holgiw/TFT-Clock-GC9A01/pictures/20261001_135719.jpg

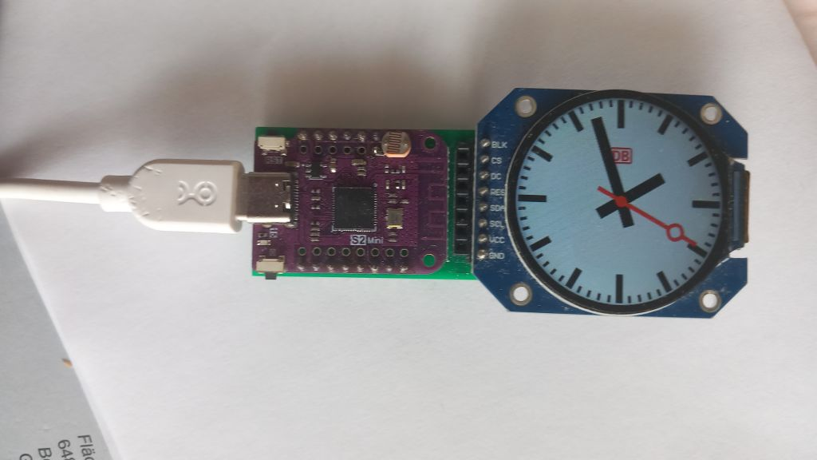
pictures/20261001_135719.jpg
