holgiw/TFT-Clock-GC9A01/graphic/160/face_clock_alt1.bmp

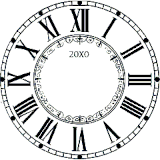
graphic/160/face_clock_alt1.bmp
