holgiw/TFT-Clock-GC9A01/graphic/160/face_daniel.bmp

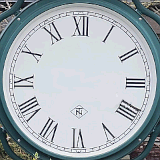
graphic/160/face_daniel.bmp
