holgiw/TFT-Clock-GC9A01/graphic/240/face_daniel.bmp

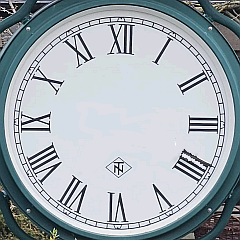
graphic/240/face_daniel.bmp
