holgiw/TFT-Clock-GC9A01/graphic/240/face_easterbunny.bmp

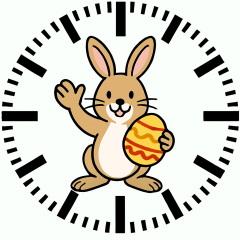
graphic/240/face_easterbunny.bmp
