holgiw/TFT-Clock-GC9A01/PCB/ELV_DCF77.jpg

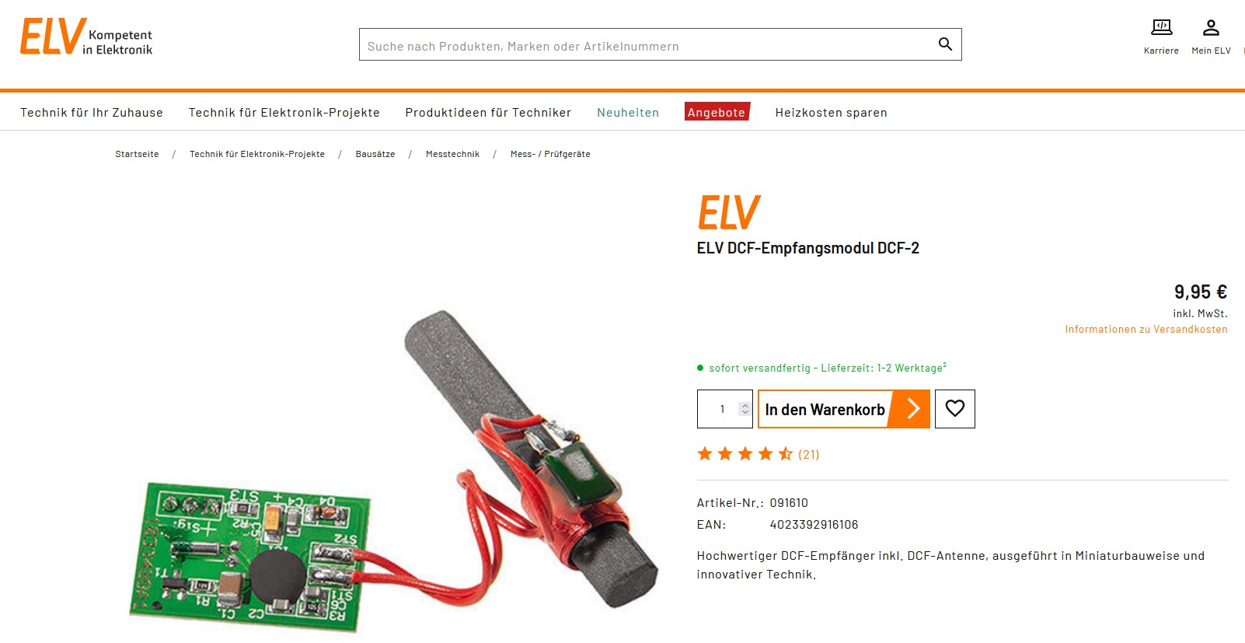
PCB/ELV_DCF77.jpg
