holgiw/TFT-Clock-GC9A01/PCB/ESP32-S2 GC9A01_RTC.jpg

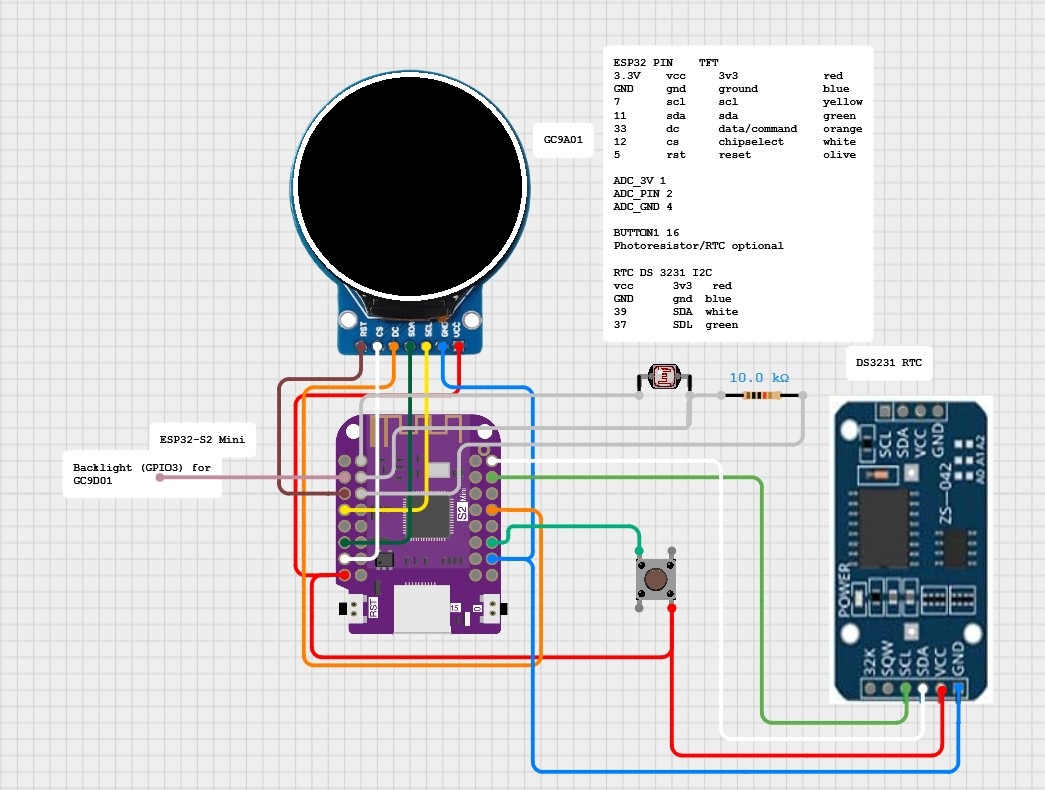
PCB/ESP32-S2 GC9A01_RTC.jpg
