holgiw/TFT-Clock-GC9A01/PCB/ESP32-S2 GC9A01_RTC_DCF77.jpg

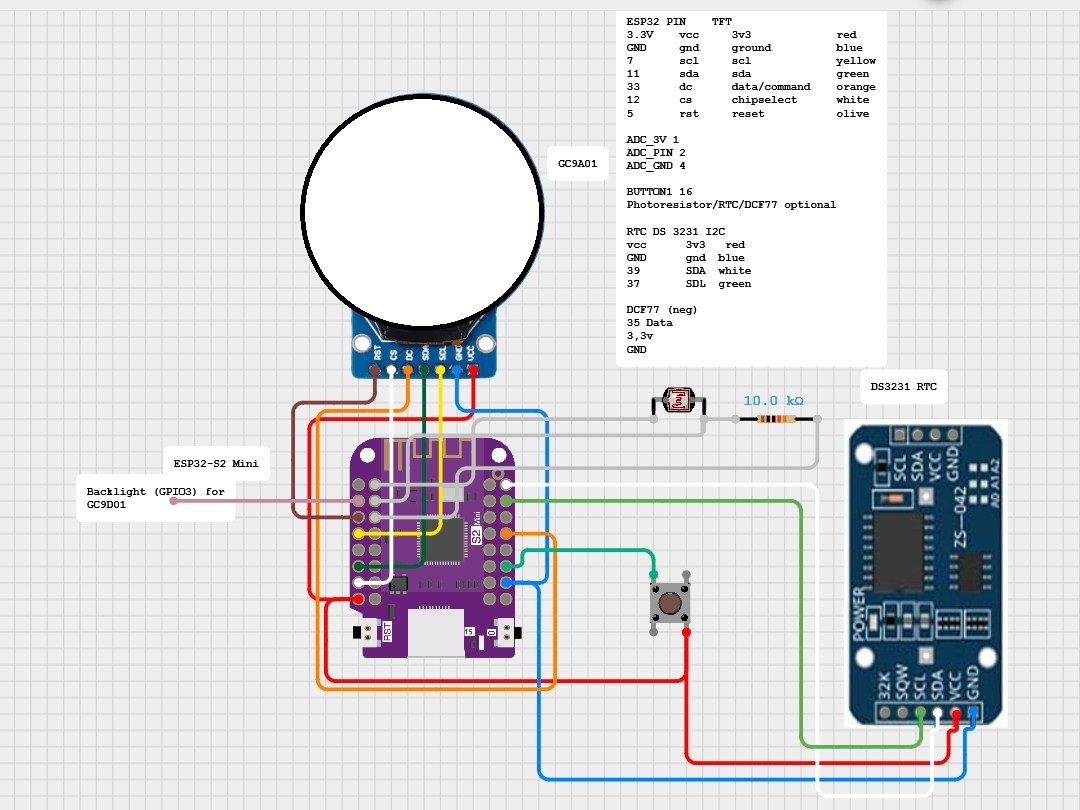
PCB/ESP32-S2 GC9A01_RTC_DCF77.jpg
