holgiw/TFT-Clock-GC9A01/PCB/esp32-s2_mini.png

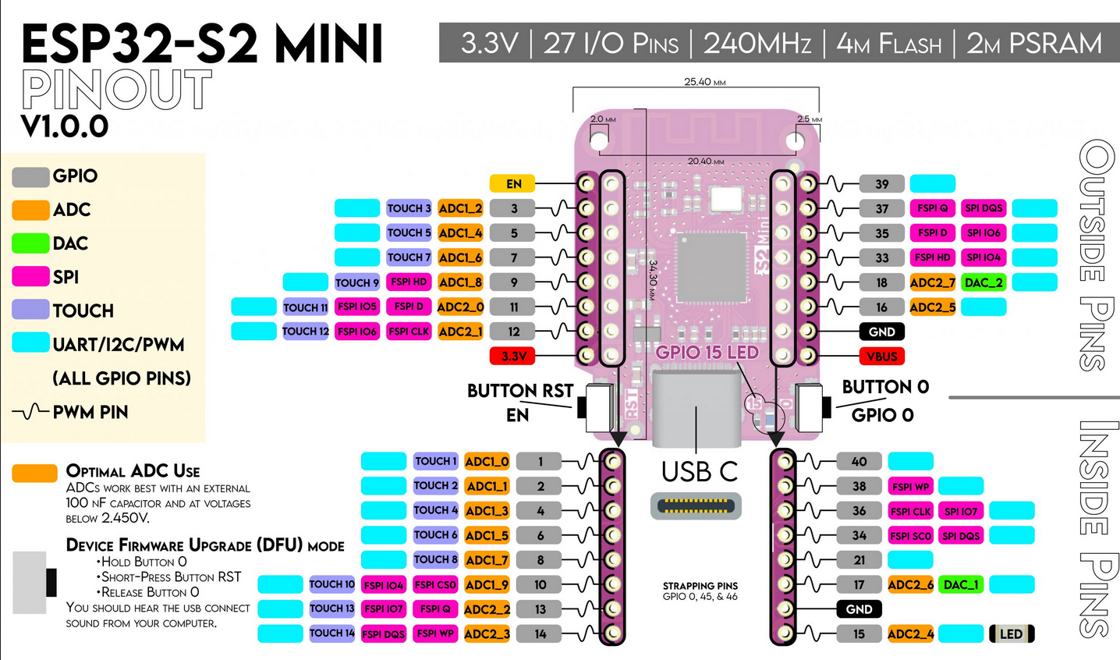
PCB/esp32-s2_mini.png
