holgiw/TFT-Clock-GC9A01/pictures/20261001_135748.jpg

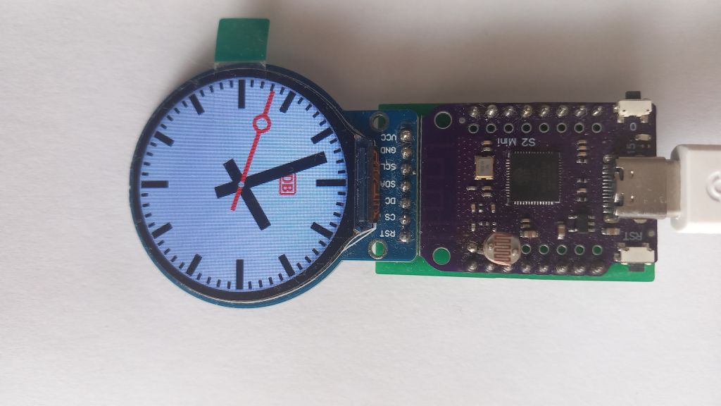
pictures/20261001_135748.jpg
