holgiw/TFT-Clock-GC9A01/pictures/20261001_135905.jpg

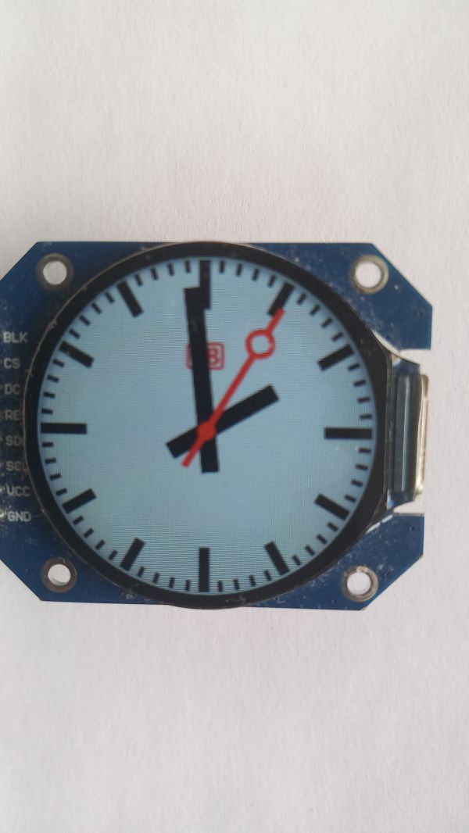
pictures/20261001_135905.jpg
