holgiw/TFT-Clock-GC9A01/pictures/20261001_140028.jpg

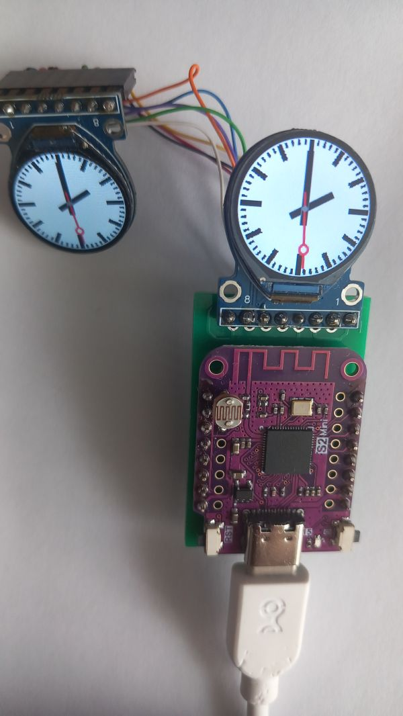
pictures/20261001_140028.jpg
