holgiw/TFT-Clock-GC9A01/pictures/20261007_082601.jpg

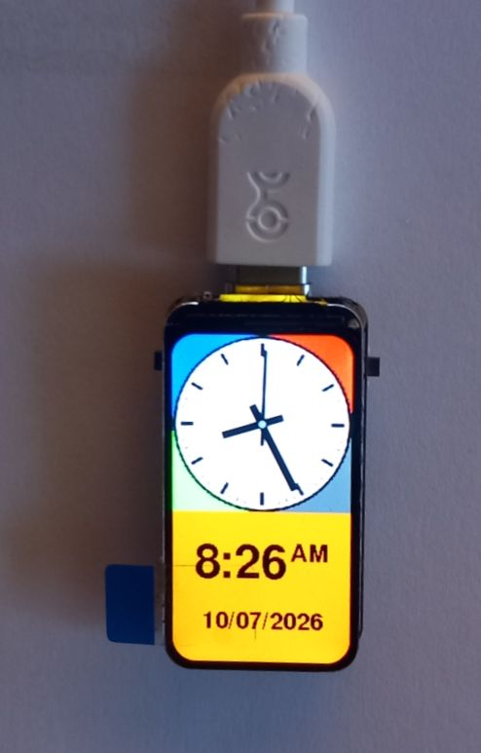
pictures/20261007_082601.jpg
