holgiw/TFT-Clock-GC9A01/screenshots/de/dateimanager.png

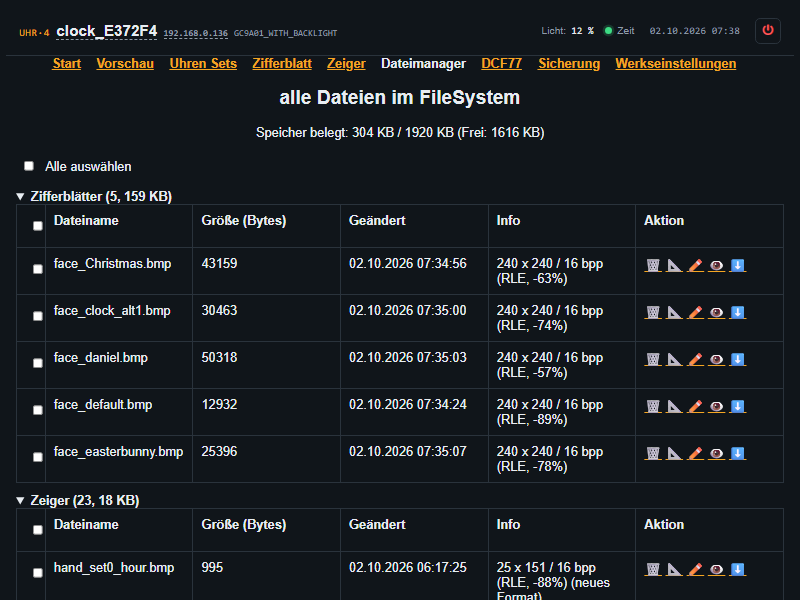
screenshots/de/dateimanager.png
