holgiw/TFT-Clock-GC9A01/screenshots/de/dcf77.png

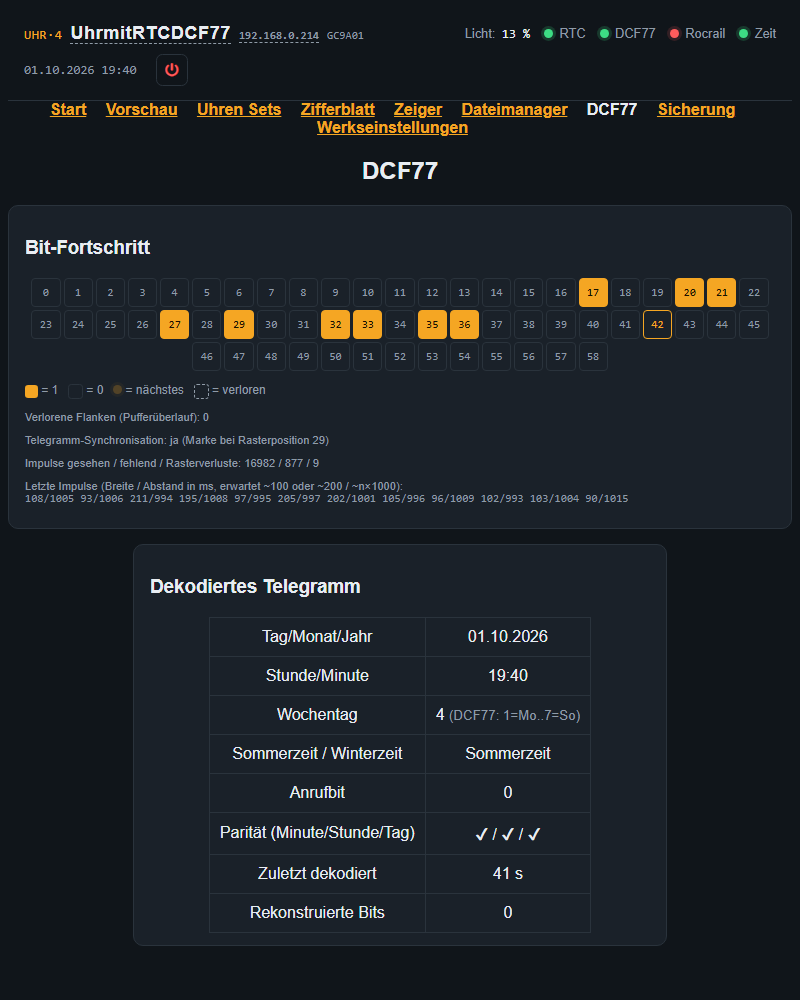
screenshots/de/dcf77.png
