holgiw/TFT-Clock-GC9A01/screenshots/de/helligkeit.png

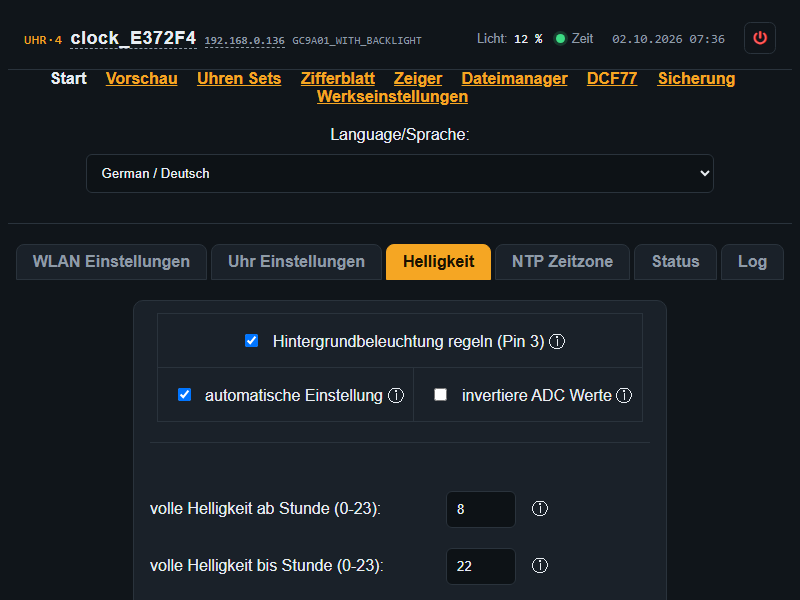
screenshots/de/helligkeit.png
