holgiw/TFT-Clock-GC9A01/screenshots/de/options.png

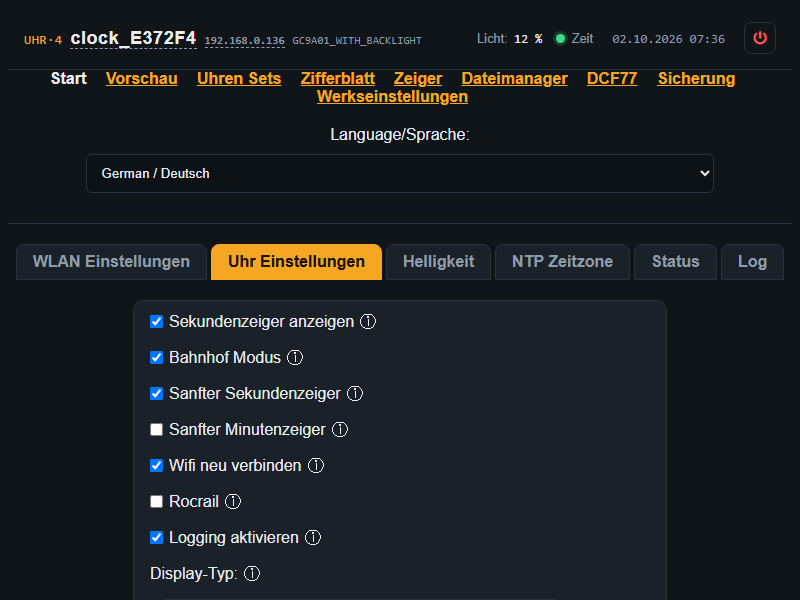
screenshots/de/options.png
