holgiw/TFT-Clock-GC9A01/screenshots/de/rocrail.png

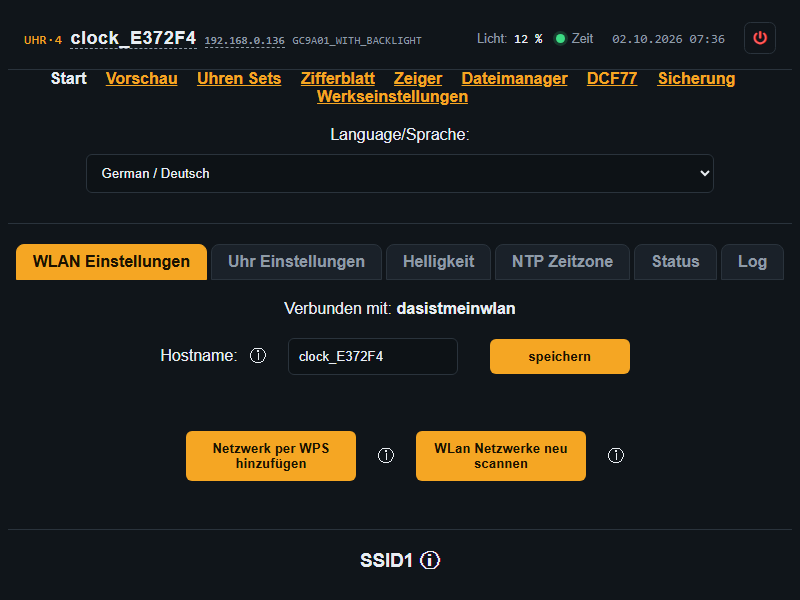
screenshots/de/rocrail.png
