holgiw/TFT-Clock-GC9A01/screenshots/de/sets.png

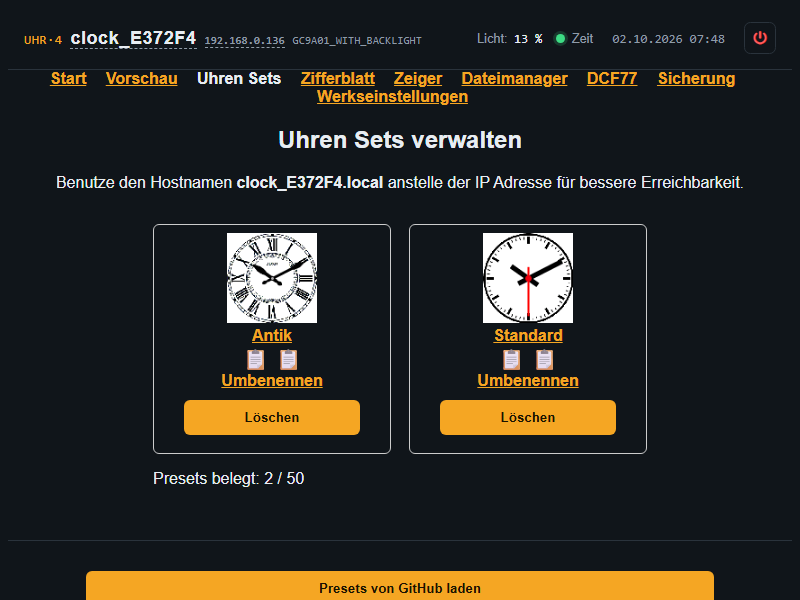
screenshots/de/sets.png
