holgiw/TFT-Clock-GC9A01/screenshots/de/vorschau.png

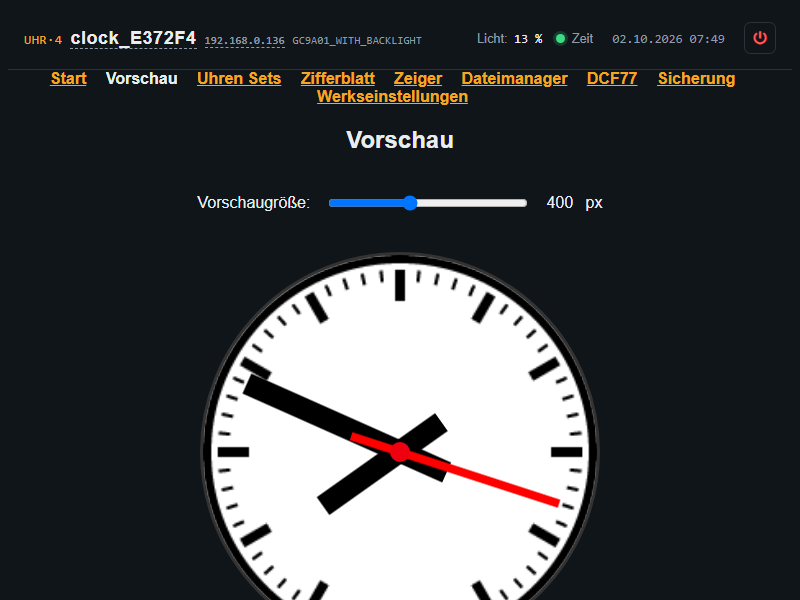
screenshots/de/vorschau.png
