holgiw/TFT-Clock-GC9A01/screenshots/de/vorschau_ili.png

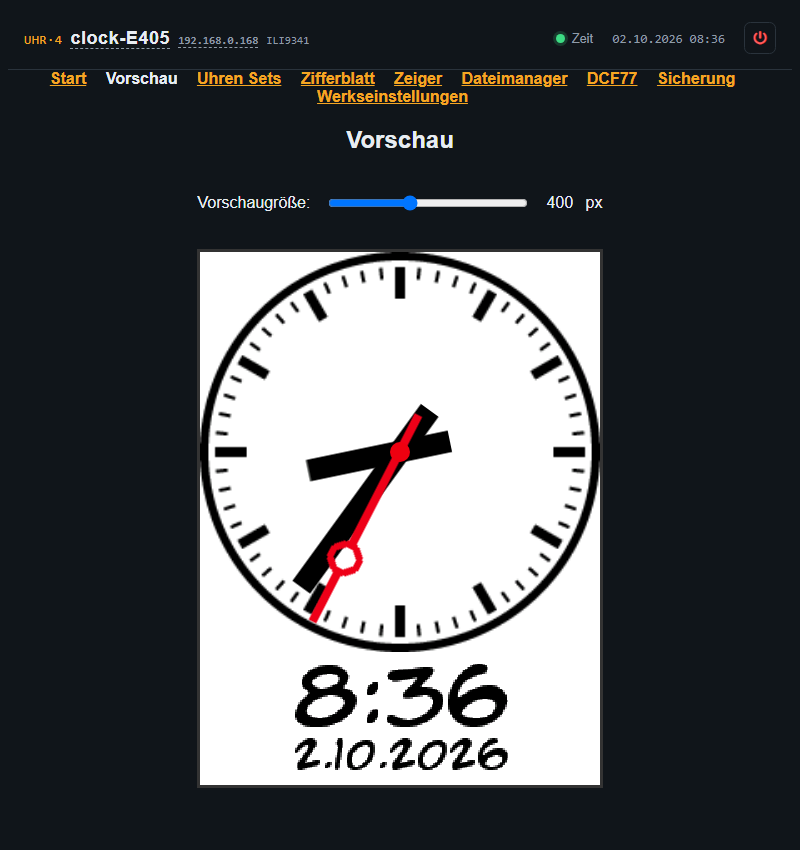
screenshots/de/vorschau_ili.png
