holgiw/TFT-Clock-GC9A01/screenshots/de/zeiger.png

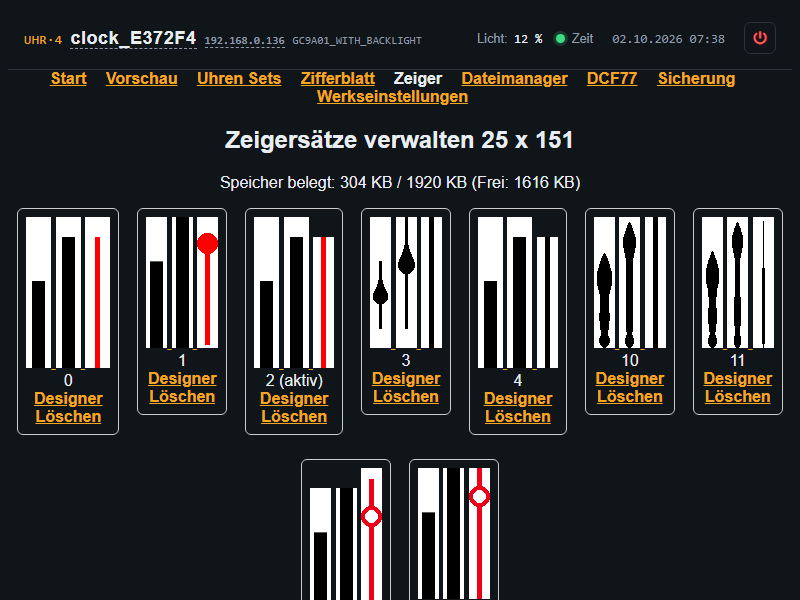
screenshots/de/zeiger.png
