holgiw/TFT-Clock-GC9A01/screenshots/de/zeiger_designer.png

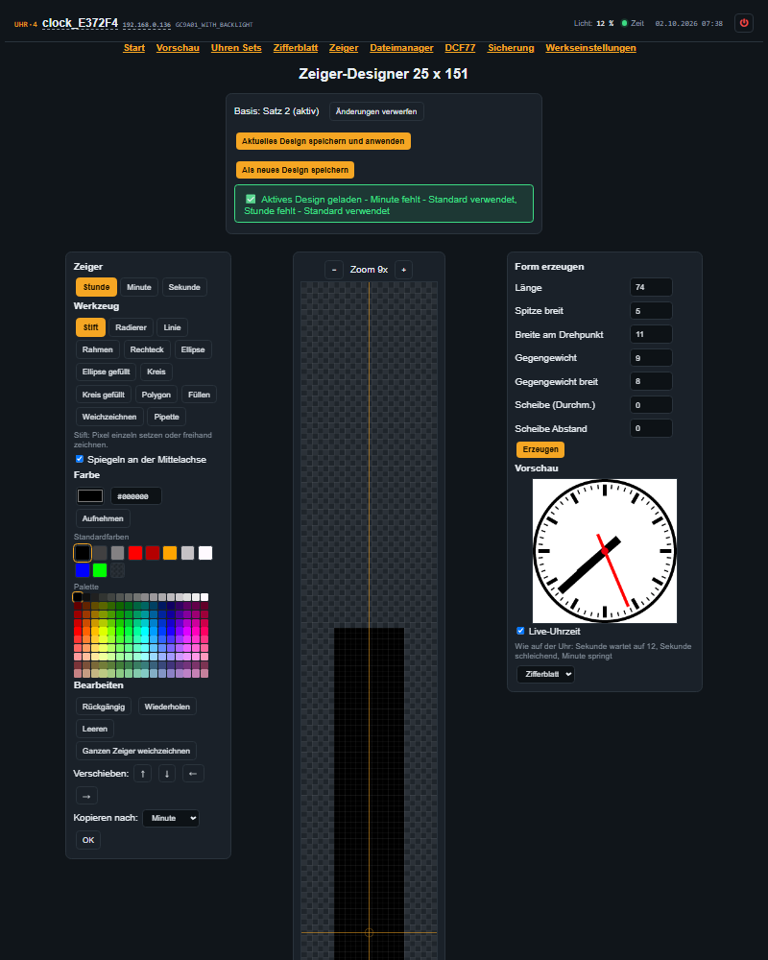
screenshots/de/zeiger_designer.png
