holgiw/TFT-Clock-GC9A01/screenshots/de/zifferblatt.png

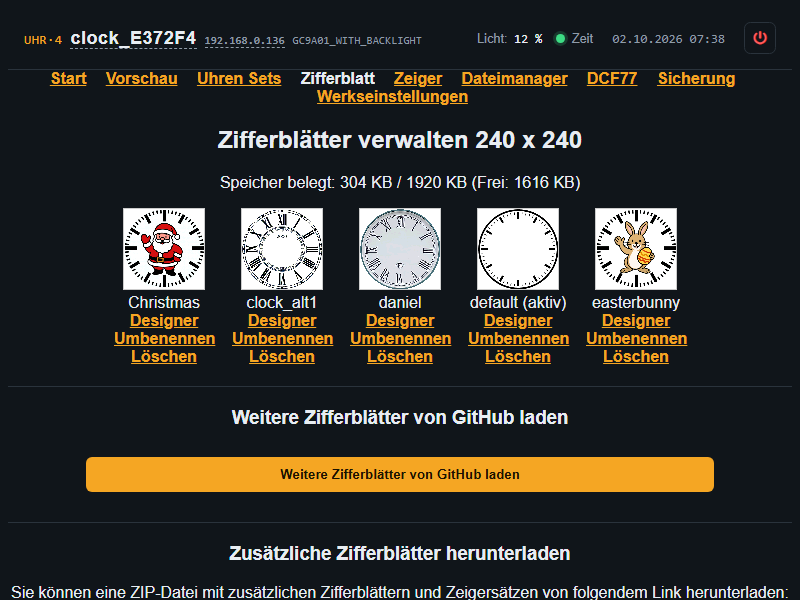
screenshots/de/zifferblatt.png
