holgiw/TFT-Clock-GC9A01/screenshots/de/zifferblatt_designer.png

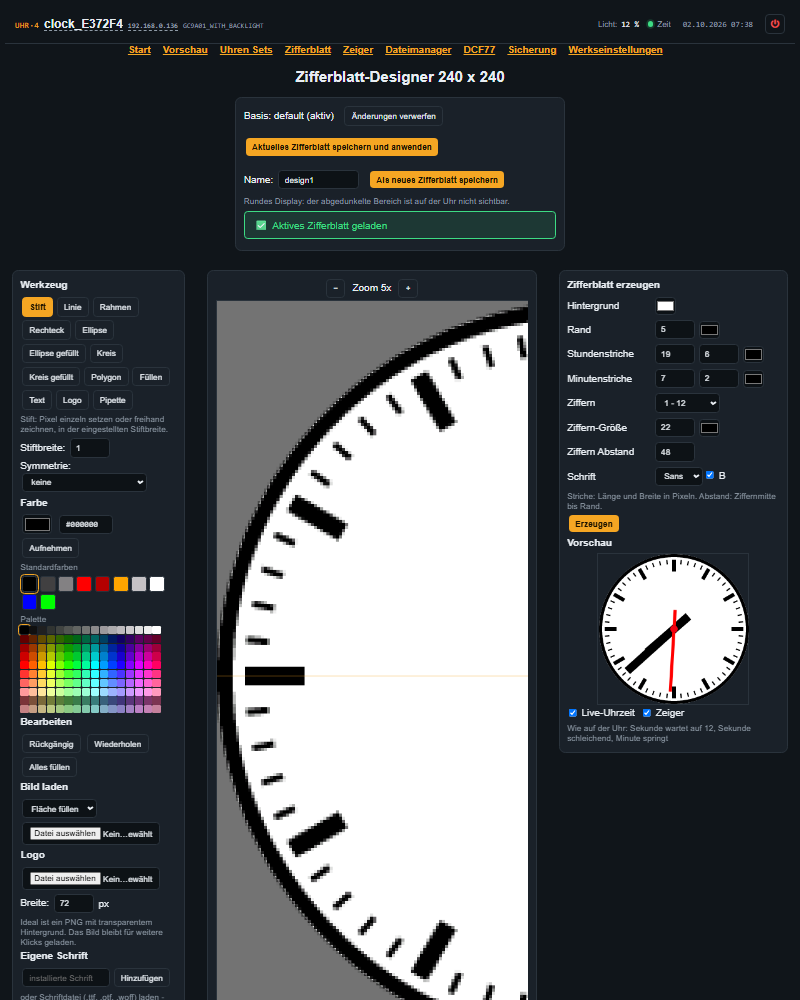
screenshots/de/zifferblatt_designer.png
