holgiw/TFT-Clock-GC9A01/screenshots/de/zifferblatt_designer_ili.png

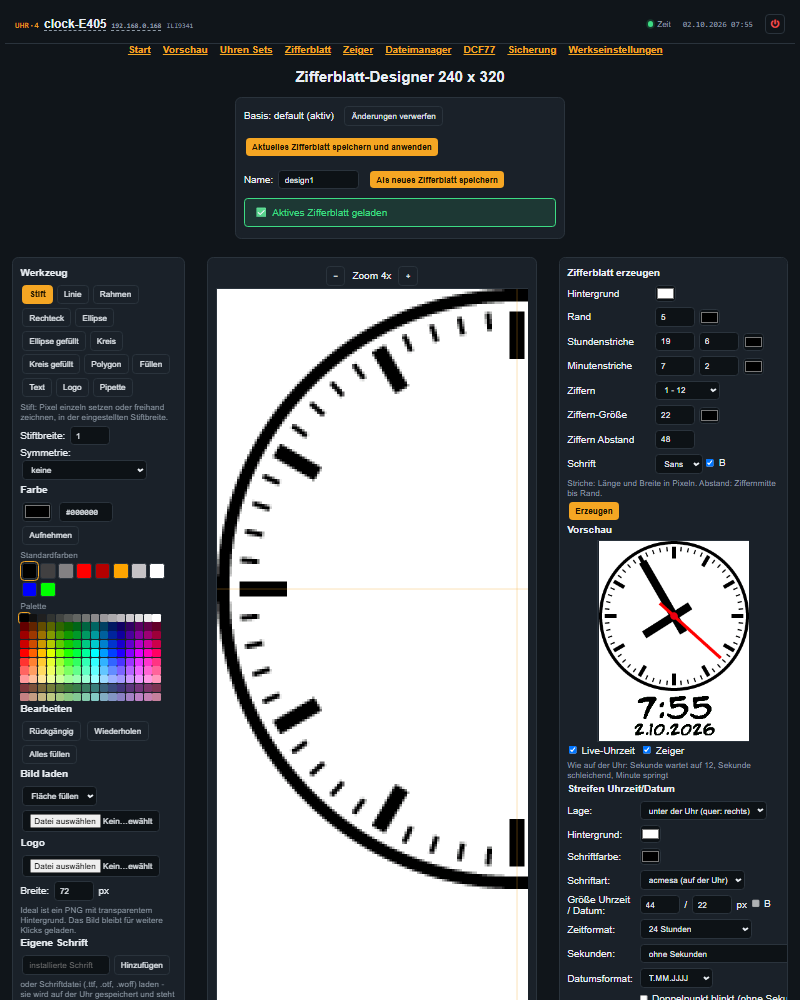
screenshots/de/zifferblatt_designer_ili.png
