holgiw/TFT-Clock-GC9A01/screenshots/en/brightness.png

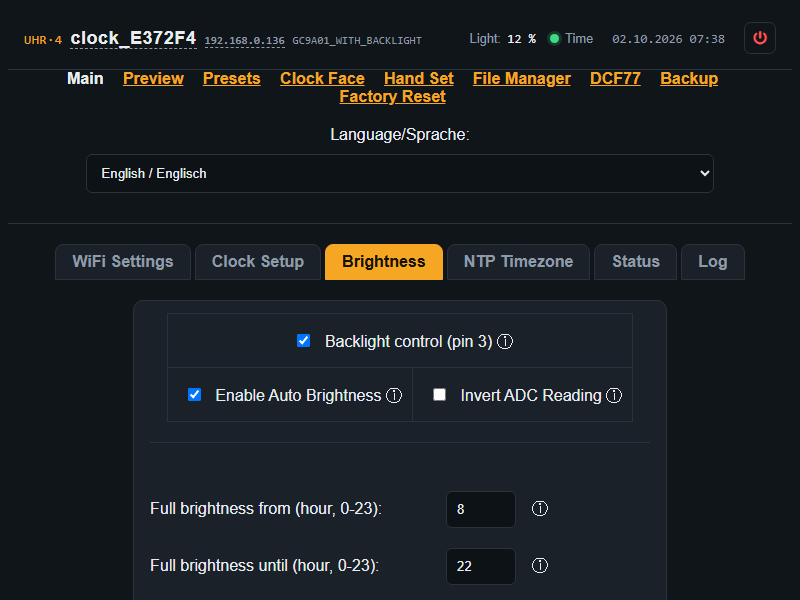
screenshots/en/brightness.png
