holgiw/TFT-Clock-GC9A01/screenshots/en/clock_faces.png

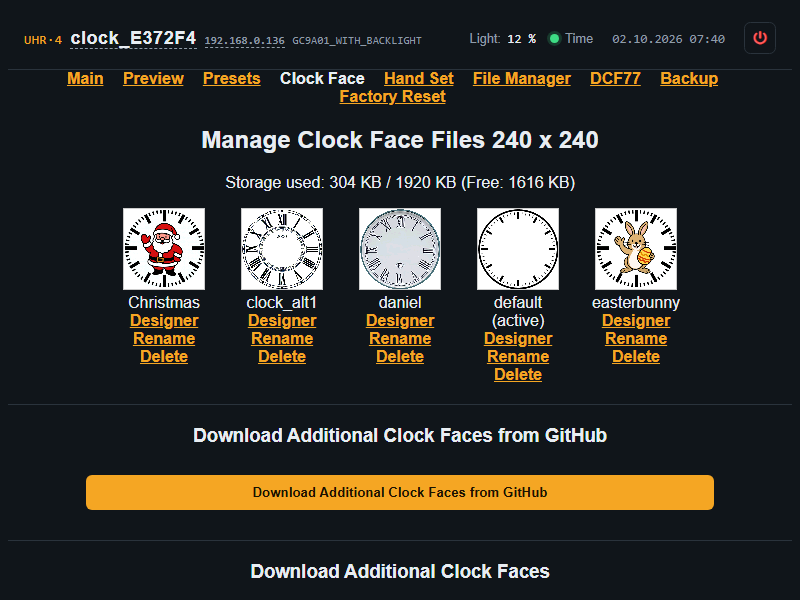
screenshots/en/clock_faces.png
