holgiw/TFT-Clock-GC9A01/screenshots/en/dcf77.png

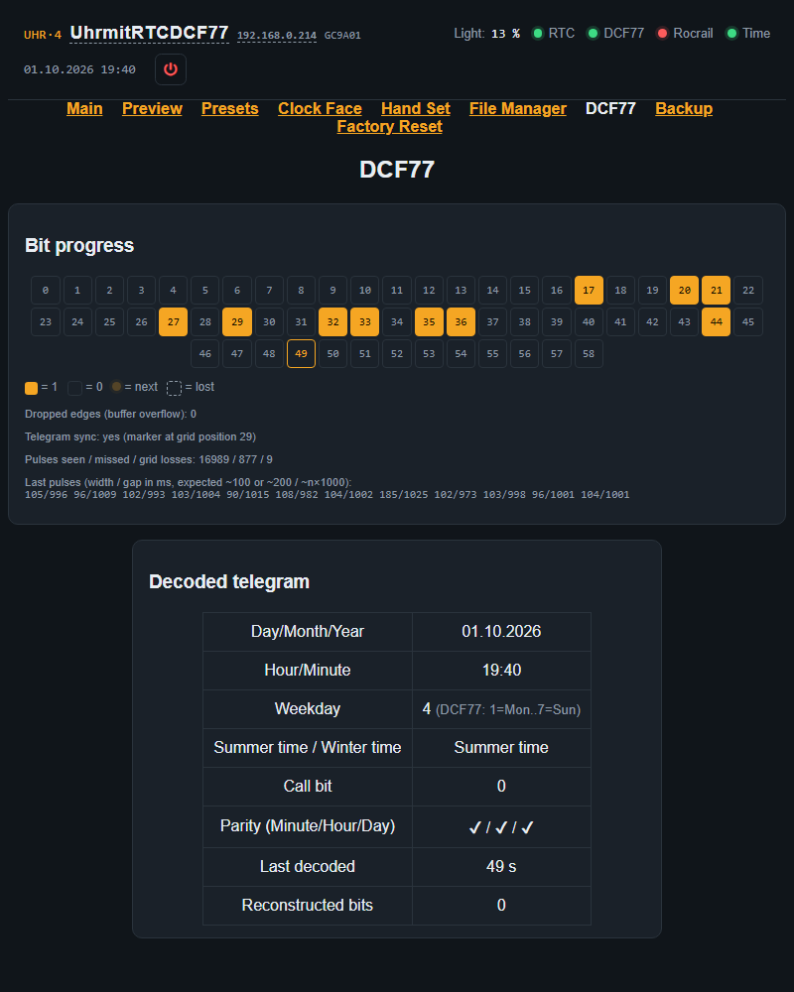
screenshots/en/dcf77.png
