holgiw/TFT-Clock-GC9A01/screenshots/en/hand_designer.png

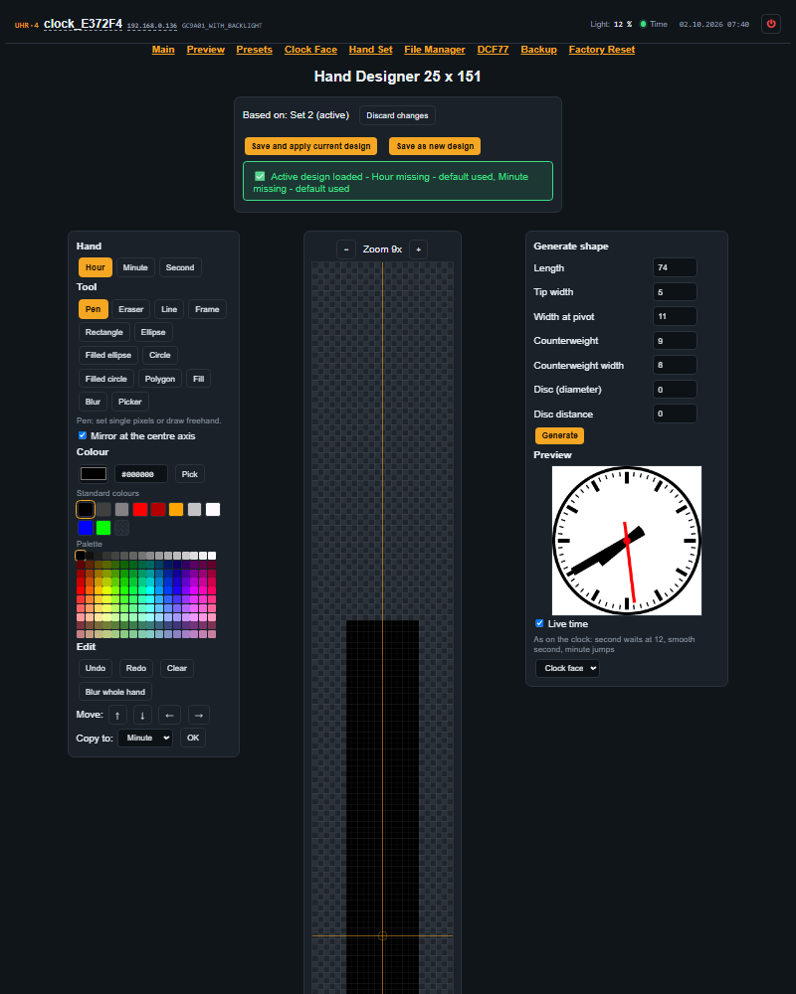
screenshots/en/hand_designer.png
