holgiw/TFT-Clock-GC9A01/screenshots/en/preview_ili.png

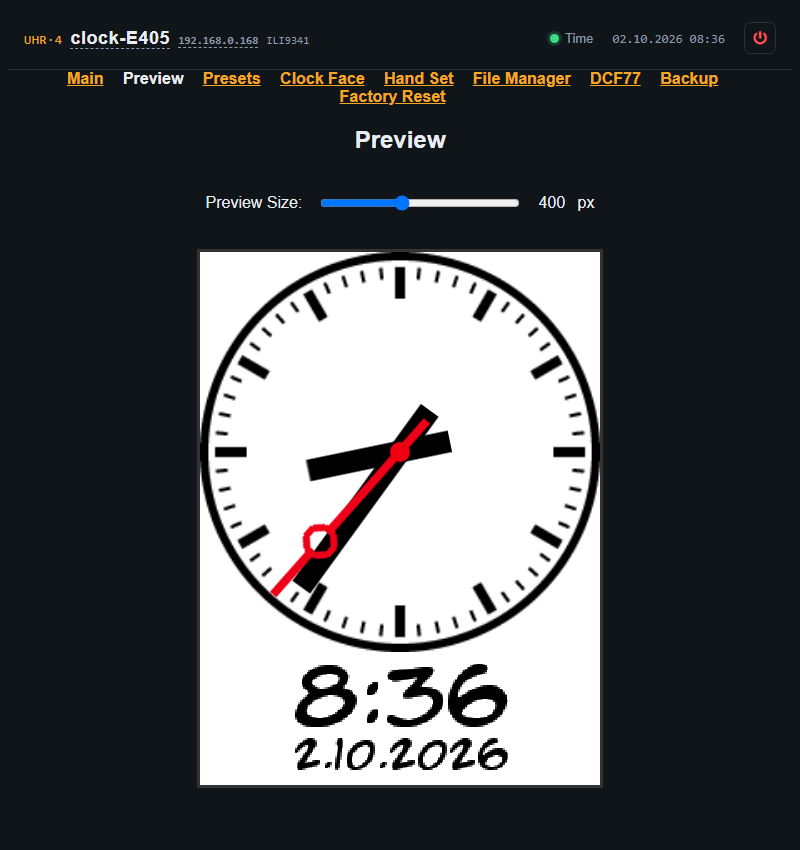
screenshots/en/preview_ili.png
