holgiw/TFT-Clock-GC9A01/screenshots/en/rocrail.png

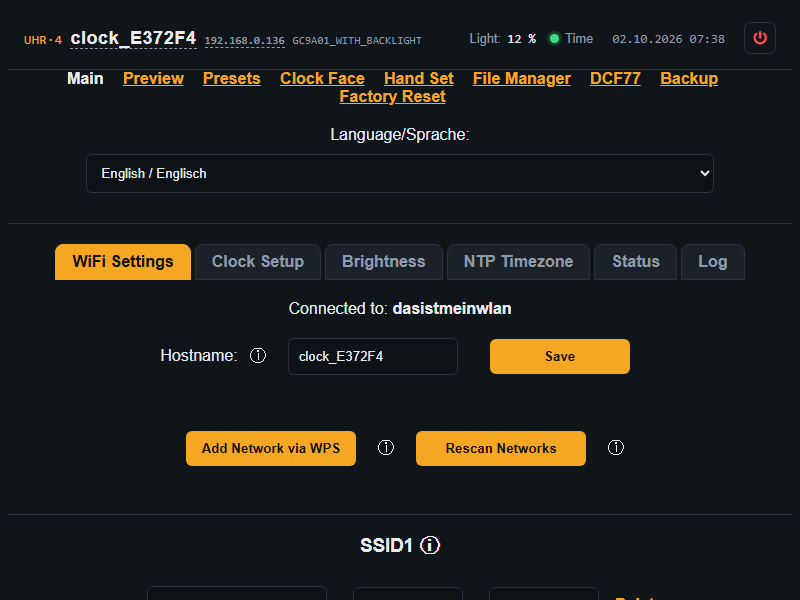
screenshots/en/rocrail.png
