holgiw/TFT-Clock-GC9A01/3d-print/senkrechte_platte_19x30.stl

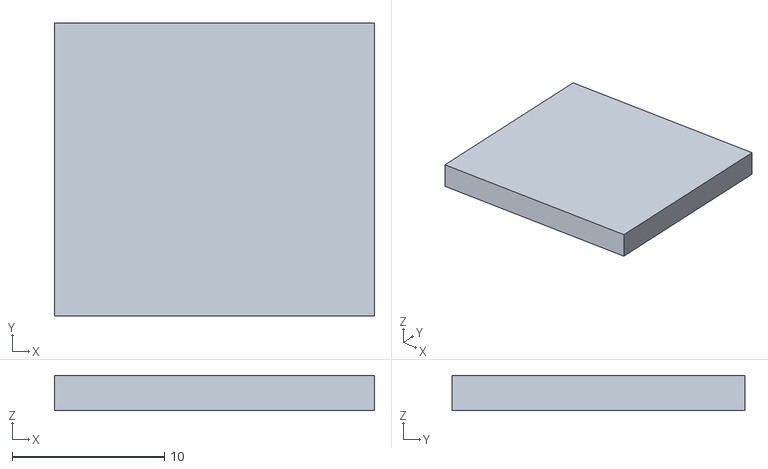
[picture p37: CAD file, 2025-06-24]
3d-print/senkrechte_platte_19x30.stl
21.0 x 19.2 x 2.30
