holgiw/TFT-Clock-GC9A01/3d-print/Grundplatte_rund_Glaskoben.stl

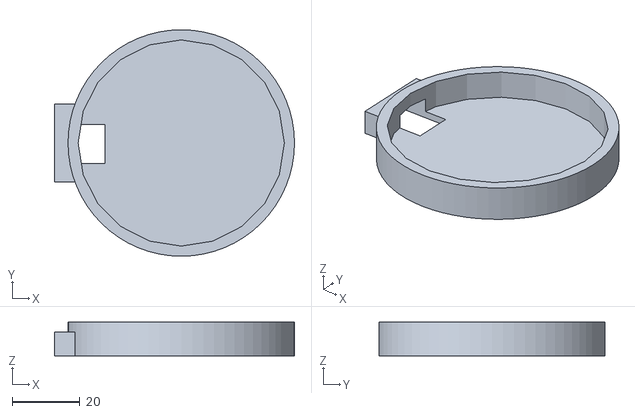
[picture p38: CAD file, 2025-06-24]
3d-print/Grundplatte_rund_Glaskoben.stl
71.0 x 67.0 x 10.0
