holgiw/TFT-Clock-GC9A01/screenshots/en/clock_setup.png

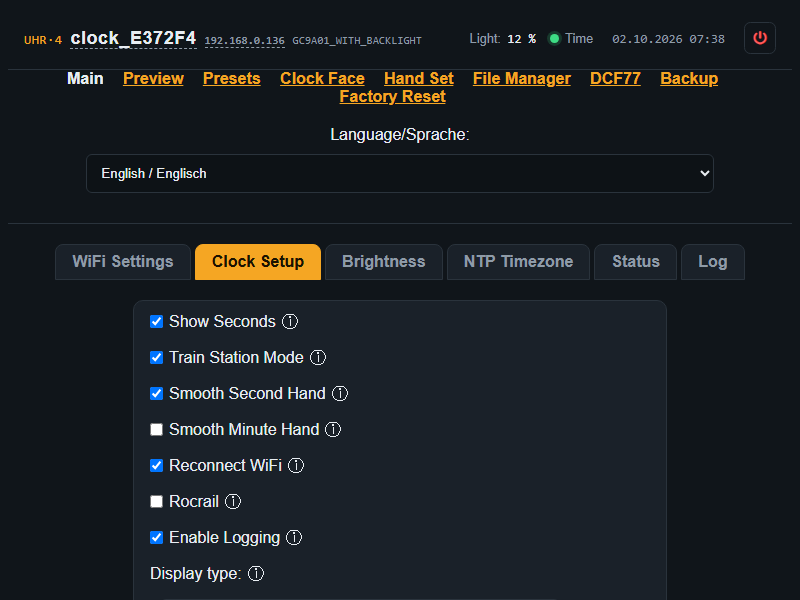
screenshots/en/clock_setup.png
