holgiw/TFT-Clock-GC9A01/(list of files, drawings)

Other design files:
PCB/clock_esp32_S2_mini.lay6
PCB/clock_esp32_S2_mini_RTC.lay6
