holgiw/TFT-Clock-GC9A01/webserver_routes.h

#pragma once

    // Alle HTTP-Routen und HTML-Generierung (benoetigt globals.h, config.h, prefs_keys.h, declarations.h).
    // new (std::nothrow) liefert bei fehlgeschlagener Allokation sicher nullptr.

    // All HTTP routes and HTML generation (requires globals.h, config.h, prefs_keys.h, declarations.h). new
    // (std::nothrow) reliably returns nullptr on a failed allocation.

#include <new>

    // Tab-Leiste der Startseite an EINER Stelle: Reihenfolge = Anzeige-
    // reihenfolge, index-gleich zu SETTINGS_TAB_LABELS. Genutzt von
    // generateHtmlHeader(), den Radio-Inputs und generateSettingsTabNav().

    // The start page's tab bar in ONE place: order = display order, index-
    // aligned with SETTINGS_TAB_LABELS. Used by generateHtmlHeader(), the
    // start page's radio inputs, and generateSettingsTabNav().

    static const char* const SETTINGS_TAB_KEYS[] = { "wlan", "zifferblatt", "helligkeit", "zeit", "rocrail", "status", "log" };

    // Uebersetzungsschluessel je Tab (siehe translation.h). "Status"/"Log"
    // stehen bewusst am Ende (Diagnose nach dem Einrichtungsablauf).
    // "Rocrail" bleibt unuebersetzt, wie auch "DCF77" ein Protokollname bleibt.

    // Translation key per tab (see translation.h). "Status"/"Log" are
    // deliberately last (diagnostics after the setup flow). "Rocrail" stays
    // untranslated, the same way "DCF77" stays a protocol name.

    static const char* const SETTINGS_TAB_LABELS[] = { "WiFi Settings", "Clock Setup", "Brightness", "NTP&nbsp;Timezone", "Rocrail", "Status", "Log" };

    static const size_t SETTINGS_TAB_COUNT = sizeof(SETTINGS_TAB_KEYS) / sizeof(SETTINGS_TAB_KEYS[0]);


    // Generiert den HTML-Header für die Weboberfläche
    // Generates the HTML header for the web interface

    String generateHtmlHeader(String extraHead) {
        String html = "<!DOCTYPE html><html><head><meta name=\"viewport\" content=\"width=device-width, initial-scale=1\">";
        html.reserve(5000);  // Vorab reservierter Speicher fuer CSS+HTML
                              // Pre-reserved capacity for CSS+HTML

        // Dunkles Theme mit CSS-only Tab-Mechanik (verstecktes radio-Input +
        // Label + Selektor "~") fuer die Tab-Hub-Startseite. Gilt sitenweit,
        // damit alle Seiten optisch einheitlich bleiben.

        // Dark theme with a CSS-only tab mechanism (hidden radio input +
        // label + "~" selector) for the tab-hub home page. Applies site-wide
        // so every page stays visually consistent.

        html += "<style>";
        html += ":root{--bg:#10151a;--panel:#1a2129;--panel-border:#2a333c;--text:#e8edf2;--muted:#8f9ba7;--accent:#f5a623;--accent-dim:#7a530f;--ok:#3ddc84;--bad:#ff5c5c;--mono:ui-monospace,\"SFMono-Regular\",Menlo,Consolas,monospace;}";

        // Meldungen einheitlich im dunklen Design: .msg.ok Erfolg, .msg.warn Hinweis, .msg.err Fehler - das Symbol
        // setzt das CSS, der Text bleibt ohne.

        // Messages uniform in the dark design: .msg.ok success, .msg.warn note, .msg.err error - the CSS sets the
        // symbol, the text stays without.

        html += ".msg{border:1px solid;border-radius:6px;padding:10px 15px;margin:10px auto;max-width:500px;}";
        html += ".msg::before{margin-right:.45em;}";
        html += ".msg.ok{background:rgba(61,220,132,.12);color:var(--ok);border-color:var(--ok);}.msg.ok::before{content:\"\\2705\";}";
        html += ".msg.warn{background:rgba(245,166,35,.12);color:var(--accent);border-color:var(--accent);}.msg.warn::before{content:\"\\26A0\";}";
        html += ".msg.err{background:rgba(255,92,92,.12);color:var(--bad);border-color:var(--bad);}.msg.err::before{content:\"\\274C\";}";

        // Bewusst kein padding-top auf body: die Topbar ist sticky
        // positioniert und wuerde sonst mitverschoben statt nur der Inhalt
        // darunter.

        // Deliberately no padding-top on body: the topbar is sticky-
        // positioned and would otherwise shift down too, not just the
        // content below it.

        html += "body{font-family:Arial,Helvetica,sans-serif;text-align:center;background:var(--bg);color:var(--text);}";
        html += "input,select,button{margin:10px;padding:10px;width:80%;box-sizing:border-box;background:#0d1216;color:var(--text);border:1px solid var(--panel-border);border-radius:6px;}";
        html += "input[type=checkbox],input[type=radio]{width:auto;}";
        html += "button,button[type=submit],input[type=submit]{background:var(--accent);color:#1a1200;font-weight:bold;border:none;cursor:pointer;}";
        html += "button:hover,input[type=submit]:hover{background:#ffb84d;}";
        html += "h1,h2,h3{color:var(--text);}";
        html += "hr{border:0;height:1px;background-color:var(--panel-border);margin:20px 0;}";
        html += "table{margin:auto;border-collapse:collapse;}"; // Tabellen zentrieren
                                                                // center tables
        html += "th,td{padding:10px;text-align:center;border:1px solid var(--panel-border);}"; // Tabellenzellen
                                                                                               // table cells
        html += "li{text-align:left;color:var(--text);}"; // <li> linksbündig formatieren
                                                          // left-align <li>
        html += "a{color:var(--accent);}";
        html += "small{color:var(--muted);}";

        // Statuszeile (Topbar), sitenweit oben auf jeder Seite - siehe
        // generateTopBar() fuer die Markup-Erzeugung.

        // Status bar (topbar), site-wide at the top of every page - see
        // generateTopBar() for the markup generation.

        html += ".topbar{display:flex;flex-wrap:wrap;align-items:center;gap:.6rem 1.2rem;padding:.9rem 1rem;border-bottom:1px solid var(--panel-border);position:sticky;top:0;background:var(--bg);z-index:5;}";
        html += ".brand{display:flex;align-items:baseline;gap:.5rem;margin-right:auto;}";
        html += ".brand-mark{font-family:var(--mono);color:var(--accent);font-size:.8rem;letter-spacing:.05em;}";
        html += ".topbar h1{font-size:1.15rem;margin:0;letter-spacing:.02em;}";
        html += ".topbar h1 a.host-link{color:inherit;text-decoration:none;border-bottom:1px dashed var(--muted);}";
        html += ".topbar h1 a.host-link:hover{color:var(--accent);border-bottom-color:var(--accent);}";
        html += ".ip-hint{font-family:var(--mono);font-size:.7rem;color:var(--muted);}";

        // font-size hier bewusst "inherit" statt weggelassen, um nicht von
        // Vererbung abhaengig zu sein, falls spaeter eine Regel dazwischenfunkt.

        // font-size deliberately "inherit" rather than omitted, to not rely
        // on inheritance in case another rule interferes later.

        html += ".ip-hint a{color:inherit;font-size:inherit;text-decoration:none;border-bottom:1px dashed var(--muted);}";
        html += ".ip-hint a:hover{color:var(--accent);border-bottom-color:var(--accent);}";
        html += ".status-strip{display:flex;gap:.9rem;flex-wrap:wrap;}";
        html += ".status{display:flex;align-items:center;gap:.4rem;font-size:.8rem;color:var(--muted);}";

        // .status setzt "display:flex", was das native 'hidden'-Attribut
        // ueberschreibt (Autoren-CSS gewinnt immer gegen User-Agent-CSS).
        // Diese Regel stellt das 'hidden'-Verhalten explizit wieder her.

        // .status sets "display:flex", which overrides the native 'hidden'
        // attribute (author CSS always wins over user-agent CSS). This rule
        // explicitly restores 'hidden' behavior.

        html += ".status[hidden]{display:none;}";

        // display:inline-block noetig, sonst ignorieren Browser width/height
        // bei einem leeren <span> ausserhalb eines Flex-Kontexts (.status) -
        // der Punkt wuerde eckig statt rund erscheinen.

        // display:inline-block needed, otherwise browsers ignore width/height
        // on an empty <span> outside a flex context (.status) - the dot
        // would render square instead of round.

        html += ".dot{display:inline-block;width:.55rem;height:.55rem;border-radius:50%;background:var(--bad);box-shadow:0 0 0 3px rgba(255,92,92,.15);}";
        html += ".dot.ok{background:var(--ok);box-shadow:0 0 0 3px rgba(61,220,132,.18);}";

        // "na" (grau) gilt nur fuer den Zeit-Punkt (Systemzeit noch nie gesetzt) - bei RTC/DCF77 blendet
        // fehlende Hardware den ganzen Eintrag aus.

        // "na" (gray) only applies to the Time dot (system time never set) - for RTC/DCF77, missing hardware
        // hides the whole entry.

        html += ".dot.na{background:var(--muted);box-shadow:0 0 0 3px rgba(143,155,167,.18);}";

        // Live-Wertanzeige (z.B. Fotowiderstand-Helligkeit) statt farbigem
        // Punkt - heller Monospace-Text, analog zum Kontrast von .datetime
        // gegenueber seinem Muted-Label.

        // Live value reading (e.g. photoresistor brightness) instead of a
        // colored dot - bright monospace text, mirroring the contrast of
        // .datetime against its muted label.

        html += ".statval{font-family:var(--mono);color:var(--text);}";

        // "syncing" (DCF77): Empfaenger bekommt Impulse, hat aber noch kein
        // gueltiges Zeittelegramm dekodiert - gelb blinkend statt rot.

        // "syncing" (DCF77): receiver gets pulses but hasn't decoded a valid
        // time telegram yet - blinking yellow instead of red.

        html += ".dot.syncing{background:var(--accent);box-shadow:0 0 0 3px rgba(245,166,35,.18);animation:dotBlink 1s ease-in-out infinite;}";
        html += "@keyframes dotBlink{0%,100%{opacity:1;}50%{opacity:.25;}}";

        // prefers-reduced-motion: feste gedimmte Opazitaet statt Blinken.
        // prefers-reduced-motion: fixed dimmed opacity instead of blinking.

        html += "@media (prefers-reduced-motion:reduce){.dot.syncing{animation:none;opacity:.6;}}";
        html += ".datetime{font-family:var(--mono);font-size:.8rem;color:var(--muted);}";

        // Zeigt an, dass /api/topbarStatus mehrfach fehlschlug und die
        // angezeigten Werte veraltet sein koennen.

        // Indicates /api/topbarStatus failed repeatedly and the displayed
        // values may be stale.

        html += ".offline-hint{display:none;color:var(--bad);font-size:.75rem;margin-left:.3rem;}";
        html += ".offline-hint.show{display:inline;}";

        // margin/padding hier explizit 0 - sonst greift die allgemeine
        // input/select/button-Regel und sprengt die kompakte Topbar.

        // margin/padding explicitly 0 here - otherwise the general
        // input/select/button rule applies and blows up the compact topbar.

        html += ".reset-btn{background:transparent;border:1px solid var(--panel-border);color:var(--bad);border-radius:.4rem;width:2rem;height:2rem;padding:0;margin:0;font-size:1rem;line-height:1;cursor:pointer;}";
        html += ".reset-btn:hover{border-color:var(--bad);background:rgba(255,92,92,.12);}";
        html += ".reset-btn:focus-visible{outline:2px solid var(--bad);outline-offset:1px;}";

        // Tabs nur mit CSS: Radios ausblenden, Panels per :checked ~ .panel-X einblenden. Radios, .tabnav und
        // .panel-* muessen direkte Geschwister sein.

        // CSS-only tabs: hide radios, show panels via :checked ~ .panel-X. Radios, .tabnav and .panel-* must
        // be direct siblings.

        html += ".tabctrl{display:none;}";
        html += ".tabnav{margin:20px auto;max-width:900px;display:flex;flex-wrap:wrap;justify-content:center;gap:4px;}";
        html += ".tabnav label{background:var(--panel);border:1px solid var(--panel-border);color:var(--muted);padding:8px 16px;border-radius:8px 8px 0 0;cursor:pointer;font-weight:bold;}";
        html += ".tabpanel{display:none;}";
        html += ".card{background:var(--panel);border:1px solid var(--panel-border);border-radius:10px;max-width:500px;margin:15px auto;padding:12px 16px;text-align:left;}";
        for (size_t i = 0; i < SETTINGS_TAB_COUNT; i++) {
            String t = String(SETTINGS_TAB_KEYS[i]);
            html += String("#tab-") + t + ":checked ~ .tabnav label[for='tab-" + t + "']{background:var(--accent);border-color:var(--accent);color:#1a1200;}";
            html += String("#tab-") + t + ":checked ~ .panel-" + t + "{display:block;}";
        }
        html += "</style>" + extraHead + "</head><body>";

        // Statuszeile vor der JS-Warnung, da generateHtmlHeader() von jeder Seite eingebunden wird
        // Status bar before the JS warning, since every page includes generateHtmlHeader()

        html += generateTopBar();

        // Seite benötigt JavaScript
        // Page requires JavaScript

        html += "<noscript><div style='color:red;font-weight:bold;margin:20px;'>" +
                translate("JavaScript is disabled. This page requires JavaScript to work properly!") + "</div></noscript>";

        return html;
    }

    // Status der Topbar-Punkte (fuer generateTopBar() und /api/topbarStatus): "ok" gruen, "syncing" gelb
    // blinkend, "bad" rot, "na" grau bzw. ausgeblendet. Die Systemzeit kennt nur "ok"/"na".

    // Topbar dot status (for generateTopBar() and /api/topbarStatus): "ok" green, "syncing" blinking yellow,
    // "bad" red, "na" gray or hidden. System time only knows "ok"/"na".

    String getTimeStatus() {
        return (timeinfo.tm_year > 0) ? "ok" : "na";
    }


    // Ermittelt den RTC-Status aus rtcOk (siehe globals.h/checkRtcHealth()):
    // AVAILABLE->"ok", AVAILABLE_BUT_INVALID->"bad", NOT_AVAILABLE->"na".
    // Bei "na" blendet generateTopBar() den RTC-Eintrag komplett aus.

    // Determines RTC status from rtcOk (see globals.h/checkRtcHealth()):
    // AVAILABLE->"ok", AVAILABLE_BUT_INVALID->"bad", NOT_AVAILABLE->"na".
    // generateTopBar() fully hides the RTC entry on "na".

    String getRtcStatus() {
        if (rtcOk == RTC_AVAILABLE) return "ok";
        if (rtcOk == RTC_AVAILABLE_BUT_INVALID) return "bad";
        return "na";
    }


    // Ermittelt den DCF77-Status: "ok" wenn zuletzt erfolgreich dekodiert
    // (DCF77_SYNC_STALE_AFTER), sonst "syncing" solange noch Impulse kommen,
    // "na" ohne bestaetigten Empfang (dcf77Confirmed), sonst "bad".

    // Determines DCF77 status: "ok" if last decoded within
    // DCF77_SYNC_STALE_AFTER, else "syncing" while pulses still arrive,
    // "na" without confirmed reception (dcf77Confirmed), else "bad".

    String getDcf77Status() {

        // Ein einzelner Impuls (auch Rauschen) reicht nicht als Nachweis - siehe
        // DCF77_PRESENCE_MIN_STREAK/MAX_GAP_MS.

        // A single pulse (noise too) is no proof - see DCF77_PRESENCE_MIN_STREAK/MAX_GAP_MS.

        if (!dcf77Confirmed) return "na"; // noch keine plausible Impulskette / no plausible pulse chain yet
        bool syncFresh = dcfTimeFound && lastDcfSyncTime != 0 &&
                          (time(nullptr) - lastDcfSyncTime) < (time_t)(DCF77_SYNC_STALE_AFTER / 1000);
        if (syncFresh) return "ok";
        bool pulsesFresh = (lastDcf77PulseChangeMillis != 0) &&
                            (millis() - lastDcf77PulseChangeMillis) < DCF77_PULSE_STALE_AFTER;
        if (pulsesFresh) return "syncing";
        return "bad";
    }


    // Baut den Tooltip-/aria-label-Text fuer einen Status-Punkt, gemeinsam
    // genutzt von generateTopBar() und /api/topbarStatus.

    // Builds the tooltip/aria-label text for a status dot, shared by
    // generateTopBar() and /api/topbarStatus.

    String dotStatusText(const String& label, const String& state) {
        String stateText = (state == "ok") ? translate("OK") :
                            (state == "syncing") ? translate("Syncing") :
                            (state == "na") ? translate("Not available") :
                            translate("Error");
        return label + ": " + stateText;
    }

    // Text sicher fuer HTML escapen, auch Anfuehrungszeichen (Werte stehen in value='...'/onclick='...'). In
    // onclick mit eingebettetem JS-String: aeusseres Zeichen als Entity, inneres per Backslash (HTML wird vor
    // JS dekodiert).

    // Escape text safely for HTML, quotes too (values sit in value='...'/onclick='...'). In onclick with an
    // embedded JS string: outer quote as an entity, inner one with a backslash (HTML is decoded before JS).

    String escapeForJsStringInAttr(const String& text, char jsStringQuote) {
        String out;
        out.reserve(text.length());
        char htmlAttrQuote = (jsStringQuote == '\'') ? '"' : '\'';
        for (size_t i = 0; i < text.length(); i++) {
            char c = text[i];
            if (c == '\\') { out += "\\\\"; }
            else if (c == jsStringQuote) { out += '\\'; out += c; }
            else if (c == htmlAttrQuote) { out += (htmlAttrQuote == '"') ? "&quot;" : "&#39;"; }
            else if (c == '<') { out += "&lt;"; }
            else if (c == '>') { out += "&gt;"; }
            else if (c == '&') { out += "&amp;"; }
            else { out += c; }
        }
        return out;
    }


    // Escaped fuer JS-String-Literale DIREKT in <script> (nicht in einem
    // Attribut, siehe escapeForJsStringInAttr). <script>-Inhalt wird nicht
    // HTML-entity-dekodiert, daher Backslash + "<" als "\x3C" escapen.

    // Escapes for JS string literals DIRECTLY inside <script> (not an
    // attribute, see escapeForJsStringInAttr). <script> content isn't HTML-
    // entity-decoded, so escape backslash plus "<" as "\x3C".

    String escapeForJsStringLiteral(const String& text, char jsStringQuote = '"') {
        String out;
        out.reserve(text.length());
        for (size_t i = 0; i < text.length(); i++) {
            char c = text[i];
            if (c == '\\') { out += "\\\\"; }
            else if (c == jsStringQuote) { out += '\\'; out += c; }
            else if (c == '<') { out += "\\x3C"; }
            else if (c == '\n') { out += "\\n"; }
            else if (c == '\r') { out += "\\r"; }
            else { out += c; }
        }
        return out;
    }


    // Liegt die anfragende IP im GLEICHEN Netz wie die Uhr (STA-Subnetz bzw. AP-Subnetz 192.168.4.0/24)? Nur
    // als Rueckfall die RFC1918-Bereiche. Schuetzt Status und Aktionen vor Zugriff von aussen
    // (DMZ/Port-Weiterleitung).

    // Is the requesting IP in the SAME network as the clock (STA subnet or AP subnet 192.168.4.0/24)? RFC1918
    // ranges only as a fallback. Protects status and actions from outside access (DMZ/port forward).

    bool isSameSubnet(IPAddress ip, IPAddress ownIp, IPAddress mask) {
        for (int i = 0; i < 4; i++) {
            if ((ip[i] & mask[i]) != (ownIp[i] & mask[i])) return false;
        }
        return true;
    }

    // Pruefung abgeschaltet: jeder Zugriff gilt als privat, alle Aktionen sind ohne Bestaetigungscode
    // erlaubt. Aufrufstellen unveraendert - zum Wiedereinschalten PRIVATE_NETWORK_CHECK auf true setzen.

    // Check disabled: every access counts as private, all actions are allowed without a confirmation code.
    // Call sites unchanged - to re-enable, set PRIVATE_NETWORK_CHECK to true.

    constexpr bool PRIVATE_NETWORK_CHECK = false;

    bool isPrivateNetworkIp(IPAddress ip) {
        if (!PRIVATE_NETWORK_CHECK) return true;

        wifi_mode_t mode = WiFi.getMode();

        if ((mode == WIFI_STA || mode == WIFI_AP_STA) && WiFi.status() == WL_CONNECTED) {
            IPAddress mask = WiFi.subnetMask();
            if (mask != IPAddress(0, 0, 0, 0) && isSameSubnet(ip, WiFi.localIP(), mask)) {
                return true;
            }
        }

        if (mode == WIFI_AP || mode == WIFI_AP_STA) {
            if (isSameSubnet(ip, WiFi.softAPIP(), IPAddress(255, 255, 255, 0))) {
                return true;
            }
        }

        if (ip[0] == 10) return true; // 10.0.0.0/8
        if (ip[0] == 192 && ip[1] == 168) return true; // 192.168.0.0/16
        if (ip[0] == 172 && ip[1] >= 16 && ip[1] <= 31) return true; // 172.16.0.0/12
        return false;
    }


    String escapeHtmlText(const String& text) {
        String out;
        out.reserve(text.length());
        for (size_t i = 0; i < text.length(); i++) {
            char c = text[i];
            switch (c) {
                case '&':  out += "&amp;";  break;
                case '<':  out += "&lt;";   break;
                case '>':  out += "&gt;";   break;
                case '\'': out += "&#39;";  break;
                case '"':  out += "&quot;"; break;
                default:   out += c;        break;
            }
        }
        return out;
    }


    // Loescht eine Datei samt Folgen: Presets, die auf ein Zifferblatt oder einen Zeigersatz verweisen, die
    // Streifen-Grafik eines Zifferblatts und neu zu ladende Streifen-Daten. false, wenn es die Datei nicht gibt.

    // Deletes a file including its consequences: presets referring to a clock face or hand set, a clock face's
    // strip graphic and strip data to reload. false if the file does not exist.

    bool deleteFileWithSideEffects(const String& path) {
        if (!LittleFS.exists(path) || isProtectedFile(path)) return false;
        LittleFS.remove(path);

        // Falls ein Zifferblatt oder Teil eines Zeigersatzes geloescht
        // wurde, alle Presets entfernen, die darauf verweisen.

        // If a clock face or part of a hand set was deleted, remove all
        // presets that reference it.

        String name = path.substring(1); // fuehrenden Slash entfernen
                                         // remove the leading slash
        if (name.startsWith("face_") && name.endsWith(".bmp")) {
            removeOrphanedPresets(path, "");

            // Streifen-Grafik und -Einstellungen sowie Zifferblatt-Einstellungen gleich mit loeschen
            // Delete the strip graphic and settings as well as the clock face settings along with it

            for (const String& side : { stripPathForFace(path), stripConfigPath(path), faceConfigPath(path) }) {
                if (side.length() && LittleFS.exists(side)) LittleFS.remove(side);
            }
            stripImageFor = "?";
            stripSettingsFor = "?";
            faceSettingsFor = "?";
            infoStripDirty[0] = infoStripDirty[1] = true;
        }
        else if (name.startsWith("strip_")) {
            stripImageFor = "?";
            infoStripDirty[0] = infoStripDirty[1] = true;
        }
        else if (name.startsWith("stripfont_")) {
            stripVlwStale = true; // VLW-Schrift weg - der Streifen faellt auf GLCD zurueck
                                  // VLW font gone - the strip falls back to GLCD
            infoStripDirty[0] = infoStripDirty[1] = true;
        }
        else if (name.startsWith("hand_set") && name.endsWith(".bmp")) {
            int start = 8; // Laenge von "hand_set"
                           // length of "hand_set"
            int end = name.indexOf('_', start);
            if (end > start) {
                String setId = name.substring(start, end);
                removeOrphanedPresets("", setId);

                // Falls der betroffene Zeigersatz gerade aktiv war, sofort auf den Standardsatz zurueckschalten
                // If the affected hand set was currently active, switch back to the default set immediately

                if (handSetFileId(preferences.getString(PK_HANDSET, "")) == setId) {
                    preferences.putString(PK_HANDSET, "default");
                    freeClockFaceBuffer();
                    loadClockFace();
                    loadHandSprites();
                    updateClock();
                }
            }
        }
        return true;
    }


    // Seite, zu der /delete und /rename zurueckspringen: /files und /listfilesFaces haengen ein explizites
    // "from" an. Unbekannt/fehlend -> allgemeiner Dateimanager.

    // Page /delete and /rename return to: /files and /listfilesFaces attach an explicit "from".
    // Unknown/missing -> general file manager.

    String fileManagerReturnTarget(const String& from) {
        if (from == "listfilesFaces") return "/listfilesFaces";
        if (from == "handsets") return "/handsets";
        return "/files";
    }


    // Wie escapeHtmlText(), aber fuer String-Werte in JSON-Antworten - noetig
    // bei Feldern mit Nutzereingaben (Rocrail-Hostname, Vorschau-Fingerabdruck),
    // da ein Anfuehrungszeichen sonst die JSON-Antwort zerbrechen koennte.

    // Like escapeHtmlText(), but for string values in JSON responses -
    // needed for fields with user input (Rocrail hostname, preview
    // fingerprint), since a quote character could otherwise break the JSON.

    String escapeJsonText(const String& text) {
        String out;
        out.reserve(text.length());
        for (size_t i = 0; i < text.length(); i++) {
            char c = text[i];
            switch (c) {
                case '"':  out += "\\\""; break;
                case '\\': out += "\\\\"; break;
                default:   out += c;      break;
            }
        }
        return out;
    }


    // Erzeugt die Statuszeile (Topbar): Geraetename, Hostname/IP, je ein
    // Status-Punkt pro Zeitquelle (Zeit/RTC/DCF77), Helligkeitswert, Uhrzeit,
    // Neu-Laden/Neustart. Kein WLAN-Punkt - ohne WLAN laedt die Seite gar nicht.

    // Generates the status bar (topbar): device name, hostname/IP, one
    // status dot per time source (time/RTC/DCF77), brightness, time,
    // reload/restart. No WiFi dot - the page can't load without WiFi.

    String generateTopBar() {
        String html;
        html.reserve(3600); // Platz fuer Punkte, Tooltips und Live-Status-Skript
                            // Room for dots, tooltips and the live-status script

        html += "<header class='topbar'>";
        html += "<div class='brand'>";
        html += "<span class='brand-mark'>UHR&middot;4</span>";

        bool staConnected = (WiFi.getMode() == WIFI_STA && WiFi.status() == WL_CONNECTED);

        if (staConnected && pingHostname) {
            html += "<h1><a class='host-link' href='http://" + String(hostname) + ".local/'>" + String(hostname) + "</a></h1>";
            html += "<span class='ip-hint'><a href='http://" + WiFi.localIP().toString() + "/'>" + WiFi.localIP().toString() + "</a></span>";
        }
        else if (staConnected) {

            // Hostname noch nicht bestaetigt - SSID als Platzhalter zeigen.
            // Hostname not confirmed yet - show the SSID as a placeholder.

            html += "<h1>" + WiFi.SSID() + "</h1>";
            html += "<span class='ip-hint'><a href='http://" + WiFi.localIP().toString() + "/'>" + WiFi.localIP().toString() + "</a></span>";
        }
        else {

            // AP-/Setup-Modus: kein mDNS-Hostname. AP-Passwort bewusst nicht
            // hier - steht nur auf dem Display, siehe startAP() in wifi_manager.h.

            // AP/setup mode: no mDNS hostname. AP password deliberately not
            // shown here - only on the display, see startAP() in wifi_manager.h.

            html += "<h1>Access Point</h1>";
            html += "<span class='ip-hint'><a href='http://" + WiFi.softAPIP().toString() + "/'>" + WiFi.softAPIP().toString() + "</a></span>";
        }

        // Chip und Displaytyp neben der Adresse (Schreibweise wie in flashESP und der Displayauswahl)
        // Chip and display type next to the address (spelling as in flashESP and the display selection)

        html += "<span class='ip-hint' title='Chip / " + translate("Display type") + "'>" + String(CHIP_SHORT_NAME) + " " + String(displayChoiceName(displayType, useBacklight)) + "</span>";
        html += "</div>";

        html += "<div class='status-strip'>";

        // IDs und title/aria-label an jedem Punkt - das Status-Skript aktualisiert Farbe und Text (auch fuer
        // Screenreader). "Zeit" steht zuletzt neben dem Datum; timeState wird hier schon fuer
        // #topbar-datetime berechnet.

        // IDs and title/aria-label on every dot - the status script updates color and text (for screen
        // readers too). "Time" comes last next to the date; timeState is computed here already for
        // #topbar-datetime.

        String timeState = getTimeStatus();
        bool timeOk = (timeState == "ok"); // fuer die Datumsanzeige weiter unten wiederverwendet / reused for the date display further below
        String timeTitle = dotStatusText(translate("Time"), timeState);

        // Live-Helligkeitswert statt Status-Punkt. Ohne useAdc (Spannungsteiler
        // unbestromt, siehe uhr4.ino) den Eintrag lieber weglassen statt einen
        // eingefrorenen Wert zu zeigen.

        // Live brightness value instead of a status dot. Without useAdc
        // (voltage divider unpowered, see uhr4.ino) omit the entry rather
        // than show a stale value.

        if (photoresistorFound && useAdc) {
            html += "<span class='status' id='status-light'>" + translate("Light") + ": <span id='value-light' class='statval'>" + String(currentLightPercent) + " %</span></span>";
        }

        String rtcState = getRtcStatus();

        // rtcPresent false nur bei RTC_NOT_AVAILABLE - Eintrag bleibt dann
        // per 'hidden' unsichtbar statt eines grauen "na"-Punkts.

        // rtcPresent false only on RTC_NOT_AVAILABLE - the entry then stays
        // invisible via 'hidden' instead of a gray "na" dot.

        bool rtcPresent = (rtcState != "na");
        String rtcTitle = dotStatusText("RTC", rtcState);
        html += "<span class='status' id='status-rtc'" + String(rtcPresent ? "" : " hidden") + "><i id='dot-rtc' role='img' aria-label='" + rtcTitle + "' title='" + rtcTitle + "' class='dot";
        if (rtcState == "ok") html += " ok";
        html += "'></i>RTC</span>";

        String dcfState = getDcf77Status();

        // dcfPresent false bis der erste Impuls beobachtet wurde (dcfState==
        // "na") - Eintrag bleibt per 'hidden' unsichtbar statt grauem Punkt,
        // wird dann per setPresent() live eingeblendet und bleibt sichtbar.

        // dcfPresent false until the first pulse is observed (dcfState==
        // "na") - the entry stays 'hidden' instead of a gray dot, then gets
        // revealed live via setPresent() and stays visible.

        bool dcfPresent = (dcfState != "na");
        String dcfTitle = dotStatusText("DCF77", dcfState);
        html += "<span class='status' id='status-dcf77'" + String(dcfPresent ? "" : " hidden") + "><i id='dot-dcf77' role='img' aria-label='" + dcfTitle + "' title='" + dcfTitle + "' class='dot";
        if (dcfState == "ok") html += " ok";
        else if (dcfState == "syncing") html += " syncing";
        html += "'></i>DCF77</span>";

        // Nur sichtbar, wenn der Rocrail-Master-Schalter (Zifferblatt-Tab)
        // aktiv ist - gruen bei bestehender Verbindung, sonst rot (Basis-
        // ".dot" ohne "ok"-Klasse ist bereits rot, siehe CSS oben).

        // Only visible when the Rocrail master switch (Clock Setup tab) is
        // on - green while connected, red otherwise (the base ".dot"
        // without the "ok" class is already red, see CSS above).

        String rocrailTitle = dotStatusText("Rocrail", rocrailConnected ? "ok" : "error");
        html += "<span class='status' id='status-rocrail'" + String(rocrailEnabled ? "" : " hidden") + "><i id='dot-rocrail' role='img' aria-label='" + rocrailTitle + "' title='" + rocrailTitle + "' class='dot";
        if (rocrailConnected) html += " ok";
        html += "'></i>Rocrail</span>";

        // "Zeit"-Punkt letzter Eintrag, direkt vor #topbar-datetime.
        // "Time" dot is the last entry, right before #topbar-datetime.

        html += "<span class='status' id='status-time'><i id='dot-time' role='img' aria-label='" + timeTitle + "' title='" + timeTitle + "' class='dot";
        if (timeState == "ok") html += " ok";
        else if (timeState == "na") html += " na";
        html += "'></i>" + translate("Time") + "</span>";

        html += "</div>";

        // Immer rendern (auch leer), damit das Live-Status-Skript den Text
        // per Poll aktualisieren kann, ohne die Seite neu zu laden.

        // Always rendered (even empty) so the live-status script can update
        // the text on each poll without reloading the page.

        html += "<div id='topbar-datetime' class='datetime'>";
        if (timeOk) {
            char nowStr[20];
            strftime(nowStr, sizeof(nowStr), "%d.%m.%Y %H:%M", &timeinfo);
            html += String(nowStr);
        }
        html += "</div>";

        // Ohne Uhrzeit (kein WLAN/NTP, keine RTC, kein DCF77): Knopf, der die Uhrzeit dieses Geraets uebernimmt -
        // auch im Access-Point-Modus. Verschwindet, sobald die Uhr eine Zeit hat (Status-Skript unten).

        // Without a time (no WiFi/NTP, no RTC, no DCF77): button that takes over this device's time - also in
        // access point mode. Disappears as soon as the clock has a time (status script below).

        if (isPrivateNetworkIp(webserver.client().remoteIP())) {
            html += "<button type='button' id='topbar-settime' onclick='setClockFromDevice(this)' style='padding:2px 8px;font-size:0.85em;' title='" +
                    translate("Sets the clock to the time of this device") + "'" + String(timeOk ? " hidden" : "") + ">&#128339; " +
                    translate("Use device time") + "</button>";
        }

        // Versteckter Hinweis, siehe ".offline-hint" in generateHtmlHeader().
        // Hidden hint, see ".offline-hint" in generateHtmlHeader().

        html += "<span id='topbar-offline-hint' class='offline-hint'>&#9888; " + translate("Connection lost") + "</span>";

        // Kein Refresh-Knopf/Auto-Refresh - alle Werte aktualisieren sich
        // ohnehin per JS. Neustart bleibt (echter Geraete-Neustart).

        // No refresh button/auto-refresh - all values already update via
        // JS. Restart stays (an actual device restart).

        html += "<button type='button' class='reset-btn' onclick='if(confirm(\"" + translate("Are you sure you want to reboot?") + "\")){location.href=\"/reboot\";}' title='" + translate("Reboot") + "'>&#9211;</button>";

        html += "</header>";

        // Live-Status: pollt /api/topbarStatus alle 5 s ohne Reload, Offline-Hinweis erst nach zwei
        // Fehlschlaegen, Pause im Hintergrund. Meldet ein Poll eine andere Build-Version (pageVersion), laedt
        // die Seite komplett neu.

        // Live status: polls /api/topbarStatus every 5 s without reload, offline hint only after two
        // failures, paused in the background. If a poll reports a different build version (pageVersion), the
        // page reloads completely.

        html += "<script>(function(){";

        // "version" ist ein reiner Build-Zeitstempel ohne Anfuehrungszeichen
        // o.ae. (siehe globals.h) - daher hier ohne Escaping direkt als
        // JS-String-Literal eingebettet, wie auch beim JSON oben.

        // "version" is a plain build timestamp with no quotes etc. (see
        // globals.h) - so it's embedded here directly as a JS string
        // literal without escaping, same as in the JSON above.

        html += "var pageVersion=\"" + String(version) + "\";";
        html += "function setStatusDot(id,state,title){var el=document.getElementById(id);if(!el)return;el.classList.toggle('ok',state==='ok');el.classList.toggle('syncing',state==='syncing');el.classList.toggle('na',state==='na');if(title){el.title=title;el.setAttribute('aria-label',title);}}";

        // setPresent(): blendet einen Eintrag der Statuszeile (RTC, DCF77, Rocrail) live ein oder aus,
        // je nachdem, was der Server meldet.

        // setPresent(): shows or hides a status bar entry (RTC, DCF77, Rocrail) live, depending on what
        // the server reports.

        html += "function setPresent(id,present){var el=document.getElementById(id);if(!el)return;el.hidden=!present;}";

        // setValue(): aktualisiert eine Live-Wertanzeige statt einer Punktfarbe.
        // setValue(): updates a live value reading instead of a dot color.

        html += "function setValue(id,text){var el=document.getElementById(id);if(!el)return;el.textContent=text;}";

        // Bei Verbindungsverlust wuerden Licht/Zeit/Datum/RTC/DCF77 sonst
        // eingefrorene, veraltete Werte zeigen - waehrend des Aussetzers
        // lieber ganz ausblenden statt einen falschen Eindruck von Aktualitaet zu erwecken.

        // On connection loss, Light/Time/Date/RTC/DCF77 would otherwise
        // keep showing frozen, stale values - better to hide them entirely
        // for the outage than give a false impression of freshness.

        html += "function setOnline(ok){var h=document.getElementById('topbar-offline-hint');if(h)h.classList.toggle('show',!ok);";
        html += "['status-light','status-time','topbar-datetime','status-rtc','status-dcf77','status-rocrail'].forEach(function(id){var el=document.getElementById(id);if(el)el.hidden=!ok;});}";
        html += "var failCount=0;";
        html += "function poll(){fetch('/api/topbarStatus').then(function(r){return r.json();}).then(function(s){";
        html += "failCount=0;setOnline(true);";
        html += "if(s.version&&pageVersion&&s.version!==pageVersion){location.reload();return;}";
        html += "setStatusDot('dot-time',s.time,s.timeTitle);";
        html += "setPresent('status-rtc',s.rtcPresent);setStatusDot('dot-rtc',s.rtc,s.rtcTitle);";
        html += "setPresent('status-dcf77',s.dcf77Present);setStatusDot('dot-dcf77',s.dcf77,s.dcf77Title);";
        html += "setPresent('status-rocrail',s.rocrailEnabled);setStatusDot('dot-rocrail',s.rocrailConnected?'ok':'error',s.rocrailTitle);";

        html += "setValue('value-light',s.lightValue);";
        html += "var dt=document.getElementById('topbar-datetime');if(dt)dt.textContent=s.datetime;";
        html += "var st=document.getElementById('topbar-settime');if(st)st.hidden=(s.time!=='na');";
        html += "}).catch(function(){failCount++;if(failCount>=2)setOnline(false);});}";

        // setClockFromDevice(): Uhrzeit dieses Geraets an die Uhr senden (/api/setTime) - Knopf in der
        // Statusleiste und im Tab NTP Zeitzone
        // setClockFromDevice(): send this device's time to the clock (/api/setTime) - button in the status bar
        // and in the NTP timezone tab

        html += "window.setClockFromDevice=function(b){if(b)b.disabled=true;";
        html += "fetch('/api/setTime',{method:'POST',body:new URLSearchParams({t:(Date.now()/1000).toFixed(3)})}).then(function(r){return r.json();})";
        html += ".then(function(j){if(!j.ok)throw 0;alert('" + translate("Time set") + ": '+j.time);poll();})";
        html += ".catch(function(){alert('" + translate("Time could not be set") + "');}).then(function(){if(b)b.disabled=false;});};";
        html += "var pollTimer=null,paused=false;";
        html += "function startPolling(){if(pollTimer)return;poll();pollTimer=setInterval(poll,5000);}";
        html += "function stopPolling(){if(!pollTimer)return;clearInterval(pollTimer);pollTimer=null;}";
        html += "document.addEventListener('visibilitychange',function(){if(document.hidden||paused){stopPolling();}else{startPolling();}});";

        // topbarPolling(false): Pause, solange die Uhr mit einer langen Anfrage beschaeftigt ist (Sichern,
        // Wiederherstellen) - die Abfragen kaemen nicht durch und meldeten "Verbindung verloren".

        // topbarPolling(false): pause while the clock is busy with a long request (backup, restore) - the
        // polls would not get through and report "Connection lost".

        html += "window.topbarPolling=function(on){paused=!on;failCount=0;if(paused)stopPolling();else if(!document.hidden)startPolling();};";
        html += "if(!document.hidden)startPolling();";
        html += "})();</script>";

        return html;
    }


    // Tagesfenster wie in updateBrightness() (display.h): Stunde >= Start und < Ende, also Ende exklusiv -
    // aus den Laufzeitwerten, damit die Anzeige zur tatsaechlich verwendeten Einstellung passt.

    // Day window like in updateBrightness() (display.h): hour >= start and < end, i.e. end exclusive - from
    // the runtime values, so the display matches the setting actually in use.

    String dayWindowText() {
        if (brightStartHour == brightEndHour) return "off (start = end)";
        String text = String(brightStartHour) + ":00 - " + String(brightEndHour) + ":00";
        if (brightStartHour > brightEndHour) text += " (over midnight)";
        return text;
    }

    // Kurze Zeile mit der LittleFS-Belegung, reiner Text - der Aufrufer bettet ihn ein. forceEnglish fuer die
    // immer englische Status-Seite.

    // Short line with LittleFS usage, plain text - the caller embeds it. forceEnglish for the always-English
    // status page.

    String generateStorageInfo(size_t used, size_t total, bool forceEnglish) {
        String usedLabel = forceEnglish ? "Storage used" : translate("Storage used");
        String freeLabel = forceEnglish ? "Free" : translate("Free");
        String html = usedLabel + ": " + String(used / 1024) + " KB / " + String(total / 1024) + " KB";
        html += " (" + freeLabel + ": " + String((total - used) / 1024) + " KB)";
        return html;
    }


    // Einfache Hinweisseite (Erfolg/Fehler/Status) im Dark-Theme.
    // Simple message page (success/error/status) in dark theme.

    String simpleMessagePage(String heading, String bodyHtml, String extraHead) {
        String html = generateHtmlHeader(extraHead);
        html += "<div class='card' style='max-width:480px;'>";
        html += "<h2>" + heading + "</h2>";
        html += bodyHtml;
        html += "</div></body></html>";
        return html;
    }


    // Navigationsleiste generieren
    // Generate the navigation bar

    String generateNavigation() {
     /*   if (WiFi.getMode() != WIFI_STA) {
            DEBUG_PRINTLN("[HTML] Skipping HTML navigation");
            return "";
        }
        */
        String nav;
        nav.reserve(2048);

        nav += "<style>";
        nav += "a { text-decoration: underline; font-weight: bold; }";
        nav += "a:hover { text-decoration: underline; }";
        nav += ".navToggle { display: none; cursor: pointer; font-size: 1.8em; user-select: none; }";

        nav += "@media (max-width: 600px) {";
        nav += "  .navToggle { display: inline-block; }";
        nav += "  .navLinks { display: none; }";
        nav += "  .navLinks.navOpen { display: block; }";
        nav += "  .navLinks a, .navLinks span { display: block; margin: 8px 0 !important; }";
        nav += "}";
        nav += "</style>";
        nav += "<div style='text-align:center; margin-bottom:20px;'>";
        nav += "<span class='navToggle' onclick=\"document.querySelectorAll('.navLinks').forEach(function(e){e.classList.toggle('navOpen');})\">&#9776;</span>";
        nav += "<div class='navLinks'>";

        const struct NavItem {
            String path;
            String label;
            String confirmMessage; // Optional: Bestätigungsnachricht
                                   // optional: confirmation message
        } navItems[] = {

            // WLAN/Zeit/Helligkeit/Status sind Tabs auf "/" und fehlen daher hier - die Routen bleiben fuer
            // Lesezeichen.

            // WiFi/time/brightness/status are tabs on "/" and therefore missing here - the routes stay for
            // bookmarks.

            {"/", translate("Main"), ""},
            {"/preview", translate("Preview"), ""},
            {"/presets", translate("Presets"), ""},
            {"/listfilesFaces", translate("Clock&nbsp;Face"), ""},
            {"/handsets", translate("Hand&nbsp;Set"), ""},
            {"/files", translate("File&nbsp;Manager"), ""},

            // "/reboot" fehlt bewusst (reset-btn in der Topbar), die Route bleibt fuer Lesezeichen. "DCF77"
            // bewusst unuebersetzt (Protokollname, wie in generateTopBar()).

            // "/reboot" deliberately missing (reset-btn in the topbar), the route stays for bookmarks.
            // "DCF77" deliberately untranslated (a protocol name, as in generateTopBar()).

            {"/dcf77", "DCF77", ""},
            {"/backup", translate("Backup"), ""},
            {"/factoryReset", translate("Factory&nbsp;Reset"), ""}
        };

        String currentPath = webserver.uri(); // Aktueller Pfad der Seite
                                              // current path of the page

        for (const auto& item : navItems) {

            if (item.path == currentPath) {

                // Wenn der aktuelle Pfad mit dem Navigationseintrag übereinstimmt, nur Text anzeigen
                // If the current path matches the nav entry, show plain text only

                nav += "<span style=\"margin-right:15px; font-weight:bold;\">" + item.label + "</span> ";
            }
            else {

                // Andernfalls als Link anzeigen
                // Otherwise show as a link

                nav += "<a href=\"" + item.path + "\" style=\"margin-right:15px;\"";
                if (!item.confirmMessage.isEmpty()) {
                    nav += " onclick=\"return confirm('" + item.confirmMessage + "')\"";
                }
                nav += ">" + item.label + "</a> ";
            }

            // Zeilenumbruch zur thematischen Trennung, bewusst im Code statt in der Uebersetzung
            // Line break for thematic separation, deliberately in code rather than the translation

            if (item.path == "/status") {
                nav += "<br>";
            }
        }

        nav += "</div>"; // Ende .navLinks
                         // end .navLinks
        nav += "</div>";
           
        return nav;
    }


    // Baut einen Fingerabdruck aus allen fuer /preview sichtbaren
    // Einstellungen (Zifferblatt, Zeigersatz, Nabe, Sekundenzeiger). Nicht
    // clockAssetGeneration verwendet - die zaehlt auch bei Helligkeits-Rampenschritten hoch.

    // Builds a fingerprint from every setting visible in /preview (face,
    // hand set, hub, second hand). Not using clockAssetGeneration - that
    // also increments on brightness ramp steps.

    String currentPreviewSignature() {
        String sig = preferences.getString(PK_BACKGROUND, "/face_default.bmp");
        sig += "|" + preferences.getString(PK_HANDSET, "");
        sig += "|" + String(hubColor);
        sig += "|" + String(hubSize);
        sig += "|" + String(preferences.getBool(PK_SHOW_SECOND_HAND, true) ? 1 : 0);
        return sig;
    }


    // Baut die Tab-Leiste der Einstellungen als <label>-Elemente der CSS-
    // Tab-Mechanik (siehe generateHtmlHeader()).

    // Builds the settings tab bar as <label> elements of the CSS tab
    // mechanism (see generateHtmlHeader()).

    String generateSettingsTabNav() {
        String nav = "<div class='tabnav'>";
        for (size_t i = 0; i < SETTINGS_TAB_COUNT; i++) {
            String key = String(SETTINGS_TAB_KEYS[i]);

            // Rocrail-Tab nur anzeigen, wenn der Master-Schalter aktiv ist -
            // kein Live-Nachladen noetig, da das Umlegen des Schalters
            // ohnehin einen vollen Seitenneuaufbau ausloest.

            // Only show the Rocrail tab when the master switch is on - no
            // live reload needed since flipping the switch already
            // triggers a full page reload anyway.

            if (key == "rocrail" && !rocrailEnabled) continue;

            String label = translate(SETTINGS_TAB_LABELS[i]);
            nav += "<label for='tab-" + key + "'>" + label + "</label>";
        }

        nav += "</div>";
        return nav;
    }


    // Setzt den Pin der Hintergrundbeleuchtung in einen uebersetzten Text ein ("{pin}", je Board verschieden)
    // Inserts the backlight pin into a translated text ("{pin}", different per board)

    String withBacklightPin(String text) {
        text.replace("{pin}", String(TFT_Backlight));
        return text;
    }

    // ⓘ-Hinweis mit Erklaerung als Tooltip (title) - der Punkt am Satzende kommt hier dazu
    // ⓘ note with an explanation as tooltip (title) - the full stop at the end is added here

    String infoTip(const String& text) {
        return "<span title='" + text + ".' style='cursor:help;'>&#9432;</span>";
    }


    // Checkbox-Zeile der Einstellungen: Haken, Beschriftung und ⓘ-Hinweis; id optional (z.B. fuer Skripte)
    // Settings checkbox row: tick, label and ⓘ note; id optional (e.g. for scripts)

    String checkboxRow(const char* name, bool checked, const String& label, const String& tip, const char* id) {
        String html = "<div style='display:flex;align-items:center;gap:6px;white-space:nowrap;'><input type='checkbox' name='";
        html += name;
        html += "'";
        if (*id) {
            html += " id='";
            html += id;
            html += "'";
        }
        html += " value='1' ";
        html += checked ? "checked" : "";
        html += " style='width:auto;margin:0;'>" + label + " " + infoTip(tip) + "</div><br>";
        return html;
    }


    // Zeigt nach einer Weiterleitung eine einheitliche Meldung (translate()-Schluessel): "msg" Erfolg, blendet
    // sich nach 4 s aus - "warn" Hinweis und "err" Fehler bleiben stehen.

    // Shows a uniform message after a redirect (translate() key): "msg" success, fades out after 4 s - "warn"
    // note and "err" error stay.

    String generateFlashMessage() {
        String kind = webserver.hasArg("err") ? "err" : (webserver.hasArg("warn") ? "warn" : "ok");
        String param = (kind == "ok") ? "msg" : kind;
        if (!webserver.hasArg(param)) return "";
        String rawMsg = webserver.arg(param);
        String message = translate(rawMsg);

        // escapeHtmlText() nur anwenden, wenn KEINE Uebersetzung stattfand -
        // "msg" kommt aus der URL, sonst ein XSS-Einfallstor. Eine echte
        // Uebersetzung enthaelt bewusst HTML-Entities, die sonst kaputt-escaped wuerden.

        // Apply escapeHtmlText() only when NO translation happened - "msg"
        // comes from the URL, otherwise an XSS entry point. A genuine
        // translation deliberately contains HTML entities, which would otherwise get escaped and broken.

        if (message == rawMsg) {
            message = escapeHtmlText(message);
        }

        // Der WPS-Banner bleibt sichtbar, solange WPS tatsaechlich aktiv ist
        // (bis 2 Min., per /api/wpsStatus-Polling statt fester Zeit) -
        // Notabschaltung nach 3 Min., falls das Polling selbst nicht mehr durchkommt.

        // The WPS banner stays visible as long as WPS is actually active (up
        // to 2 min, via /api/wpsStatus polling instead of a fixed time) -
        // 3-minute safety cutoff in case polling itself can't get through.

        bool isWpsBanner = (rawMsg == "WPS active - press the WPS button on your router now. Connection to the clock may be lost for about 2 minutes while this happens");

        String html = "<div id='flashMsg' class='msg " + kind + "'>" + message + "</div>";
        if (isWpsBanner) {

            // Waehrend WPS laeuft, ist die Uhr kurz nicht erreichbar - jeder
            // fetch() schlaegt erwartungsgemaess fehl und wird per catch()
            // wiederholt. AbortController begrenzt jeden Versuch auf 3s, damit ein haengender fetch() die Wiederholung nicht blockiert.

            // While WPS runs, the clock is briefly unreachable - every
            // fetch() is expected to fail and gets retried via catch().
            // AbortController caps each attempt at 3s, so a hanging fetch() doesn't block the retry.

            html += "<script>(function(){var e=document.getElementById('flashMsg');var startedAt=Date.now();function poll(){if(!e)return;if(Date.now()-startedAt>180000){e.style.display='none';return;}var ctrl=(typeof AbortController!=='undefined')?new AbortController():null;var timer=ctrl?setTimeout(function(){ctrl.abort();},3000):null;fetch('/api/wpsStatus',ctrl?{signal:ctrl.signal}:{}).then(function(r){if(timer)clearTimeout(timer);return r.json();}).then(function(d){if(!d.pending){e.style.display='none';}else{setTimeout(poll,1000);}}).catch(function(){if(timer)clearTimeout(timer);setTimeout(poll,1000);});}poll();})();</script>";
        }
        else if (kind == "ok") {
            html += "<script>setTimeout(function(){var e=document.getElementById('flashMsg'); if(e) e.style.display='none';}, 4000);</script>";
        }
        return html;
    }


    // Auswahl eines Zifferblatts oder Zeigersatzes ohne die Seite neu zu laden: pickItem() ruft den Link per fetch() mit
    // &ajax=1 auf, setzt den Hinweis "(aktiv)" im angeklickten Feld (Klasse cls) um und zeigt die Meldung. Schlaegt
    // der Aufruf fehl, folgt der Browser dem Link wie bisher.

    // Selecting a clock face or hand set without reloading the page: pickItem() calls the link via fetch() with
    // &ajax=1, moves the "(active)" note to the clicked item (class cls) and shows the message. If the call
    // fails, the browser follows the link as before.

    String selectWithoutReloadScript(const String& message, const String& activeText) {
        String html = "<div id='selMsg' class='msg ok' style='display:none' data-act='" + activeText + "'>" + message + "</div>";
        html += "<script>function pickItem(a,cls){fetch(a.href+'&ajax=1').then(function(r){if(!r.ok)throw 0;"
                "var m=document.getElementById('selMsg');"
                "document.querySelectorAll('.'+cls).forEach(function(e){e.textContent='';});"
                "a.parentNode.querySelector('.'+cls).textContent=' ('+m.dataset.act+')';"
                "m.style.display='block';clearTimeout(window.selT);window.selT=setTimeout(function(){m.style.display='none';},4000);"
                "}).catch(function(){location.href=a.href;});return false;}</script>";
        return html;
    }


    // Fortschrittsbalken beim Loeschen eines Zifferblatts/Zeigersatzes: showBusy() blendet oben einen Balken ein, bevor
    // der Browser dem Loeschen-Link folgt - er bleibt, bis die Seite nach dem Loeschen neu geladen ist. Die Uhr meldet
    // keinen Teilfortschritt, der Balken laeuft daher unbestimmt.

    // Progress bar while deleting a clock face/hand set: showBusy() shows a bar at the top before the browser follows
    // the delete link - it stays until the page is reloaded after the deletion. The clock reports no partial
    // progress, so the bar is indeterminate.

    String deleteProgressScript() {
        String html = "<div id='busyBar' style='display:none;position:fixed;left:0;right:0;top:0;padding:12px 16px;background:var(--panel);border-bottom:1px solid var(--panel-border);z-index:20;'>"
                      "<progress style='width:100%;'></progress><br><small>" + translate("Deleting - please wait") + "</small></div>";
        html += "<script>function showBusy(){document.getElementById('busyBar').style.display='block';}</script>";
        return html;
    }


    // Sprachselector generieren
    // Generate the language selector

    String generateLanguageSelector() {
        String html = "<form method='POST' action='/setLanguage'>";
        html.reserve(512);  // Sprachauswahl: klein
                            // language selector: small
        html += "<label for='lang'>Language/Sprache:</label>";
        html += "<select name='lang' onchange='this.form.submit()'>";
        html += "<option value='en'" + String(currentLanguage == "en" ? " selected" : "") + ">English / Englisch</option>";
        html += "<option value='de'" + String(currentLanguage == "de" ? " selected" : "") + ">German / Deutsch</option>";
        html += "</select>";
        html += "<noscript><button type='submit'>Save / Speichern</button></noscript>";
        html += "</form><hr>";
        return html;
    }


    // Vergleicht zwei Dateinamen "natuerlich": Ziffernfolgen werden als Zahl
    // verglichen statt zeichenweise, damit z.B. "hand_set2..." vor "hand_set10..." einsortiert wird.

    // Compares two filenames "naturally": digit sequences are compared as
    // numbers instead of character by character, so e.g. "hand_set2..." sorts before "hand_set10..."

    bool naturalLess(const String& a, const String& b) {
        unsigned int i = 0, j = 0;
        while (i < a.length() && j < b.length()) {
            char ca = a[i], cb = b[j];
            if (isDigit(ca) && isDigit(cb)) {
                unsigned int si = i, sj = j;
                while (i < a.length() && isDigit(a[i])) i++;
                while (j < b.length() && isDigit(b[j])) j++;
                String numA = a.substring(si, i);
                String numB = b.substring(sj, j);
                long valA = numA.toInt();
                long valB = numB.toInt();
                if (valA != valB) return valA < valB;
                if (numA != numB) return numA < numB; // z.B. fuehrende Nullen als Tiebreaker
                                                      // e.g. leading zeros as a tiebreaker
                continue;
            }
            if (ca != cb) {
                char lca = tolower(ca);
                char lcb = tolower(cb);
                if (lca != lcb) return lca < lcb;
                return ca < cb; // bei gleichem Buchstaben unterschiedlicher Groesse: Grossbuchstabe zuerst (stabiler Tiebreaker)
                                // for the same letter in different case: uppercase first (stable tiebreaker)
            }
            i++; j++;
        }
        return (a.length() - i) < (b.length() - j);
    }


    // Sortiert eine Liste von Dateinamen "natuerlich" (siehe naturalLess()) - Insertion-Sort
    // statt std::sort, um keine <algorithm>-Abhaengigkeit zu benoetigen (Dateianzahl ueberschaubar).

    // Sorts a list of filenames "naturally" (see naturalLess()) - insertion sort
    // instead of std::sort, to avoid an <algorithm> dependency (file counts are small).

    void naturalSortNames(std::vector<String>& names) {
        for (size_t i = 1; i < names.size(); i++) {
            String key = names[i];
            long j = (long)i - 1;
            while (j >= 0 && naturalLess(key, names[j])) {
                names[j + 1] = names[j];
                j--;
            }
            names[j + 1] = key;
        }
    }


    // Bereinigt eine Eingabe zu einem gueltigen Hostnamen (RFC 952/1123): nur
    // Buchstaben/Ziffern/Bindestriche, kein Bindestrich am Rand, max. 30 Zeichen.

    // Sanitizes input into a valid hostname (RFC 952/1123): only
    // letters/digits/hyphens, no hyphen at the edges, max. 30 characters.

    String sanitizeHostname(String input) {
        input.trim();
        String result;
        for (unsigned int i = 0; i < input.length(); i++) {
            char c = input[i];
            if (isAlphaNumeric(c) || c == '-') {
                result += c;
            }
            else if (c == ' ' || c == '_') {
                result += '-';
            }

            // alle anderen Zeichen werden stillschweigend entfernt
            // all other characters are silently removed

        }
        while (result.startsWith("-")) result = result.substring(1);
        while (result.endsWith("-")) result = result.substring(0, result.length() - 1);
        if (result.length() > 30) result = result.substring(0, 30);
        while (result.endsWith("-")) result = result.substring(0, result.length() - 1);
        return result;
    }


    // Sendet eine 302-Weiterleitung an location - buendelt das sonst ueberall
    // wiederholte sendHeader("Location", ...)/send(302, ...)-Paar.

    // Sends a 302 redirect to location - bundles the sendHeader("Location", ...)/
    // send(302, ...) pair that would otherwise be repeated everywhere.

    void redirectTo(const String& location, const String& body) {

        // Im AP-Modus zaehlt jede Formular-Aktion als Nutzung und verlaengert die Frist bis zum
        // 15-Minuten-Neustart - er soll keine laufende Einrichtung unterbrechen.

        // In AP mode every form action counts as use and extends the deadline of the 15-minute restart - it
        // should not interrupt an ongoing setup.

        if (softAPIP) softAPIPstart = millis();

        // Zugriffs-IP mitloggen fuer Formular-Aktionen (beginPage() deckt Seitenaufrufe ab) - bewusst nicht
        // fuer die Hintergrund-Polls der APIs, die das Log nur fuellen wuerden.

        // Log the accessing IP for form actions (beginPage() covers page views) - deliberately not for the
        // APIs' background polls, which would only fill the log.

        DEBUG_PRINTLN("[WEB] " + webserver.client().remoteIP().toString() + " -> " + webserver.uri());

        webserver.sendHeader("Location", location, true);
        webserver.send(302, "text/plain", body);
    }


    // Erzeugt den fuer fast jede Seite gleichen Seitenanfang (Header inkl. Topbar + Navigation).
    // Generates the page start common to almost every page (header incl. topbar + navigation).

    String beginPage() {

        // Gleicher Grund wie in redirectTo() - deckt normale Seitenaufrufe ab
        // (GET), redirectTo() deckt Formular-Aktionen (POST->redirect) ab.

        // Same reason as in redirectTo() - covers normal page views (GET),
        // redirectTo() covers form actions (POST->redirect).

        if (softAPIP) softAPIPstart = millis();

        // Zugriffs-IP mitloggen - siehe ausfuehrlichen Kommentar in redirectTo().
        // Log the accessing IP too - see the detailed comment in redirectTo().

        DEBUG_PRINTLN("[WEB] " + webserver.client().remoteIP().toString() + " -> " + webserver.uri());

        String html = generateHtmlHeader();
        html += generateNavigation();
        return html;
    }


    // Liest fuer jeden konfigurierten WLAN-Slot einen evtl. mitgesendeten NTP-Server-
    // Parameter aus der Anfrage und speichert ihn (nur bei Aenderung) in ntpServers[]/
    // Preferences - gemeinsame Logik von /api/setMode und /set_timezone.

    // Reads a possibly submitted NTP server parameter for each configured WiFi
    // slot from the request and stores it (only on change) in ntpServers[]/
    // preferences - shared logic of /api/setMode and /set_timezone.

    void updateNtpServersFromRequest() {
        for (int i = 0; i < MAX_WLAN; i++) {
            String argName = pkNtpServer(i);
            if (webserver.hasArg(argName)) {
                strncpy(ntpServers[i], webserver.arg(argName).c_str(), sizeof(ntpServers[i]) - 1);
                ntpServers[i][sizeof(ntpServers[i]) - 1] = '\0'; // Null-terminieren
                                                                 // null-terminate
                if (preferences.getString(argName.c_str(), "") != String(ntpServers[i])) {
                    preferences.putString(argName.c_str(), ntpServers[i]);
                }
            }
        }
    }


    // Uebernimmt eine komplette WLAN-Liste (SSID + Passwort je Slot) in Preferences und
    // wifiSsid[]/wifiPass[]. Leeres Passwort = unveraendert, leere SSID = geloescht. Gemeinsam fuer /save und
    // die bestaetigte Aktion "wlanOverwriteActive".

    // Applies a complete WiFi list (SSID + password per slot) to Preferences and wifiSsid[]/wifiPass[]. Empty
    // password = unchanged, empty SSID = deleted. Shared by /save and the confirmed action
    // "wlanOverwriteActive".

    void applyWlanList(String newSsid[MAX_WLAN], String newPass[MAX_WLAN]) {

        // Effektiver SSID/Passwort-Wert je Slot, zunaechst nur im RAM (leeres
        // Passwortfeld behaelt das gespeicherte). Preferences erst unten, nach
        // dem Kompaktieren, in EINEM Durchlauf beschreiben.

        // Effective SSID/password per slot, computed in RAM first (empty
        // password field keeps the stored one). Preferences are written only
        // below, after compaction, in a SINGLE pass.

        String effectiveSsid[MAX_WLAN];
        String effectivePass[MAX_WLAN];

        for (int i = 0; i < MAX_WLAN; i++) {
            effectiveSsid[i] = newSsid[i];
            if (newPass[i] != "") {
                effectivePass[i] = newPass[i];
            } else {
                effectivePass[i] = loadWifiPass(i);
            }
        }

        // leere Einträge aussortieren
        // Filter out empty entries

        String tempSsid[MAX_WLAN];
        String tempPass[MAX_WLAN];

        int j = 0;
        for (int i = 0; i < MAX_WLAN; i++) {
            if (trim(effectiveSsid[i]).length() > 0) {
                tempSsid[j] = effectiveSsid[i];
                tempPass[j] = effectivePass[i];
                j++;
            }
        }

        // Einziger Schreibdurchlauf: erst hier, mit dem kompaktierten
        // Endergebnis, in Preferences uebernehmen - Lesen-vor-Schreiben spart
        // unveraenderten Slots einen Flash-Schreibvorgang (putStringVerified()).

        // Single write pass: only now, with the already-compacted final
        // result, commit to preferences - read-before-write saves an
        // unchanged slot a flash write (see putStringVerified()).

        for (int i = 0; i < MAX_WLAN; i++) {
            String ssidKey = pkSsid(i);

            if (preferences.getString(ssidKey.c_str(), "") != tempSsid[i]) {
                putStringVerified(ssidKey.c_str(), tempSsid[i]);
            }
            if (loadWifiPass(i) != tempPass[i]) {
                storeWifiPassVerified(i, tempPass[i]);
            }

            wifiSsid[i] = tempSsid[i];
            wifiPass[i] = tempPass[i];
        }
    }


    // Fuehrt eine der acht bestaetigten bzw. direkt erlaubten Aktionen aus - aus /factoryReset/confirm
    // ausgelagert, damit Anfragen aus dem privaten Netz sie ohne Code aufrufen koennen. Die Nutzlast setzt
    // der Aufrufer vorher.

    // Executes one of the eight confirmed or directly allowed actions - factored out of /factoryReset/confirm
    // so requests from the private network can call it without a code. The caller sets the payload
    // beforehand.

    void executePendingAction(String action) {

        // Einen noch anhaengigen fremden Bestaetigungscode verwerfen - sonst zeigte das Display weiter den
        // Code statt der Uhrzeit, obwohl bereits eine andere Aktion ausgefuehrt wurde (ueber
        // /factoryReset/confirm ohnehin leer).

        // Discard a still-pending unrelated confirmation code - otherwise the display would keep showing the
        // code instead of the time, although a different action has already been executed (already empty via
        // /factoryReset/confirm).

        factoryResetCode = "";
        factoryResetPendingAction = "";
        factoryResetCodeAttempts = 0;

        if (action == "all") {
            factoryReset();
        }
        else if (action == "wifi") {
            eraseWiFiConfig();
            delay(WAIT_1s);
            espReboot();
        }
        else if (action == "faces") {
            resetFacesToDefault();
            addStarterPresets(); // der Reset raeumt sie als verwaist mit ab / the reset removes them as orphaned
            redirectTo("/factoryReset?msg=Clock%20faces%20deleted");
        }
        else if (action == "hands") {
            resetHandsToDefault();
            addStarterPresets();
            redirectTo("/factoryReset?msg=Hand%20sets%20deleted");
        }
        else if (action == "presets") {
            resetAllPresets();
            addStarterPresets();
            redirectTo("/factoryReset?msg=Presets%20deleted");
        }
        else if (action == "wlanDeleteActive") {

            // Slot loeschen und die Liste kompaktieren (wie in /deletewifi, ueber applyWlanList()), danach
            // neu starten - es waren die Zugangsdaten der laufenden Verbindung.

            // Delete the slot and compact the list (as in /deletewifi, via applyWlanList()), then reboot -
            // these were the credentials of the running connection.

            int idx = pendingWifiChangeIndex;
            pendingWifiChangeIndex = -1;

            if (idx >= 0 && idx < MAX_WLAN) {
                String newSsid[MAX_WLAN];
                String newPass[MAX_WLAN];
                for (int i = 0; i < MAX_WLAN; i++) {
                    newSsid[i] = preferences.getString(pkSsid(i).c_str(), "");
                    newPass[i] = loadWifiPass(i);
                }
                newSsid[idx] = "";
                newPass[idx] = "";
                applyWlanList(newSsid, newPass);

                // PK_LAST_WLAN komplett entfernen statt auf einen Index zu
                // setzen - nach dem Kompaktieren durch applyWlanList() koennte
                // der Index sonst ein anderes, verschobenes Netzwerk bezeichnen.

                // Remove PK_LAST_WLAN entirely rather than leave it pointing
                // at an index - after applyWlanList()'s compaction that index
                // could now denote a different, shifted network.

                preferences.remove(PK_LAST_WLAN);

                delay(WAIT_1s);
                espReboot();
            }
            else {
                DEBUG_PRINTLN("[SECURITY] wlanDeleteActive but no pending slot - nothing to do (from " + webserver.client().remoteIP().toString() + ")");
                redirectTo("/?tab=wlan&err=Nothing%20to%20delete");
            }
        }
        else if (action == "wlanOverwriteActive") {

            // Die im Formular gesendete WLAN-Liste uebernehmen (applyWlanList(), wie in /save),
            // pendingWifiSsid[]/Pass[] danach loeschen (kein Klartext-Passwort im RAM) und neu starten - es
            // war die laufende Verbindung.

            // Apply the WiFi list sent by the form (applyWlanList(), as in /save), clear
            // pendingWifiSsid[]/Pass[] afterwards (no plain-text password in RAM) and reboot - it was the
            // running connection.

            String newSsid[MAX_WLAN];
            String newPass[MAX_WLAN];
            for (int i = 0; i < MAX_WLAN; i++) {
                newSsid[i] = pendingWifiSsid[i];
                newPass[i] = pendingWifiPass[i];
                pendingWifiSsid[i] = "";
                pendingWifiPass[i] = "";
            }
            applyWlanList(newSsid, newPass);

            delay(WAIT_1s);
            espReboot();
        }
        else if (action == "wlanSwitchActive") {

            // Auf den gemerkten Slot wechseln, sofern er noch existiert (pendingWifiChangeIndex, wie bei
            // "wlanDeleteActive").

            // Switch to the remembered slot if it still exists (pendingWifiChangeIndex, as with
            // "wlanDeleteActive").

            int idx = pendingWifiChangeIndex;
            pendingWifiChangeIndex = -1;

            if (idx >= 0 && idx < MAX_WLAN && preferences.getString(pkSsid(idx).c_str(), "") != "") {
                DEBUG_PRINTLN("[WiFi] Switching to saved network: " + preferences.getString(pkSsid(idx).c_str(), "") + " (from " + webserver.client().remoteIP().toString() + ")");
                preferences.putInt(PK_LAST_WLAN, idx);
                delay(WAIT_1s);
                espReboot();
            }
            else {
                DEBUG_PRINTLN("[SECURITY] wlanSwitchActive but slot no longer valid - nothing to do (from " + webserver.client().remoteIP().toString() + ")");
                redirectTo("/?tab=wlan&err=Network%20no%20longer%20available");
            }
        }
    }


    // Wandelt esp_reset_reason() in lesbaren Text um, fuer die Status-Anzeige.
    // Converts esp_reset_reason() into readable text, for the status display.

    String resetReasonToString(esp_reset_reason_t reason) {
        switch (reason) {
            case ESP_RST_POWERON: return "Power-on";
            case ESP_RST_EXT: return "External pin";
            case ESP_RST_SW: return "Software (esp_restart)";
            case ESP_RST_PANIC: return "Panic / exception";
            case ESP_RST_INT_WDT: return "Interrupt watchdog";
            case ESP_RST_TASK_WDT: return "Task watchdog";
            case ESP_RST_WDT: return "Other watchdog";
            case ESP_RST_DEEPSLEEP: return "Deep sleep wake";
            case ESP_RST_BROWNOUT: return "Brownout";
            case ESP_RST_SDIO: return "SDIO";
            case ESP_RST_USB: return "USB";
            case ESP_RST_JTAG: return "JTAG";
            case ESP_RST_EFUSE: return "Efuse error";
            case ESP_RST_PWR_GLITCH: return "Power glitch";
            case ESP_RST_CPU_LOCKUP: return "CPU lockup";
            default: return "Unknown";
        }
    }


    // Wandelt rtcOk (siehe globals.h) in lesbaren Text um.
    // Converts rtcOk (see globals.h) into readable text.

    String rtcStatusToString(int status) {
        if (status == RTC_AVAILABLE) return "OK";
        if (status == RTC_AVAILABLE_BUT_INVALID) return "found, but time invalid";
        return "not found";
    }


    // Formatiert eine Millis-Zeitspanne wie bei Uptime (Xd Xh Xm Xs) -
    // gemeinsam genutzt fuer "letzter NTP-Sync vor ...".

    // Formats a millis duration the same way as Uptime (Xd Xh Xm Xs) -
    // shared for "last NTP sync ... ago".

    String formatDurationMs(unsigned long ms) {
        unsigned long seconds = ms / 1000;
        unsigned long days = seconds / 86400;
        unsigned long hours = (seconds % 86400) / 3600;
        unsigned long minutes = (seconds % 3600) / 60;
        unsigned long secs = seconds % 60;
        return String(days) + "d " + String(hours) + "h " + String(minutes) + "m " + String(secs) + "s";
    }


    // Baut den gemeinsamen inneren Teil des Helligkeits-Formulars - umschliessendes <form>/<div> und
    // Save-Button bleiben bei den Aufrufern.

    // Builds the shared inner part of the brightness form - the surrounding <form>/<div> and the save button
    // stay with the callers.

    String brightnessFormFieldsHtml() {
        String html = "";

        // Haken fuer die Hintergrundbeleuchtung nur bei regelbarer Beleuchtung (GC9D01 oder GC9A01 mit BL);
        // das versteckte Feld zeigt /save_brightness, dass er im Formular war. Alle Haken in einer Tabelle,
        // buendig untereinander.

        // Backlight checkbox only with a controllable backlight (GC9D01 or GC9A01 with BL); the hidden field
        // tells /save_brightness it was in the form. All checkboxes in one table, lined up below each other.

        bool showBacklight = displayType == DISPLAY_TYPE_GC9D01 || displayType == DISPLAY_TYPE_ST7789 ||
                             displayType == DISPLAY_TYPE_ST7789_240 || useBacklight;
        if (showBacklight || photoresistorFound) {
            html += "<table style='margin:auto;text-align:left;'>";
            if (showBacklight) {
                html += "<tr><td colspan='2'><input type='hidden' name='useBacklightField' value='1'><label><input type='checkbox' name='useBacklight' value='1' " + String(useBacklight ? "checked" : "") + "> " + withBacklightPin(translate("Backlight control (pin {pin})")) + "</label> " + infoTip(withBacklightPin(translate("Dims the display via the backlight PWM on pin {pin} instead of darkening the pixels - only if the backlight is wired to pin {pin} (always on GC9D01). Switching resets min. brightness and thresholds to the matching defaults"))) + "</td></tr>";
            }
            if (photoresistorFound) {
                html += "<tr><td><label><input type='checkbox' name='use_adc' value='1' " + String(useAdc ? "checked" : "") + "> " + translate("Enable Auto Brightness") + "</label> " + infoTip(translate("Automatically adjusts brightness based on ambient light measured by the photoresistor")) + "</td>";
                html += "<td><label><input type='checkbox' name='adcInverted' value='1' " + String(adcInverted ? "checked" : "") + "> " + translate("Invert ADC Reading") + "</label> " + infoTip(translate("Reverses the brightness sensor reading - use if the display gets darker in bright light instead of brighter")) + "</td></tr>";
            }
            html += "</table><hr><br>";
        }

        html += "<div style='display:flex;align-items:center;gap:6px;white-space:nowrap;'><label style='width:280px;display:inline-block;white-space:normal;'>" + translate("Full brightness from (hour, 0-23)") + ":</label><input name = 'brightStart' type = 'number' min = '0' max = '23' value = '" + String(brightStartHour) + "' style='width:70px;'> " + infoTip(translate("Start of the daily time window during which the display always uses full brightness, regardless of ambient light")) + "</div>";
        html += "<div style='display:flex;align-items:center;gap:6px;white-space:nowrap;'><label style='width:280px;display:inline-block;white-space:normal;'>" + translate("Full brightness until (hour, 0-23)") + ":</label><input name = 'brightEnd' type = 'number' min = '0' max = '23' value = '" + String(brightEndHour) + "' style='width:70px;'> " + infoTip(translate("End of the daily time window during which the display always uses full brightness, regardless of ambient light")) + "</div><br>";

        html += "<div style='display:flex;align-items:center;gap:6px;white-space:nowrap;'><label style='width:280px;display:inline-block;white-space:normal;'>" + translate("Min Brightness") + " (0 - 255) : </label><input name = 'minBrightness' type = 'number' min = '0' max = '255' value = '" + String(minBrightness) + "' style='width:70px;'> " + infoTip(translate("Display brightness used at or below the low threshold")) + "</div>";
        html += "<div style='display:flex;align-items:center;gap:6px;white-space:nowrap;'><label style='width:280px;display:inline-block;white-space:normal;'>" + translate("Max Brightness") + " (0 - 255) : </label><input name = 'maxBrightness' type = 'number' min = '0' max = '255' value = '" + String(maxBrightness) + "' style='width:70px;'" +
                (BOARD_WAVESHARE_C6_ST7789 ? String(" oninput=\"document.getElementById('maxBrightWarn').style.display=this.value>" + String(BACKLIGHT_C6_MAX_SAFE) + "?'':'none'\"") : String("")) +
                "> " + infoTip(translate("Display brightness used at or above the high threshold")) + "</div>";

        // ESP32-C6: Warnung ueber BACKLIGHT_C6_MAX_SAFE (Hinweis von Waveshare zur Ueberhitzung), live beim Tippen
        // ESP32-C6: warning above BACKLIGHT_C6_MAX_SAFE (Waveshare's note on overheating), live while typing

        if (BOARD_WAVESHARE_C6_ST7789) {
            html += "<div id='maxBrightWarn' style='color:#e67e22;margin:4px 0;" + String(maxBrightness > BACKLIGHT_C6_MAX_SAFE ? "" : "display:none;") + "'>&#9888; " +
                    translate("Above 128 the backlight of the ESP32-C6 board can overheat (note from Waveshare) - 128 or less is recommended") + "</div>";
        }
        html += "<br>";

        if (photoresistorFound) {
            html += "<div style='display:flex;align-items:center;gap:6px;white-space:nowrap;'><label style='width:280px;display:inline-block;white-space:normal;'>" + translate("Low Threshold") + " (0 - 100 %) : </label><input name = 'lowThreshold' type = 'number' min = '0' max = '100' value = '" + String(lowThreshold) + "' style='width:70px;'> " + infoTip(translate("Below this ambient light percentage, the display uses minimum brightness")) + "</div>";
            html += "<div style='display:flex;align-items:center;gap:6px;white-space:nowrap;'><label style='width:280px;display:inline-block;white-space:normal;'>" + translate("High Threshold") + " (0 - 100 %) : </label><input name = 'highThreshold' type = 'number' min = '0' max = '100' value = '" + String(highThreshold) + "' style='width:70px;'> " + infoTip(translate("Above this ambient light percentage, the display uses maximum brightness")) + "</div>";
        }

        if (useBacklight && photoresistorFound) { // Gamma formt die Kurve Lichtsensor -> PWM, gibt es also nur mit beidem
                                                  // gamma shapes the curve light sensor -> PWM, so only with both
        html += "<div style='display:flex;align-items:center;gap:6px;white-space:nowrap;'><label style='width:280px;display:inline-block;white-space:normal;'>" + translate("Gamma Correction") + " (0.1 - 3.0) : </label><input type='number' name='gamma' step='0.1' min='0.1' max='3.0' value='" + String(gammaBrightness) + "' required style='width:70px;'> " + infoTip(translate("Adjusts how brightness ramps between minimum and maximum - higher values keep the display darker for longer before brightening")) + "</div>";
        }

        return html;
    }


    // Liest ein GET/POST-Feld als int mit Validierung: fehlt/ungueltig ->
    // defaultValue statt stillschweigend 0, Ergebnis auf [minVal, maxVal] geklemmt.

    // Reads a GET/POST field as an int with validation: missing/invalid ->
    // defaultValue instead of silent 0, result clamped to [minVal, maxVal].

    int argToIntClamped(const String& name, int defaultValue, int minVal, int maxVal) {

        // defaultValue selbst wird ebenfalls geklemmt, sonst koennte ein Aufrufer
        // die Begrenzung fuer den "Feld fehlt"-Fall umgehen.

        // defaultValue itself is also clamped, otherwise a caller could bypass
        // the bound for the "field missing" case.

        if (defaultValue < minVal) defaultValue = minVal;
        if (defaultValue > maxVal) defaultValue = maxVal;

        if (!webserver.hasArg(name)) return defaultValue;
        String val = webserver.arg(name);
        val.trim();
        if (val.length() == 0) return defaultValue;
        for (size_t i = 0; i < val.length(); i++) {
            char c = val.charAt(i);
            bool isSign = (i == 0 && (c == '-' || c == '+'));
            if (!isDigit(c) && !isSign) return defaultValue;
        }
        long parsed = val.toInt();
        if (parsed < minVal) parsed = minVal;
        if (parsed > maxVal) parsed = maxVal;
        return (int)parsed;
    }


    // HTML-Label fuer einen Rotationswert - "n.a." bei TFT_ROTATION_NA (siehe
    // isDisplayConnected() in display.h), sonst 0/90/180/270 Grad. Gemeinsam
    // genutzt von /status und /api/status.

    // HTML label for a rotation value - "n.a." for TFT_ROTATION_NA (see
    // isDisplayConnected() in display.h), otherwise 0/90/180/270 degrees.
    // Shared by /status and /api/status.

    String rotationLabelHtml(uint8_t rotation) {
        static const char* labels[] = { "0&deg;", "90&deg;", "180&deg;", "270&deg;", "n.a." };
        return labels[rotation <= TFT_ROTATION_NA ? rotation : 0];
    }


    // Eintraege der Statusseite (<li>...) - gemeinsam fuer /status, den Tab Status und status.txt in der Sicherung.
    // flush() nimmt die Teilstuecke ab (Seiten: senden, Sicherung: sammeln), damit die Liste nicht als Ganzes im
    // Speicher liegt.

    // Entries of the status page (<li>...) - shared by /status, the Status tab and status.txt in the backup. flush()
    // takes the pieces (pages: send, backup: collect), so the list is never held in memory as a whole.

    void generateStatusItems(String& chunk, std::function<void(String&)> flush) {
        chunk += "<li>" + generateStorageInfo(LittleFS.usedBytes(), LittleFS.totalBytes(), true) + "</li>";

        String tzLabel = preferences.getString(PK_TIMEZONE, "DE");
        String tzDesc;

        tzDesc = tzLabel;

        // Lokale Kopie statt der globalen timeinfo - der Haupt-Loop nutzt sie ebenfalls, ein Fehlschlag
        // hier soll sie nicht mit einer ungueltigen Zwischenzeit ueberschreiben.

        // Local copy instead of the global timeinfo - the main loop uses it too, a failure here should
        // not overwrite it with an invalid intermediate time.

        struct tm statusTimeinfo;
        if (getLocalTime(&statusTimeinfo, 100)) {
            char nowStr[32];
            strftime(nowStr, sizeof(nowStr), "%Y-%m-%d %H:%M:%S", &statusTimeinfo);
            chunk += "<li>Current Time: " + String(nowStr) + "</li>";
            chunk += "<li>Timezone: " + tzDesc + "</li>";
            chunk += "<li>Current week: " + String(currentWeek) + "</li>";
            chunk += "<li>Last week reset: " + String(lastResetWeek) + "</li>";

            unsigned long seconds = millis() / 1000;
            unsigned long days = seconds / 86400;
            unsigned long hours = (seconds % 86400) / 3600;
            unsigned long minutes = (seconds % 3600) / 60;
            unsigned long secs = seconds % 60;
            chunk += "<li>Uptime: " + String(days) + "d " + String(hours) + "h " + String(minutes) + "m " + String(secs) + "s</li>";
            chunk += "<li>Last Reset Reason: " + resetReasonToString(esp_reset_reason()) + "</li>";
            chunk += "<li>RTC Status: " + rtcStatusToString(rtcOk) + "</li>";
            if (lastNtpSuccessMillis == 0) {
                chunk += "<li>Last NTP Sync: never</li>";
            }
            else {
                chunk += "<li>Last NTP Sync: " + formatDurationMs(millis() - lastNtpSuccessMillis) + " ago</li>";
            }

            chunk += "<br>";
        }

        flush(chunk);

        chunk += "<li>Compiled on: <strong>" + (String)version + "</strong></li><br>";

        chunk += "<li>TFT Driver: " + tftType + "</li>";
        chunk += "<li>Graphics Library: LovyanGFX " + String(LGFX_VERSION_MAJOR) + "." + String(LGFX_VERSION_MINOR) + "." + String(LGFX_VERSION_PATCH) + "</li>";

        // Bildrate der Uhranzeige (recordRenderFrame() in display.h) plus Zeigerstil - zur Diagnose ruckelnder/tickender Zeiger
        // frame rate of the clock display (recordRenderFrame() in display.h) plus hand style - for diagnosing jerky/ticking hands

        chunk += "<li>Render: " + String(renderStats.fps, 1) + " fps, avg " + String(renderStats.avgMs, 1) + " ms, max " + String(renderStats.maxMs, 1) + " ms, partial " + String(renderStats.partialPercent, 0) + " % (last 5 s)</li>";
        chunk += "<li>Second hand: " + String(smoothSecond ? "smooth" : "ticking") + ", station mode " + String(stationMode ? "on" : "off") + "</li>";

        chunk += "<li>TFT Size: " + String(TFT_WIDTH) + " x " + String(TFT_HEIGHT) + "</li>";

        chunk += "<br>";

        flush(chunk);

        chunk += "<li>Chip Model: " + String(ESP.getChipModel()) + "</li>";
        chunk += "<li>Chip Revision: " + String(ESP.getChipRevision()) + "</li>";
        chunk += "<li>Chip Cores: " + String(ESP.getChipCores()) + "</li>";
        chunk += "<li>Chip ID: " + String((uint32_t)ESP.getEfuseMac(), HEX) + "</li>";
        chunk += "<li>CPU Frequency: " + String(getCpuFrequencyMhz()) + " MHz</li><br>";

        flush(chunk);

        chunk += "<li>Hostname: " + String(hostname) + ".local" + "</li>";
        chunk += "<li>IP Address: " + WiFi.localIP().toString() + "</li>";
        chunk += "<li>MAC Address: " + WiFi.macAddress() + "</li>";
        chunk += "<li>WiFi SSID: " + String(WiFi.SSID()) + "</li>";
        chunk += "<li>WiFi Mode: " + String(WiFi.getMode() == WIFI_AP ? "WIFI_AP" : (WiFi.getMode() == WIFI_STA ? "WIFI_STA" : "AP_STA")) + "</li>";
        chunk += "<li>WiFi Channel: " + String(WiFi.channel()) + "</li>";
        chunk += "<li>WiFi TX Power: " + String(WiFi.getTxPower() / 4.0f, 1) + " dBm</li>";
#if HAS_OTA
        if (fwRemoteBuild.length()) chunk += "<li>Firmware on GitHub: " + fwRemoteBuild + (firmwareUpdateState() > 0 ? " (newer)" : "") + "</li>";
#endif
        chunk += "<li>Signal Strength (RSSI): " + String(WiFi.RSSI()) + " dBm</li>";

        // ntpServerRunning kommt vom echten Rueckgabewert von udp.begin()
        // (siehe startNtpServer()), nicht nur aus einem blinden Log.

        // ntpServerRunning comes from udp.begin()'s real return value
        // (see startNtpServer()), not just a blind log entry.

        chunk += "<li>NTP Server (own): " + String(ntpServerRunning ? "running on port " + String(NTP_PORT) : "not running") +
                 " - requests: " + String(ntpRequestsReceived) + ", answered: " + String(ntpRepliesSent) + "</li><br>";

        flush(chunk);

        chunk += "<li>SDK Version: " + String(ESP.getSdkVersion()) + "</li><br>";
        chunk += "<li>Arduino Core Version: " ESP_ARDUINO_VERSION_STR "</li><br>";

        flush(chunk);

        chunk += "<li>Flash Size: " + String(ESP.getFlashChipSize() / 1024) + " KB</li>";
        chunk += "<li>Free Heap: " + String(ESP.getFreeHeap() / 1024) + " KB</li>";
        chunk += "<li>Max Allocatable Block: " + String(ESP.getMaxAllocHeap() / 1024) + " KB</li>";
        chunk += "<li>Min Free Heap (since boot): " + String(ESP.getMinFreeHeap() / 1024) + " KB</li>";
        chunk += "<li>Max Sketch Size: " + String(ESP.getFreeSketchSpace() / 1024) + " KB</li>";
        chunk += "<li>Sketch Size: " + String(ESP.getSketchSize() / 1024) + " KB</li>";
        chunk += "<li>Free Sketch Space: " + String((ESP.getFreeSketchSpace() / 1024) - (ESP.getSketchSize() / 1024)) + " KB</li><br>";

        flush(chunk);

        // Explizite Erkennung, da ohne PSRAM Groesse/Frei beide 0 waeren
        // (nicht unterscheidbar von "PSRAM da, aber voll").

        // Explicit detection, since without PSRAM size/free would both
        // read 0 (indistinguishable from "PSRAM present but full").

        chunk += "<li>PSRAM Detected: " + String(psramFound() ? "yes" : "no") + "</li>";
        chunk += "<li>PSRAM Size: " + String(ESP.getPsramSize() / 1024) + " kB</li>";
        chunk += "<li>PSRAM Free: " + String(ESP.getFreePsram() / 1024) + " kB</li><br>";


        chunk += "<li>LittleFS Size: " + String(LittleFS.totalBytes() / 1024) + " KB</li>";
        chunk += "<li>LittleFS Used: " + String(LittleFS.usedBytes() / 1024) + " KB</li>";
        chunk += "<li>LittleFS Free: " + String((LittleFS.totalBytes() - LittleFS.usedBytes()) / 1024) + " KB</li><br>";

        flush(chunk);

        if (photoresistorFound) {
            chunk += "<li>Photoresistor found on GPIO: " + String(ADC_PIN) + "</li>";
            chunk += "<li>Actual brightness (0-255): " + String(currentBrightness) + "</li><br>";
        }
        else {
            chunk += "<li>Photoresistor not found on GPIO: " + String(ADC_PIN) + "</li><br>";
        }

        flush(chunk);



        chunk += "<li>TFT_SCLK GPIO: " + String(TFT_SCLK) + "</li>";
        //chunk += "<li>TFT_MISO: " + String(TFT_MISO) + "</li>";
        chunk += "<li>TFT_MOSI GPIO: " + String(TFT_MOSI) + "</li>";
        chunk += "<li>TFT_CS1 GPIO: " + String(CS_1) + " (Display 1)</li>"; // CS_1 = Display 1 (vormals TFT_CS, jetzt manuell angesteuert, siehe config.h)
                                                                 // CS_1 = display 1 (formerly TFT_CS, now driven manually, see config.h)
        if (HAS_DISPLAY2) chunk += "<li>TFT_CS2 GPIO: " + String(CS_2) + " (Display 2)</li>";


        chunk += "<li>TFT_DC GPIO: " + String(TFT_DC) + "</li>";
        chunk += "<li>TFT_RST GPIO: " + String(TFT_RST) + "</li><br>";

        if (!i2cAddr.isEmpty()) {
            chunk += "<li>I2C ADR: " + i2cAddr + "</li>";
            chunk += "<li>I2C SDA GPIO: " + String(SDA_PIN) + "</li>";
            chunk += "<li>I2C SCL GPIO: " + String(SCL_PIN) + "</li><br>";
        }
        else {
            chunk += "<li>I2C: no device found</li><br>";
        }

        flush(chunk);

        if (dcf77Count == 0) {
            chunk += "<li>DCF77 Status: No signal received so far</li>";
        }
        else {
            chunk += "<li>DCF77 Status: Pulses received</li>";
        }
        if (lastDcfSyncTime == 0) {
            chunk += "<li>DCF77 last sync: never</li>";
        }
        else {
            struct tm syncInfo;
            localtime_r(&lastDcfSyncTime, &syncInfo);
            char syncBuf[24];
            snprintf(syncBuf, sizeof(syncBuf), "%04d-%02d-%02d %02d:%02d:%02d",
                syncInfo.tm_year + 1900, syncInfo.tm_mon + 1, syncInfo.tm_mday,
                syncInfo.tm_hour, syncInfo.tm_min, syncInfo.tm_sec);
            chunk += "<li>DCF77 last sync: " + String(syncBuf) + "</li>";
        }
        chunk += "<li>DCF77 Data GPIO: " + String(DCF77_DATAPIN) + "</li>";  
        chunk += "<li>DCF77 Input: both edges (CHANGE), polarity-independent</li><br>";

        flush(chunk);

        chunk += "<li>BUTTON GPIO: " + String(BUTTON1) + "</li>";
        chunk += "<li>BUTTON_BOOT GPIO: " + String(BOOT_BUTTON) + "</li>";

        chunk += "<li>LED_BOARD GPIO: " + String(LED_BOARD_GPIO) + "</li>";
        chunk += "<li>ADC_VCC GPIO: " + String(ADC_3V) + "</li>";
        chunk += "<li>ADC (photoresistor) GPIO: " + String(ADC_PIN) + "</li>";
        chunk += "<li>ADC_GND GPIO: " + String(ADC_GND) + "</li>";
        if (photoresistorFound) {
            chunk += "<li>ADC Value: " + String(getAdjustedAdcValue(analogRead(ADC_PIN))) + "</li><br>";
        }


        chunk += "<li>Build: " BUILD_DISPLAY_MARKER "</li>";
        chunk += "<li>TFT_Backlight GPIO: " + String(TFT_Backlight) + (useBacklight ? " (PWM)" : " (off - pixel dimming)") + "</li>";
        chunk += "<br>";

        flush(chunk);

        chunk += "<li><h3>Actual Preferences</h3></li><ul>";

        for (int i = 0; i < MAX_WLAN; i++) {

            // Dynamisch berechnete Schlüssel
            // Dynamically computed keys

            String ssidKey = pkSsid(i);

            if (preferences.getString(ssidKey.c_str(), "") != "") {
                if (preferences.getInt(PK_LAST_WLAN) != i) {
                    chunk += "<li><b>" + ssidKey + ":</b> " + preferences.getString(ssidKey.c_str(), "") + "</li>";
                }
                else {
                    chunk += "<li><b>" + ssidKey + ": " + preferences.getString(ssidKey.c_str(), "") + "</b></li>";
                }
            }

        }

        flush(chunk);

        for (int i = 0; i < MAX_WLAN; i++) {
            if (preferences.getString((pkNtpServer(i)).c_str(), "") != "") {
                chunk += "<li><b>ntpServer" + String(i + 1) + ":</b> " + preferences.getString((pkNtpServer(i)).c_str(), "") + "</li>";
            }
        }
   

        chunk += "<li><b>timezone</b>: " + preferences.getString(PK_TIMEZONE, TIMEZONE_DEFAULT) + "</li>";
        chunk += "<li><b>background</b>: " + preferences.getString(PK_BACKGROUND, "/faces/default") + "</li>";
        chunk += "<li><b>handset</b>: " + preferences.getString(PK_HANDSET, "") + "</li>";

        // getLong() wie beim Schreiben (putLong()) - getUInt() lieferte wegen des NVS-Typs
        // stillschweigend den Default. Gespeichert ist RGB888.

        // getLong() as when writing (putLong()) - getUInt() would silently return the default due to the
        // NVS type. Stored is RGB888.

        chunk += "<li><b>centerColor (RGB888)</b>: " + String(preferences.getLong(PK_CENTER_COLOR, 0xEC0016), HEX) + "</li>";
        chunk += "<li><b>centerSize</b>: " + String(preferences.getUInt(PK_CENTER_SIZE, 6)) + "</li>";

        uint8_t rotation = preferences.getUChar(PK_TFT_ROTATION1, TFT_ROTATION1_DEFAULT);
        chunk += "<li><b>tftRotation1</b>: " + rotationLabelHtml(rotation) + (autoRotation ? " (auto)" : "") + "</li>";
        if (imuAvailable()) {
            int8_t q = imuReadQuadrant();
            chunk += "<li><b>IMU QMI8658</b>: " + (q < 0 ? String("flat/unclear") : "position " + String(q) + " -> " + rotationLabelHtml(imuRotationFor(q))) +
                     ", offset " + String(preferences.getUChar(PK_IMU_ROT_OFFSET, 0)) + "</li>";
        }
        {
            uint8_t rotation2 = preferences.getUChar(PK_TFT_ROTATION2, TFT_ROTATION2_DEFAULT);
            chunk += "<li><b>tftRotation2</b>: " + rotationLabelHtml(rotation2) + "</li>";
        }

        // Rotationsmodus zeigt, WIE die Werte angewendet werden: beim GC9D01
        // ist Hardware-Rotation wirkungslos, nur mit PSRAM wird auf
        // Software-Rotation umgeschaltet (siehe gc9d01SwRotation in uhr4.ino).

        // Rotation mode shows HOW the values are applied: on the GC9D01
        // hardware rotation has no effect, only with PSRAM does it switch to
        // software rotation (see gc9d01SwRotation in uhr4.ino).

        chunk += "<li><b>rotation mode</b>: ";
        if (gc9d01SwRotation) {
            chunk += "software (pixel remap, GC9D01 with PSRAM)";
        }
        else {
            chunk += "hardware (display MADCTL register)";
            if (displayGeom->swRotation) chunk += " - <b>ineffective on GC9D01</b>, software rotation needs PSRAM";
        }
        chunk += "</li>";

        flush(chunk);

        // Booleans als Text
        // Booleans as text
    
        bool stationModeStatus = preferences.getBool(PK_STATION_MODE, true);
        chunk += "<li><b>stationMode</b>: " + String(stationModeStatus ? "true" : "false") + "</li>";
        chunk += "<li><b>smoothSecond</b>: " + String(getSmoothSecondPref(stationModeStatus) ? "true" : "false") + "</li>";
        chunk += "<li><b>showSecondhand</b>: " + String(preferences.getBool(PK_SHOW_SECOND_HAND, true) ? "true" : "false") + "</li>";
        chunk += "<li><b>smoothMinute</b>: " + String(preferences.getBool(PK_SMOOTH_MINUTE, false) ? "true" : "false") + "</li>";

        chunk += "<li><b>minBrightness</b>: " + String(preferences.getUChar(PK_MIN_BRIGHTNESS, 100)) + "</li>";
        chunk += "<li><b>useBacklight</b>: " + String(preferences.getBool(PK_USE_BACKLIGHT, BACKLIGHT_DEFAULT) ? "true" : "false") + "</li>";
        chunk += "<li><b>maxBrightness</b>: " + String(preferences.getUChar(PK_MAX_BRIGHTNESS, 255)) + "</li>";

        chunk += "<li><b>daywindow</b>: " + dayWindowText() + "</li>";

        if (preferences.getBool(PK_USE_ADC, true)) {
            chunk += "<li><b>use_adc</b>: " + String(preferences.getBool(PK_USE_ADC, true) ? "true" : "false") + "</li>";
            chunk += "<li><b>adc lowThreshold</b>: " + String(preferences.getInt(PK_LOW_THRESHOLD, 40)) + "</li>";
            chunk += "<li><b>adc highThreshold</b>: " + String(preferences.getInt(PK_HIGH_THRESHOLD, 60)) + "</li>";
            chunk += "<li><b>adc Inverted</b>: " + String(preferences.getBool(PK_ADC_INVERTED, false) ? "true" : "false") + "</li>";
        }
        if (preferences.getBool(PK_ROCRAIL_ENABLED, false)) {
            chunk += "<li><b>rocrailEnabled</b>: " + String(preferences.getBool(PK_ROCRAIL_ENABLED, false) ? "true" : "false") + "</li>";
            chunk += "<li><b>rocrailServer</b>: " + preferences.getString(PK_ROCRAIL_SERVER, "") + "</li>";
            chunk += "<li><b>rocrailServerPort</b>: " + String(preferences.getUShort(PK_ROCRAIL_SRV_PORT, ROCRAIL_DEFAULT_PORT)) + "</li>";
        }
        flush(chunk);
    }


    // Webserver-API-Endpunkte einrichten
    // Set up the webserver API endpoints

    void setupWebServer() {

        // Captive-Portal-Erkennung: bekannte OS-URLs auf die Konfigseite umleiten
        // statt 404, damit sich am AP automatisch ein Browserfenster oeffnet.

        // Captive portal detection: redirect known OS URLs to the config page
        // instead of 404, so a browser window opens automatically on the AP.

        auto captivePortalRedirect = []() {
            redirectTo("http://" + ipAddress + "/");
            };

        webserver.on("/generate_204", HTTP_GET, captivePortalRedirect);       // Android
        webserver.on("/gen_204", HTTP_GET, captivePortalRedirect);            // Android (aeltere Versionen)
                                                                              // Android (older versions)
        webserver.on("/hotspot-detect.html", HTTP_GET, captivePortalRedirect); // iOS
                                                                               // macOS
        webserver.on("/library/test/success.html", HTTP_GET, captivePortalRedirect); // iOS
                                                                                     // macOS (alternative)
        webserver.on("/ncsi.txt", HTTP_GET, captivePortalRedirect);           // Windows
        webserver.on("/connecttest.txt", HTTP_GET, captivePortalRedirect);    // Windows
                                                                              // Catch-all: alle sonstigen Anfragen ebenfalls auf die Konfigseite leiten

        // Catch-all: redirect all other requests to the config page too

        webserver.onNotFound(captivePortalRedirect);

        // API fuer Zifferblatt, Zeiger, Zeitzone, Nabe, Bahnhofsmodus, Rotation und Zeigerstil, z.B.
        // /api/setMode?face=face_default.bmp&handSet=0&stationMode=true - Helligkeit optional (minBrightness,
        // maxBrightness, brightStart, brightEnd, lowThreshold, highThreshold, gamma, autoBrightness).

        // API for clock face, hands, time zone, hub, station mode, rotation and hand style, e.g.
        // /api/setMode?face=face_default.bmp&handSet=0&stationMode=true - brightness optional (minBrightness,
        // maxBrightness, brightStart, brightEnd, lowThreshold, highThreshold, gamma, autoBrightness).



        webserver.on("/setLanguage", HTTP_POST, []() {
            if (webserver.hasArg("lang")) {
                String lang = webserver.arg("lang");
                if (lang == "en") {
                    saveLanguage(lang);
                    // webserver.send(200, "text/plain", "Language updated to " + lang);
                    redirectTo("/?msg=Language%20updated");
                    return;
                }

                if (availableLanguages.count(lang)) {
                    saveLanguage(lang);
                    // webserver.send(200, "text/plain", "Language updated to " + lang);
                    redirectTo("/?msg=Language%20updated");
                    return;
                }
                else {
                    webserver.send(400, "text/plain", "Invalid language");
                }
            }
            else {
                webserver.send(400, "text/plain", "Missing 'lang' parameter");
            }
            });

        // Startet WPS per Web-Button, kehrt SOFORT zurueck - kein delay(),
        // sonst koennte der Webserver die Redirect-Zielseite nicht
        // ausliefern. startWPS() selbst laeuft zeitversetzt in loop() (siehe wpsStartRequested in globals.h).

        // Starts WPS via web button, returns IMMEDIATELY - no delay(),
        // otherwise the web server couldn't serve the redirect's target
        // page. startWPS() itself runs deferred in loop() (see wpsStartRequested in globals.h).

        webserver.on("/api/startWPS", HTTP_GET, []() {
            wpsPreviousSsid = WiFi.isConnected() ? WiFi.SSID() : "";
            redirectTo("/?tab=wlan&msg=WPS%20active%20-%20press%20the%20WPS%20button%20on%20your%20router%20now.%20Connection%20to%20the%20clock%20may%20be%20lost%20for%20about%202%20minutes%20while%20this%20happens");
            wpsStartRequested = true;
            wpsStartRequestedAtMillis = millis();
            });

        webserver.on("/api/startWPS", HTTP_POST, []() {
            wpsPreviousSsid = WiFi.isConnected() ? WiFi.SSID() : "";
            redirectTo("/?tab=wlan&msg=WPS%20active%20-%20press%20the%20WPS%20button%20on%20your%20router%20now.%20Connection%20to%20the%20clock%20may%20be%20lost%20for%20about%202%20minutes%20while%20this%20happens");
            wpsStartRequested = true;
            wpsStartRequestedAtMillis = millis();
            });

        // Liefert, ob WPS noch aktiv/wartend ist (wpsPending oder ein
        // angeforderter, noch nicht gestarteter Versuch) - fuer das Banner-
        // Polling in generateFlashMessage(), das den Hinweis so lange zeigt, wie WPS tatsaechlich laeuft.

        // Reports whether WPS is still active/waiting (wpsPending, or a
        // requested but not yet started attempt) - used by the banner
        // polling in generateFlashMessage(), which shows the notice for as long as WPS is actually running.

        webserver.on("/api/wpsStatus", HTTP_GET, []() {
            webserver.sendHeader("Cache-Control", "no-store");
            bool active = wpsPending || wpsStartRequested;
            webserver.send(200, "application/json", String("{\"pending\":") + (active ? "true" : "false") + "}");
            });

        // Speichert einen Hostnamen (siehe sanitizeHostname()) - wirkt erst
        // nach einem Neustart, da connectWiFi() das nur einmalig aufruft.

        // Saves a hostname (see sanitizeHostname()) - only takes effect
        // after a reboot, since connectWiFi() only calls this once.

        webserver.on("/sethostname", HTTP_POST, []() {
            if (webserver.hasArg("hostname")) {
                String newHostname = sanitizeHostname(webserver.arg("hostname"));

                if (newHostname.isEmpty()) {

                    // Kein gueltiger Hostname extrahierbar - Override entfernen,
                    // damit wieder der automatische Name generiert wird.

                    // No valid hostname could be extracted - remove the override
                    // so the automatic name is generated again.

                    preferences.remove(PK_HOSTNAME);
                    redirectTo("/?tab=wlan&warn=No%20valid%20hostname%20could%20be%20derived%20from%20the%20input%20-%20falling%20back%20to%20the%20automatic%20name%20based%20on%20the%20MAC%20address");
                    return;
                }

                preferences.putString(PK_HOSTNAME, newHostname);
                redirectTo("/?tab=wlan&msg=Hostname%20saved%20-%20requires%20a%20reboot%20to%20take%20effect");
            }
            else {
                webserver.send(400, "text/plain", "Missing parameter");
            }
            });

        webserver.on("/api/createPreset", HTTP_POST, []() {
            String customName = webserver.hasArg("name") ? webserver.arg("name") : "";
            bool created = createPresetFromPreferences(customName); // Erstellt ein neues Preset, falls noch ein Slot frei ist
                                                                    // creates a new preset if a slot is still free

            if (!created) {
                String html = beginPage();
                html += "<h2 style='color:red;'>" + translate("Maximum number of presets reached - delete an existing preset first") + "</h2>";
                html += "<a href='/presets'><button type='button'>" + translate("Back") + "</button></a>";
                html += "</body></html>";
                webserver.send(200, "text/html", html);
                return;
            }

            // Weiterleitung zur Presets-Seite
            // Redirect to the presets page

            redirectTo("/presets?msg=Preset%20created", "Redirecting to /presets..");
            });

        // API zum Setzen von Uhrmodus und anderen Einstellungen
        // API to set clock mode and other settings

        webserver.on("/api/setMode", HTTP_GET, []() {
            Serial.println("[API] Received GET request to /api/setMode with arguments");
            if (webserver.hasArg("face")) {
                String face = webserver.arg("face");
               // face.replace(".", "");
                if (!face.startsWith("/")) face = "/" + face;
                if (face == "/face_default.bmp" || LittleFS.exists(face)) {
                    preferences.putString(PK_BACKGROUND, face);
                    selectedBackground = face;
                }
            }

            if (webserver.hasArg("handSet")) {
                String handSet = webserver.arg("handSet");
                preferences.putString(PK_HANDSET, handSet);
            }

            // Nur bei echter Aenderung - jedes Preset enthaelt die Zeitzone, sonst stiesse jeder Aufruf einen
            // NTP-Abgleich an.

            // Only on an actual change - every preset contains the time zone, otherwise every call would trigger
            // an NTP sync.

            if (webserver.hasArg("timeZone") && webserver.arg("timeZone") != timezone) {
                String tz = webserver.arg("timeZone");
                preferences.putString(PK_TIMEZONE, tz);
                timezone = tz;
                applyTimezoneToSystem(); // sofort wirksam, auch ohne erreichbaren NTP-Server
                                         // effective right away, even without a reachable NTP server

                // Nur die Task anstossen (siehe time_sync.h) statt hier auf
                // DNS/UDP zu warten - der Webserver darf dabei nicht blockieren.
                // pollNtpSyncTask() in loop() wertet das Ergebnis aus.

                // Only kick off the task (see time_sync.h) instead of waiting
                // on DNS/UDP here - the web server must not block on this.
                // pollNtpSyncTask() in loop() evaluates the result.

                startNtpSyncTask("Timezone change sync");
            }

            updateNtpServersFromRequest();

            if (webserver.hasArg("hubSize")) {
                hubSize = argToIntClamped("hubSize", hubSize, 0, 100);
                preferences.putUInt(PK_CENTER_SIZE, hubSize);
            }
            if (webserver.hasArg("hubColor")) {
                uint32_t rgb = strtoul(webserver.arg("hubColor").c_str(), NULL, 16); // 24-Bit RGB

                // 24-bit RGB
                // DEBUG_PRINTLN("[API] Received hubColor: " + webserver.arg("hubColor") + " -> " + String(rgb, HEX));

                uint8_t r = (rgb >> 16) & 0xFF; // Rot extrahieren
                                                // extract red
                uint8_t g = (rgb >> 8) & 0xFF;  // Grün extrahieren
                                                // extract green
                uint8_t b = rgb & 0xFF;         // Blau extrahieren
                                                // extract blue

                // Konvertiere RGB888 zu RGB565
                // Convert RGB888 to RGB565

                hubColor = ((r & 0xF8) << 8) | ((g & 0xFC) << 3) | (b >> 3);
                preferences.putLong(PK_CENTER_COLOR, rgb);
            }


            if (webserver.hasArg("stationMode")) {
                String stationModeArg = webserver.arg("stationMode");
                stationMode = (stationModeArg == "1" || stationModeArg.equalsIgnoreCase("true")); // Konvertiere zu bool
                                                                                                  // convert to bool
                preferences.putBool(PK_STATION_MODE, stationMode);
            }

            // Rocrail-Modellzeit an/aus (nur bei Aenderung) - die Serveradressen bleiben Geraeteeinstellung
            // Rocrail model time on/off (only on a change) - the server addresses stay a device setting

            if (webserver.hasArg("rocrail")) {
                String rocrailArg = webserver.arg("rocrail");
                bool on = (rocrailArg == "1" || rocrailArg.equalsIgnoreCase("true"));
                if (on != rocrailEnabled) setRocrailEnabled(on);
            }

            // "WLAN neu verbinden" (wifiActive) - loop() prueft es bei jedem Durchlauf
            // "Reconnect WiFi" (wifiActive) - loop() checks it on every pass

            if (webserver.hasArg("wifiReconnect")) {
                String wifiArg = webserver.arg("wifiReconnect");
                bool on = (wifiArg == "1" || wifiArg.equalsIgnoreCase("true"));
                if (on != wifiActive) {
                    wifiActive = on;
                    preferences.putBool(PK_WIFI_ACTIVE, on);
                }
            }

            // Rotation NICHT aus Presets (source=preset) - sie ist eine Geraeteeinstellung; alte Preset-URLs
            // enthalten noch "rotation=". Direkte API-Aufrufe duerfen sie weiter setzen.

            // Rotation NOT from presets (source=preset) - it is a device setting; old preset URLs still
            // contain "rotation=". Direct API calls may still set it.

            if (webserver.hasArg("rotation") && webserver.arg("source") != "preset") {
                String rotationArg = webserver.arg("rotation");

                // Eigener Name statt "tftRotation" (wuerde die globale Variable verdecken). Als long, damit
                // z.B. "rotation=256" nicht vor der Pruefung zu 0 abgeschnitten wird.

                // Own name instead of "tftRotation" (would shadow the global variable). As long, so e.g.
                // "rotation=256" is not truncated to 0 before validation.

                long requestedRotation = -1;

                // Prüfe, ob der Wert in Grad angegeben ist
                // Check whether the value is given in degrees

                if (rotationArg == "0" || rotationArg == "90" || rotationArg == "180" || rotationArg == "270") {
                    if (rotationArg == "0") requestedRotation = 0;
                    else if (rotationArg == "90") requestedRotation = 1;
                    else if (rotationArg == "180") requestedRotation = 2;
                    else if (rotationArg == "270") requestedRotation = 3;
                }

                // "na" / "n.a." = Display 1 nicht angeschlossen
                // "na" / "n.a." = display 1 not connected

                else if (rotationArg.equalsIgnoreCase("na") || rotationArg.equalsIgnoreCase("n.a.")) {
                    requestedRotation = TFT_ROTATION_NA;
                }

                // Prüfe, ob der Wert als Index (0-3, 4 = n.a.) angegeben ist
                // Check whether the value is given as an index (0-3, 4 = n.a.)

                else {
                    requestedRotation = rotationArg.toInt();
                }

                // Validierung des Wertes
                // Validate the value

                if (requestedRotation >= 0 && requestedRotation <= TFT_ROTATION_NA) {
                    applyDisplayRotation(1, (uint8_t)requestedRotation);
                }
            }

   
            if (webserver.hasArg("showSecondHand")) {
                String showSecondHandArg = webserver.arg("showSecondHand");
                showSecondHand = (showSecondHandArg == "1" || showSecondHandArg.equalsIgnoreCase("true")); // Konvertiere zu bool
                                                                                                           // convert to bool
                preferences.putBool(PK_SHOW_SECOND_HAND, showSecondHand);
            }

            if (webserver.hasArg("smoothMinute")) {
                String smoothMinuteArg = webserver.arg("smoothMinute");
                smoothMinute = (smoothMinuteArg == "1" || smoothMinuteArg.equalsIgnoreCase("true")); // Konvertiere zu bool
                                                                                                     // convert to bool
                preferences.putBool(PK_SMOOTH_MINUTE, smoothMinute);
            }

            if (webserver.hasArg("smoothSecond")) {
                String smoothSecondArg = webserver.arg("smoothSecond");
                smoothSecond = (smoothSecondArg == "1" || smoothSecondArg.equalsIgnoreCase("true")); // Konvertiere zu bool
                                                                                                     // convert to bool
                preferences.putBool(PK_SMOOTH_SECOND, smoothSecond);
            }

            // Helligkeit aus Presets (applyBrightnessPresetValue() in display.h,
            // gleiche Klemmung wie beim Weiterschalten per Taste)

            // Brightness from presets (applyBrightnessPresetValue() in display.h,
            // same clamping as when switching via the button)

            static const char* const brightnessKeys[] = {
                "minBrightness", "maxBrightness", "brightStart", "brightEnd",
                "lowThreshold", "highThreshold", "gamma", "autoBrightness"
            };
            for (const char* key : brightnessKeys) {
                if (webserver.hasArg(key)) applyBrightnessPresetValue(key, webserver.arg(key));
            }

            // Der Streifen gehoert zum Zifferblatt (stripcfg_*.txt) - Streifen-Werte aelterer Presets bleiben unbeachtet
            // The strip belongs to the clock face (stripcfg_*.txt) - strip values of older presets are ignored

            freeClockFaceBuffer();
            loadClockFace();
            loadHandSprites();
            updateClock();

            if (webserver.hasArg("source")) {
                String sourceArg = webserver.arg("source");
                if (sourceArg == "preset") {
                    // DEBUG_PRINTLN("[API] Request source: preset");

                    // Mit ajax=1 (Seite /presets ohne Neuladen) genuegt die Bestaetigung
                    // With ajax=1 (page /presets without reloading) the confirmation is enough

                    if (webserver.arg("ajax") == "1") {
                        webserver.send(200, "text/plain", "ok");
                        return;
                    }
                    redirectTo("/presets?msg=Preset%20applied", "Redirecting to /presets..");
                    return;
                }
            }

            webserver.send(200, "text/plain", "ok");
            });

        // Preset-Verwaltung
        // Preset management

        webserver.on("/presets", HTTP_GET, []() {
            webserver.setContentLength(CONTENT_LENGTH_UNKNOWN);
            webserver.send(200, "text/html", "");

            String chunk = beginPage();
            chunk.reserve(1024);
            chunk += generateFlashMessage();
            chunk += "<h2>" + translate("Manage Presets") + "</h2>";

            // Links oben anzeigen
            // Show links at the top

            chunk += "<div style='text-align:center;'>";

            if (pingHostname) {
                chunk += "<p>" + translate("Use the host name") + " <strong>" + String(hostname) + ".local</strong> " + translate("instead of the IP address for better reliability") + ".</p>";
            }

            chunk += "<ul style='list-style-type:none; padding:0; display:inline-block; text-align:left;'>";

         
            String espHost = "http://" + String(hostname) + ".local"; // Aktueller Hostname des ESP
                                                                      // current hostname of the ESP

            chunk += "<script>";
            chunk += "function copyPresetLink(text, el) {";
            chunk += "  function showCopied() {";
            chunk += "    var original = el.innerHTML;";
            chunk += "    el.innerHTML = '&#9989;';";
            chunk += "    setTimeout(function() { el.innerHTML = original; }, 1200);";
            chunk += "  }";
            chunk += "  if (navigator.clipboard && navigator.clipboard.writeText) {";
            chunk += "    navigator.clipboard.writeText(text).then(showCopied);";
            chunk += "  } else {";
            chunk += "    var temp = document.createElement('textarea');";
            chunk += "    temp.value = text;";
            chunk += "    document.body.appendChild(temp);";
            chunk += "    temp.select();";
            chunk += "    document.execCommand('copy');";
            chunk += "    document.body.removeChild(temp);";
            chunk += "    showCopied();";
            chunk += "  }";
            chunk += "}";
            chunk += "</script>";

            chunk += "<div style='display:flex;flex-wrap:wrap;gap:18px;justify-content:center;align-items:flex-start;'>";

            webserver.sendContent(chunk);
            chunk = "";

            // Nur die Anzeige-Reihenfolge sortieren, Array-Indizes bleiben
            // unveraendert, damit Rename-/Delete-Links stimmen.

            // Only sort the display order, array indices stay unchanged so
            // rename/delete links remain correct.
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
