holgiw/TFT-Clock-GC9A01/display.h

#pragma once

    // Display: Zifferblatt, Zeiger, Sprites, Helligkeit (benoetigt globals.h, config.h, prefs_keys.h,
    // declarations.h). Kurzlebige Puffer (BMP/PNG im Webinterface) bevorzugt im PSRAM, um den internen Heap
    // nicht zu zerstueckeln; new (std::nothrow) liefert bei Fehlschlag sicher nullptr.

    // Display: clock face, hands, sprites, brightness (requires globals.h, config.h, prefs_keys.h,
    // declarations.h). Short-lived buffers (BMP/PNG in the web interface) preferably in PSRAM, so the
    // internal heap does not fragment; new (std::nothrow) reliably returns nullptr on failure.

#include <new>

    void* preferPsramMalloc(size_t size) {
        if (psramFound()) {
            void* p = ps_malloc(size);
            if (p) return p;
        }
        return malloc(size);
    }


    // Ein Display gilt als angeschlossen, solange seine Rotation nicht "n.a." ist
    // A display counts as connected as long as its rotation is not "n.a."

    bool isDisplayConnected(uint8_t displayNum) {
        return ((displayNum == 1) ? tftRotation1 : tftRotation2) != TFT_ROTATION_NA;
    }


    // Rotation des ersten angeschlossenen Displays (Display 1 hat Vorrang), nie "n.a."
    // Rotation of the first connected display (display 1 takes priority), never "n.a."

    uint8_t primaryDisplayRotation() {
        if (isDisplayConnected(1)) return tftRotation1;
        if (isDisplayConnected(2)) return tftRotation2;
        return 0;
    }


    // Rotation fuer Status-/Startmeldungen eines Displays: bei "n.a." 0 Grad, nie der Wert 4
    // Rotation for status/boot messages of a display: 0 degrees for "n.a.", never the value 4

    uint8_t effectiveRotation(uint8_t displayNum) {
        return isDisplayConnected(displayNum) ? ((displayNum == 1) ? tftRotation1 : tftRotation2) : 0;
    }


    // Streifen neben der Uhr (nur rechteckige Displays wie das ILI9341): hochkant unter der Uhr, quer
    // (Rotation 90/270 Grad) rechts daneben - mit stripBefore ueber bzw. links davon. false ohne Streifen.

    // Strip next to the clock (rectangular displays like the ILI9341 only): portrait below the clock,
    // landscape (rotation 90/270 degrees) to its right - with stripBefore above or left of it. false without a strip.

    bool infoStripRect(uint8_t displayNum, int& x, int& y, int& w, int& h, bool& landscape) {
        if (TFT_WIDTH == CLOCK_WIDTH && TFT_HEIGHT == CLOCK_HEIGHT) return false;
        landscape = (effectiveRotation(displayNum) % 2) == 1;
        int pw = landscape ? TFT_HEIGHT : TFT_WIDTH;
        int ph = landscape ? TFT_WIDTH : TFT_HEIGHT;
        w = (pw > CLOCK_WIDTH) ? pw - CLOCK_WIDTH : pw;
        h = (pw > CLOCK_WIDTH) ? ph : ph - CLOCK_HEIGHT;
        x = (!stripBefore && pw > CLOCK_WIDTH) ? CLOCK_WIDTH : 0;
        y = (!stripBefore && pw <= CLOCK_WIDTH) ? CLOCK_HEIGHT : 0;
        return true;
    }


    // Linke obere Ecke der Uhr auf dem Display - nur verschoben, wenn der Streifen davor liegt (stripBefore)
    // Top left corner of the clock on the display - only shifted when the strip lies before it (stripBefore)

    void clockOrigin(uint8_t displayNum, int& ox, int& oy) {
        ox = oy = 0;
        int x, y, w, h;
        bool landscape;
        if (!stripBefore || !infoStripRect(displayNum, x, y, w, h, landscape)) return;
        if (landscape) ox = w; else oy = h;
    }


    // Displaytypen dieses Boards: der S2 alle wechselbaren, das C6 die fest verbauten ST7789 (1.47 / 1.3),
    // das S3 sein fest verbautes GC9A01

    // Display types of this board: the S2 all exchangeable ones, the C6 the built-in ST7789 (1.47 / 1.3),
    // the S3 its built-in GC9A01

    bool displayTypeSupported(uint8_t type) {
        bool c6Type = type == DISPLAY_TYPE_ST7789 || type == DISPLAY_TYPE_ST7789_240;
        if (BOARD_WAVESHARE_S3_GC9A01) return type == DISPLAY_TYPE_GC9A01;
        return BOARD_WAVESHARE_C6_ST7789 ? c6Type : type < DISPLAY_TYPE_COUNT && !c6Type;
    }

    // Namen der Displaytypen dieses Boards fuer Fehlermeldungen an flashESP
    // Names of this board's display types for error messages to flashESP

    const char* supportedDisplayNames() {
        if (BOARD_WAVESHARE_S3_GC9A01) return "GC9A01, GC9A01_WITH_BACKLIGHT";
        return BOARD_WAVESHARE_C6_ST7789 ? "ST7789, ST7789_240" : "GC9A01, GC9A01_WITH_BACKLIGHT, GC9D01, ILI9341";
    }

    // Displayname wie bei den uhr3-Builds und in flashESP ("GC9A01", "GC9A01_WITH_BACKLIGHT", "GC9D01",
    // "ILI9341", "ST7789", "ST7789_240") -> Displaytyp + Backlight-Regelung; false auch fuer Typen, die
    // dieses Board nicht kennt. Das ILI9341 hat wie in uhr3 feste Beleuchtung.

    // Display name as in the uhr3 builds and in flashESP ("GC9A01", "GC9A01_WITH_BACKLIGHT", "GC9D01",
    // "ILI9341", "ST7789", "ST7789_240") -> display type + backlight control; false also for types this
    // board does not know. The ILI9341 has a fixed backlight as in uhr3.

    bool parseDisplayName(const String& name, uint8_t& type, bool& backlight) {
        if (name == "GC9A01") { type = DISPLAY_TYPE_GC9A01; backlight = false; }
        else if (name == "GC9A01_WITH_BACKLIGHT") { type = DISPLAY_TYPE_GC9A01; backlight = true; }
        else if (name == "GC9D01") { type = DISPLAY_TYPE_GC9D01; backlight = true; }
        else if (name == "ILI9341") { type = DISPLAY_TYPE_ILI9341; backlight = false; }
        else if (name == "ST7789") { type = DISPLAY_TYPE_ST7789; backlight = true; }
        else if (name == "ST7789_240") { type = DISPLAY_TYPE_ST7789_240; backlight = true; }
        else return false;
        return displayTypeSupported(type);
    }

    // Umkehrung von parseDisplayName(): beim GC9D01 und ST7789 (Beleuchtung immer am Pin) und ILI9341 (feste
    // Beleuchtung) zaehlt die Backlight-Einstellung nicht.

    // Inverse of parseDisplayName(): for the GC9D01 and ST7789 (backlight always on the pin) and the ILI9341
    // (fixed backlight) the backlight setting does not matter.

    const char* displayChoiceName(uint8_t type, bool backlight) {
        if (type == DISPLAY_TYPE_GC9D01) return "GC9D01";
        if (type == DISPLAY_TYPE_ILI9341) return "ILI9341";
        if (type == DISPLAY_TYPE_ST7789) return "ST7789";
        if (type == DISPLAY_TYPE_ST7789_240) return "ST7789_240";
        return backlight ? "GC9A01_WITH_BACKLIGHT" : "GC9A01";
    }

    // Update von uhr3: dessen Firmware vermerkt ihren Displaytyp (PK_UHR3_BUILD_DISPLAY). Uebernommen nur,
    // solange uhr4 noch keinen hat - sonst stellte ein zwischendurch geflashter uhr3-Build die Uhr um. Der
    // Vermerk wird immer geloescht.

    // Update from uhr3: its firmware records its display type (PK_UHR3_BUILD_DISPLAY). Taken over only while
    // uhr4 has none yet - otherwise a uhr3 build flashed in between would switch the clock. The record is
    // always deleted.

    void adoptUhr3BuildDisplay() {
        if (!preferences.isKey(PK_UHR3_BUILD_DISPLAY)) return;
        String build = preferences.getString(PK_UHR3_BUILD_DISPLAY, "");
        preferences.remove(PK_UHR3_BUILD_DISPLAY);
        if (preferences.isKey(PK_DISPLAY_TYPE)) {
            DEBUG_PRINTLN("[Display] uhr3 build display '" + build + "' ignored - display type already set in uhr4");
            return;
        }

        uint8_t type;
        bool backlight;
        if (!parseDisplayName(build, type, backlight)) {
            DEBUG_PRINTLN("[Display] uhr3 build display '" + build + "' not supported by uhr4 - keeping display type");
            return;
        }
        preferences.putUChar(PK_DISPLAY_TYPE, type);
        preferences.putBool(PK_USE_BACKLIGHT, backlight);
        DEBUG_PRINTLN("[Display] Update from uhr3 (" + build + "): display type " + DISPLAY_GEOMETRY[type].name + ", backlight " + (backlight ? "on" : "off"));
    }


    // Liest den Displaytyp aus den Preferences und stellt displayGeom darauf
    // um - MUSS vor allem laufen, was CLOCK_WIDTH/HAND_* benutzt (Migrationen,
    // Sprites, Puffer), daher direkt nach preferences.begin() in setup().

    // Reads the display type from preferences and points displayGeom at it -
    // MUST run before anything that uses CLOCK_WIDTH/HAND_* (migrations,
    // sprites, buffers), hence right after preferences.begin() in setup().

    void loadDisplayType() {
        adoptUhr3BuildDisplay();
        uint8_t type = preferences.getUChar(PK_DISPLAY_TYPE, DISPLAY_TYPE_DEFAULT);
        if (!displayTypeSupported(type)) type = DISPLAY_TYPE_DEFAULT; // beschaedigter NVS-Wert oder anderes Board
                                                                      // corrupted NVS value or another board
        displayType = type;
        displayGeom = &DISPLAY_GEOMETRY[type];
        tftType = displayGeom->name;

        // Standard-Zeigerbreiten des Typs - parseBackgroundFilename() passt sie
        // spaeter je Zifferblatt an.

        // Default hand widths of the type - parseBackgroundFilename() adjusts
        // them per clock face later.

        hourHandWidth = minuteHandWidth = secondHandWidth = HAND_WIDTH;

        DEBUG_PRINTLN(String("[Display] Type: ") + displayGeom->name + " (" + String(CLOCK_WIDTH) + "x" + String(CLOCK_HEIGHT) + ")");
    }


    // Neuen Displaytyp samt typabhaengigen Werksvorgaben speichern (wirkt nach dem Neustart). Hardware-Reset
    // beider Displays mit den Zeiten von uhr3 (20 ms Puls, 150 ms Pause) - bei den 64 ms von LovyanGFX blieb
    // das GC9D01 schwarz, daher pin_rst = -1.

    // Store a new display type with type-dependent factory defaults (effective after the restart). Hardware
    // reset of both displays with uhr3's timing (20 ms pulse, 150 ms wait) - with LovyanGFX's 64 ms the
    // GC9D01 stayed black, hence pin_rst = -1.

    void resetPanels() {
        pinMode(TFT_RST, OUTPUT);
        digitalWrite(TFT_RST, HIGH);
        delay(5);
        digitalWrite(TFT_RST, LOW);
        delay(20);
        digitalWrite(TFT_RST, HIGH);
        delay(150);
    }


    // Speichert Displaytyp + Backlight-Regelung (Auswahl wie
    // parseDisplayName()) samt den passenden Standardwerten - wirkt erst nach
    // dem Neustart (Aufrufer startet neu).

    // Stores display type + backlight control (choice as in
    // parseDisplayName()) together with the matching defaults - takes effect
    // only after the restart (the caller restarts).

    void setDisplayType(uint8_t type, bool backlight) {
        if (!displayTypeSupported(type)) return;
        const DisplayGeometry& g = DISPLAY_GEOMETRY[type];
        preferences.putUChar(PK_DISPLAY_TYPE, type);
        preferences.putBool(PK_USE_BACKLIGHT, backlight);
        putBrightnessDefaults(backlight);
        preferences.putUInt(PK_CENTER_SIZE, g.centerSize);
        DEBUG_PRINTLN(String("[Display] Type changed to ") + displayChoiceName(type, backlight) + ", restarting");
    }


    // Hex-Text -> Bytes als String (fuer WLAN-Name/-Passwort per USB, damit
    // Leerzeichen, Umlaute und Sonderzeichen sicher ankommen). false bei
    // ungueltigem Hex oder mehr als maxLen Bytes.

    // Hex text -> bytes as a string (for WiFi name/password via USB, so that
    // spaces, umlauts and special characters arrive safely). false on invalid
    // hex or more than maxLen bytes.

    bool hexToText(const String& hex, String& out, size_t maxLen) {
        out = "";
        if (hex.length() % 2 || hex.length() / 2 > maxLen) return false;
        for (size_t i = 0; i < hex.length(); i += 2) {
            char pair[3] = { hex[i], hex[i + 1], 0 };
            if (!isxdigit((uint8_t)pair[0]) || !isxdigit((uint8_t)pair[1])) return false;
            out += (char)strtol(pair, nullptr, 16);
        }
        return true;
    }


    // Einrichtung per USB (flashESP, setTime), zeilenweise: "UHR4 WIFI <Name-Hex> <Passwort-Hex>", "UHR4
    // DISPLAY <Name>", "UHR4 RESTART", "UHR4 INFO", "UHR4 TIME <Unix-Sek.>" - Antwort "UHR4 OK/ERROR ...",
    // Passwort nie im Log. serialReply() darf kurz warten, sonst sind USB-Ausgaben nicht blockierend.

    // Setup via USB (flashESP, setTime), line by line: "UHR4 WIFI <name hex> <password hex>", "UHR4 DISPLAY
    // <name>", "UHR4 RESTART", "UHR4 INFO", "UHR4 TIME <Unix sec>" - reply "UHR4 OK/ERROR ...", password
    // never logged. serialReply() may wait briefly, otherwise USB output is non-blocking.

    void serialReply(const String& reply) {
#if ARDUINO_USB_CDC_ON_BOOT
        Serial.setTxTimeoutMs(250);
#endif
        Serial.println(reply);
        Serial.flush();
#if ARDUINO_USB_CDC_ON_BOOT
        Serial.setTxTimeoutMs(0);
#endif
    }

    // Neustart erst nach 1 s: das Skript schliesst die Schnittstelle nach der
    // Antwort sofort - verschwindet die Uhr vorher vom USB, kann das Schliessen
    // unter Windows haengen und die Schnittstelle offen halten.

    // Restart only after 1 s: the script closes the port right after the reply
    // - if the clock vanishes from USB before that, closing can hang on
    // Windows and keep the port open.

    void serialRestart(const String& reply) {
        serialReply(reply);
        delay(1000);
        espReboot();
    }

    // "UHR4 OPENWIFI" (Diagnose): holt die Uhrzeit wie beim Start aus einem offenen WLAN (Schritte im Log), danach Neustart.
    // Gespeicherte WLANs bleiben unberuehrt. Die Antwort kommt sofort, der Test dauert bis zu mehreren Minuten.

    // "UHR4 OPENWIFI" (diagnostic): gets the time from an open WiFi like at boot (steps in the log), then restarts.
    // Stored WiFis stay untouched. The reply comes right away, the test takes up to several minutes.

    void handleSerialOpenWifi() {
        serialReply("UHR4 OK OPENWIFI started");

        // Ohne Auto-Verbindung, sonst verbindet die Uhr sich sofort wieder und der Scan scheitert
        // Without auto-connect, otherwise the clock reconnects right away and the scan fails

        WiFi.setAutoReconnect(false);
        WiFi.disconnect();
        delay(500);
        WiFi.mode(WIFI_STA);
        applyWifiTxPower();
        int found = WiFi.scanNetworks();
        if (found < 0) {
            delay(1000);
            found = WiFi.scanNetworks();
        }
        DEBUG_PRINTLN("[OPEN-WIFI] Scan: " + String(found) + " networks");
        collectStrongestNetworks(found < 0 ? 0 : found);
        WiFi.scanDelete();
        bool ok = fetchTimeFromOpenWifi(true);
        serialRestart(ok ? "UHR4 OK OPENWIFI time set" : "UHR4 OK OPENWIFI no time");
    }

    void handleSerialWifi(const String& args) {
        int sep = args.indexOf(' ');
        String ssid, pass;
        bool ok = sep > 0 &&
                  hexToText(args.substring(0, sep), ssid, 32) &&
                  hexToText(args.substring(sep + 1), pass, 63);
        if (!ok || ssid.length() == 0 || (pass.length() > 0 && pass.length() < 8)) {
            backupWipe(pass);
            serialReply("UHR4 ERROR WIFI invalid (name 1-32 bytes, password empty or 8-63 bytes)");
            return;
        }
        int slot = saveWpsCredentials(ssid, pass);
        preferences.putInt(PK_LAST_WLAN, slot);
        preferences.putBool(PK_WIFI_ACTIVE, true);
        wifiActive = true;
        backupWipe(pass);
        serialReply("UHR4 OK WIFI");
    }

    // "UHR4 INFO" -> "UHR4 OK INFO <Name> <gesetzt>": eingestellter Displaytyp und ob er je gespeichert wurde
    // (1) oder nur der Standard gilt (0). flashESP fragt das vor dem Flashen ab und waehlt den Typ vor. Liest
    // nur.

    // "UHR4 INFO" -> "UHR4 OK INFO <name> <set>": configured display type and whether it was ever stored (1)
    // or only the default applies (0). flashESP queries this before flashing and preselects the type.
    // Read-only.

    void handleSerialInfo() {
        bool backlight = preferences.getBool(PK_USE_BACKLIGHT, DISPLAY_GEOMETRY[displayType].backlightDefault);
        serialReply(String("UHR4 OK INFO ") + displayChoiceName(displayType, backlight) + " " + String(preferences.isKey(PK_DISPLAY_TYPE) ? 1 : 0));
    }

    void handleSerialDisplay(const String& name) {
        uint8_t type;
        bool backlight;
        if (!parseDisplayName(name, type, backlight)) {
            serialReply("UHR4 ERROR DISPLAY unknown '" + name + "' (" + supportedDisplayNames() + ")");
            return;
        }

        // Gespeicherten Wert vergleichen - der Befehl kann auch waehrend
        // setup() kommen, bevor useBacklight geladen ist.

        // Compare the stored value - the command may also arrive during
        // setup(), before useBacklight is loaded.

        bool storedBacklight = preferences.getBool(PK_USE_BACKLIGHT, DISPLAY_GEOMETRY[displayType].backlightDefault);
        if (type == displayType && backlight == storedBacklight) {
            serialReply("UHR4 OK DISPLAY " + name + " UNCHANGED");
            return;
        }
        setDisplayType(type, backlight);
        serialRestart("UHR4 OK DISPLAY " + name + " RESTART");
    }

#if ARDUINO_USB_CDC_ON_BOOT && !ARDUINO_USB_MODE
#include <esp32-hal-tinyusb.h> // usb_persist_restart()
    // 1200 Baud = Wunsch nach dem Download-Modus (wie Arduino IDE, port.ps1,
    // flashESP.sh). Ersetzt die im Core abgeschaltete Umschaltung
    // (Serial.enableReboot(false) in setup()), ohne deren DTR/RTS-Folge.
    // 1200 baud = request for download mode (like the Arduino IDE, port.ps1,
    // flashESP.sh). Replaces the switch disabled in the core
    // (Serial.enableReboot(false) in setup()), without its DTR/RTS sequence.
    void usbCdcLineCodingEvent(void* arg, esp_event_base_t base, int32_t id, void* data) {
        arduino_usb_cdc_event_data_t* e = (arduino_usb_cdc_event_data_t*)data;
        if (e && e->line_coding.bit_rate == 1200) {
            usb_persist_restart(RESTART_BOOTLOADER);
        }
    }
#endif

    void handleSerialCommands() {
        static String line;
        while (Serial.available()) {
            char c = (char)Serial.read();
            if (c == '\r') continue;
            if (c != '\n') {
                if (line.length() < 256) line += c;
                continue;
            }
            String cmd = line;
            backupWipe(line); // kann WLAN-Daten enthalten / may contain WiFi data
            cmd.trim();
            if (cmd.startsWith("UHR4 WIFI ")) {
                handleSerialWifi(cmd.substring(10));
            }
            else if (cmd.startsWith("UHR4 DISPLAY ")) {
                String name = cmd.substring(13);
                name.trim();
                handleSerialDisplay(name);
            }
            else if (cmd == "UHR4 RESTART") {
                serialRestart("UHR4 OK RESTART");
            }
            else if (cmd == "UHR4 INFO") {
                handleSerialInfo();
            }
            else if (cmd == "UHR4 OPENWIFI") {
                handleSerialOpenWifi();
            }
            else if (cmd == "UHR4 PINS") {

                // Diagnose: Pegel von Taster (gedrueckt = HIGH) und Boot-Taste (gedrueckt = LOW), liest nur
                // Diagnostics: level of the button (pressed = HIGH) and the boot button (pressed = LOW), read-only

                serialReply("UHR4 OK PINS BUTTON" + String(BUTTON1) + "=" + String(digitalRead(BUTTON1)) +
                            " BOOT" + String(BOOT_BUTTON) + "=" + String(digitalRead(BOOT_BUTTON)));
            }
            else if (cmd.startsWith("UHR4 TIME ")) {
                String arg = cmd.substring(10);
                arg.trim();
                handleSerialTime(arg);
            }
            backupWipe(cmd);
        }
    }


    // Rotation, die tatsaechlich am Chip (MADCTL) eingestellt wird: bei
    // Software-Rotation (GC9D01) immer 0, sonst effectiveRotation().

    // Rotation actually set on the chip (MADCTL): always 0 with software
    // rotation (GC9D01), otherwise effectiveRotation().

    uint8_t hardwareRotation(uint8_t displayNum) {
        return gc9d01SwRotation ? 0 : effectiveRotation(displayNum);
    }


    // Legt ein 16-Bit-Sprite an, standardmaessig im PSRAM - auch die Zeiger, da interner RAM knapp ist
    // (intern fiel der freie Heap auf 5 KB). Klappt es dort nicht, zweiter Versuch im anderen Speicher.
    // swapBytes fuer RGB565 aus dem RAM.

    // Creates a 16-bit sprite, by default in PSRAM - the hands too, since internal RAM is scarce (internally
    // the free heap dropped to 5 KB). If that fails, a second attempt in the other memory. swapBytes for
    // RGB565 from RAM.

    bool createSprite16(LGFX_Sprite& sprite, int32_t w, int32_t h, bool preferPsram) {
        sprite.setColorDepth(16);
        sprite.setSwapBytes(true);
        bool first = preferPsram && psramFound();
        sprite.setPsram(first);
        if (sprite.createSprite(w, h) != nullptr) return true;
        if (!psramFound()) return false;
        sprite.setPsram(!first);
        return sprite.createSprite(w, h) != nullptr;
    }


    // Textdarstellung fuer Display und Status-Sprites: GLCD-Schrift als CP437-Zeichensatz, ohne
    // UTF-8-Dekodierung - Umlaute und Akzente kommen ueber tftText() als einzelne CP437-Bytes.

    // Text rendering for the display and status sprites: GLCD font as the CP437 charset, without UTF-8
    // decoding - umlauts and accents arrive via tftText() as single CP437 bytes.

    void setupTextStyle(lgfx::LovyanGFX& gfx) {
        gfx.setFont(&fonts::Font0);
        gfx.setAttribute(lgfx::utf8_switch, false);
        gfx.setAttribute(lgfx::cp437_switch, true);
    }


    // Text fuers Display umwandeln: HTML-Entities (&uuml; ...) und UTF-8 (z.B. SSIDs) werden zu CP437-Bytes
    // der GLCD-Schrift, Unbekanntes zu '?'.

    // Convert text for the display: HTML entities (&uuml; ...) and UTF-8 (e.g. SSIDs) become CP437 bytes of
    // the GLCD font, anything unknown becomes '?'.

    String tftText(const String& text) {
        struct Cp437Map { uint16_t unicode; const char* entity; char cp437; };
        static const Cp437Map cp437Table[] = {
            { 0x00E4, "auml",   (char)0x84 }, { 0x00F6, "ouml",   (char)0x94 }, { 0x00FC, "uuml",   (char)0x81 },
            { 0x00C4, "Auml",   (char)0x8E }, { 0x00D6, "Ouml",   (char)0x99 }, { 0x00DC, "Uuml",   (char)0x9A },
            { 0x00DF, "szlig",  (char)0xE1 }, { 0x00E9, "eacute", (char)0x82 }, { 0x00C9, "Eacute", (char)0x90 },
            { 0x00E8, "egrave", (char)0x8A }, { 0x00EA, "ecirc",  (char)0x88 }, { 0x00EB, "euml",   (char)0x89 },
            { 0x00E0, "agrave", (char)0x85 }, { 0x00E2, "acirc",  (char)0x83 }, { 0x00E7, "ccedil", (char)0x87 },
            { 0x00EE, "icirc",  (char)0x8C }, { 0x00EF, "iuml",   (char)0x8B }, { 0x00F4, "ocirc",  (char)0x93 },
            { 0x00FB, "ucirc",  (char)0x96 }, { 0x00F9, "ugrave", (char)0x97 }, { 0x00C7, "Ccedil", (char)0x80 },
            { 0x00B0, "deg",    (char)0xF8 }, { 0x00A0, "nbsp",   ' ' },        { 0x0026, "amp",    '&' },
            { 0x0027, "#39",    '\'' },       { 0x0022, "quot",   '"' },        { 0x003C, "lt",     '<' },
            { 0x003E, "gt",     '>' },
        };

        String out;
        out.reserve(text.length());
        const char* s = text.c_str();
        size_t i = 0;
        const size_t len = text.length();

        while (i < len) {
            uint8_t c = (uint8_t)s[i];

            if (c == '&') {
                int semi = text.indexOf(';', i + 1);
                if (semi > (int)i + 1 && semi - (int)i <= 8) {
                    String name = text.substring(i + 1, semi);
                    bool found = false;
                    for (const auto& m : cp437Table) {
                        if (name == m.entity) { out += m.cp437; found = true; break; }
                    }
                    if (found) { i = semi + 1; continue; }
                }
                out += '&';
                i++;
                continue;
            }

            if (c < 0x80) { out += (char)c; i++; continue; }

            // UTF-8-Folge dekodieren (2 oder 3 Byte reichen fuer Latin-1)
            // Decode a UTF-8 sequence (2 or 3 bytes cover Latin-1)

            uint32_t cp = 0;
            size_t n = 0;
            if ((c & 0xE0) == 0xC0) { cp = c & 0x1F; n = 1; }
            else if ((c & 0xF0) == 0xE0) { cp = c & 0x0F; n = 2; }
            else if ((c & 0xF8) == 0xF0) { cp = c & 0x07; n = 3; }
            else { out += '?'; i++; continue; }
            if (i + n >= len) { out += '?'; break; } // abgeschnittene Folge
                                                     // truncated sequence
            for (size_t k = 1; k <= n; k++) cp = (cp << 6) | ((uint8_t)s[i + k] & 0x3F);
            i += n + 1;

            char mapped = '?';
            for (const auto& m : cp437Table) {
                if (m.unicode == cp) { mapped = m.cp437; break; }
            }
            out += mapped;
        }
        return out;
    }




    // Waehlt Display 1 und schaltet beide CS-Pins selbst (LovyanGFX fuehrt keinen, pin_cs = -1). Vorher die
    // laufende Uebertragung abwarten; setRotation() stellt MADCTL fuer diesen Chip und verwirft das gemerkte
    // Adressfenster.

    // Selects display 1 and drives both CS pins itself (LovyanGFX drives none, pin_cs = -1). Wait for the
    // running transfer first; setRotation() sets MADCTL for this chip and discards the cached address window.

    void setCS1(bool state) {
        if (state == LOW) {
            if (tftInitialized) tft.waitDMA();
            if (LGFX_CS_PIN < 0) digitalWrite(CS_1, LOW); // sonst schaltet LovyanGFX CS / otherwise LovyanGFX drives CS
            if (HAS_DISPLAY2) digitalWrite(CS_2, HIGH);
            if (tftInitialized) tft.setRotation(hardwareRotation(1));
        }

    }


    // Waehlt Display 2 bei Dual-Display-Aufbauten ueber seinen Chip-Select-Pin aus
    // (deaktiviert dabei Display 1, siehe Kommentar bei setCS1())

    // Selects Display 2 via its chip-select pin in dual-display setups
    // (disables Display 1, see comment on setCS1())

    void setCS2(bool state) {
        if (state == LOW && HAS_DISPLAY2) {
            if (tftInitialized) tft.waitDMA();
            digitalWrite(CS_2, LOW);
            digitalWrite(CS_1, HIGH);
            if (tftInitialized) tft.setRotation(hardwareRotation(2));
        }

    }


    // Ruhezustand nach dem Zeichnen: selektiert das erste angeschlossene Display,
    // damit ein "n.a."-Display ausserhalb von Status-/Startmeldungen nicht selektiert bleibt.

    // Idle state after drawing: selects the first connected display, so a "n.a."
    // display doesn't stay selected outside of status/boot messages.

    void setCSIdle() {
        if (isDisplayConnected(1) || !isDisplayConnected(2)) setCS1(LOW); else setCS2(LOW);
    }


    // Bereitet Status-/Boot-Text vor: Hardware-Rotation zeichnet direkt auf 'tft',
    // Software-Rotation kann Text nicht drehen und zeichnet daher immer unrotiert
    // in ein persistentes Sprite - Drehung folgt erst in endStatusDraw().

    // Prepares status/boot text: hardware rotation draws straight to 'tft',
    // software rotation can't rotate text and always draws unrotated into a
    // persistent sprite instead - rotation happens only in endStatusDraw().

    // Schmales Display mit Streifen (ST7789 172x320): Meldungen quer, 90 Grad weiter gedreht - so passt die doppelt
    // grosse Schrift in die Zeilen (320 statt 172 px breit), die Hoehe bleibt 172 wie der Uhrbereich.

    // Narrow display with a strip (ST7789 172x320): messages in landscape, rotated 90 degrees further - so the
    // double-size font fits the lines (320 instead of 172 px wide), the height stays 172 like the clock area.

    bool statusLandscape() {
        return displayType == DISPLAY_TYPE_ST7789;
    }

    // Breite des Bereichs fuer Meldungen: quer die Panelhoehe, sonst der Uhrbereich
    // Width of the area for messages: in landscape the panel height, otherwise the clock area

    int statusWidth() {
        return statusLandscape() ? TFT_HEIGHT : CLOCK_WIDTH;
    }

    lgfx::LovyanGFX& beginStatusDraw(uint8_t displayNum) {
        bool clockShown = !clockFrameDirty[displayNum - 1]; // bisher Uhrbild auf dem Display / clock image shown so far
        displayNeedsBlank[displayNum - 1] = true; // Meldung auf dem Display - ein "n.a."-Display muss spaeter wieder schwarz werden
                                                  // message on the display - a "n.a." display has to go black again later
        clockFrameDirty[displayNum - 1] = true;   // Uhrbild ist ueberzeichnet - naechster Frame voll senden
                                                  // clock image got drawn over - send the next frame in full
        bool stripShown = !infoStripDirty[displayNum - 1];
        infoStripDirty[displayNum - 1] = true;    // Streifen fuer Uhrzeit/Datum ebenso (nur ILI9341)
                                                  // the time/date strip as well (ILI9341 only)
        LGFX_Sprite& sprite = (displayNum == 1) ? statusSprite1 : statusSprite2;
        bool& created = (displayNum == 1) ? statusSprite1Created : statusSprite2Created;

        if (gc9d01SwRotation && !created) {

            // Schlaegt die Allokation fehl, bleibt 'created' false und es wird
            // unten unrotiert direkt auf den Chip gezeichnet statt ins Nichts.

            // If allocation fails, 'created' stays false and drawing falls
            // through to the direct-to-chip path below, unrotated but readable.

            if (createSprite16(sprite, CLOCK_WIDTH, CLOCK_HEIGHT)) {
                setupTextStyle(sprite);
                sprite.fillSprite(TFT_BLACK);
                created = true;
            }
            else {
                DEBUG_PRINTLN("[Display] Error: couldnt allocate statusSprite - status text stays unrotated");
            }
        }

        if (!gc9d01SwRotation || !created) {
            if (displayNum == 1) setCS1(LOW); else setCS2(LOW);

            // Displays mit Streifen vor der ersten Meldung einmal ganz loeschen - Meldungen stehen oben links im
            // Uhrbereich, sonst blieben Streifen und (liegt der Streifen oben) Teile der Uhr eingefroren stehen.

            // Clear displays with a strip completely once before the first message - messages sit top left in the
            // clock area, otherwise the strip and (with the strip on top) parts of the clock would stay frozen.

            int x, y, w, h;
            bool landscape;
            if (stripShown && infoStripRect(displayNum, x, y, w, h, landscape)) tft.fillScreen(TFT_BLACK);

            // Quer: setCS1()/setCS2() setzen beim naechsten Uhrbild wieder die normale Lage. Beim Wechsel vom
            // Uhrbild ganz loeschen, sonst blieben Teile der hochkant gezeichneten Uhr stehen.

            // Landscape: setCS1()/setCS2() restore the normal orientation with the next clock frame. Clear
            // completely when switching from the clock image, otherwise parts of the portrait clock would remain.

            if (statusLandscape()) {
                tft.setRotation((hardwareRotation(displayNum) + 1) % 4);
                if (clockShown || stripShown) tft.fillScreen(TFT_BLACK);
            }
            return tft;
        }

        // Bewusst KEIN sprite.setRotation() (siehe Kommentar oben) - das
        // Sprite bleibt immer in seiner unrotierten 0-Grad-Ausgangslage,
        // die Drehung erfolgt erst in endStatusDraw().

        // Deliberately NO sprite.setRotation() (see comment above) - the
        // sprite always stays in its unrotated 0-degree starting state,
        // rotation happens only in endStatusDraw().

        return sprite;
    }


    // Sendet das vorbereitete Sprite ans Display (No-Op bei Hardware-Rotation,
    // da dort schon direkt gezeichnet wurde). Ohne Drehung en bloc uebertragen,
    // sonst zeilenweise wie in loadClockFace(); teilt sich rowBuffer mit ihr.

    // Sends the prepared sprite to the display (no-op with hardware rotation,
    // which already drew directly). Transferred in one go without rotation,
    // otherwise row by row like loadClockFace(); shares its rowBuffer.

    void endStatusDraw(uint8_t displayNum) {

        // Auch das fehlgeschlagene Sprite-Anlegen abfangen (siehe
        // beginStatusDraw()): dann wurde bereits direkt auf den Chip gezeichnet
        // und es gibt nichts zu uebertragen.

        // Also catch a failed sprite allocation (see beginStatusDraw()): in that
        // case drawing already went straight to the chip and there is nothing to
        // transfer.

        bool created = (displayNum == 1) ? statusSprite1Created : statusSprite2Created;
        if (!gc9d01SwRotation || !created) return;

        LGFX_Sprite& sprite = (displayNum == 1) ? statusSprite1 : statusSprite2;
        uint8_t rotation = effectiveRotation(displayNum);
        if (displayNum == 1) setCS1(LOW); else setCS2(LOW);

        if (rotation == 0) {
            sprite.pushSprite(0, 0);
            return;
        }

        // pushImage() sendet Bytes wie im RAM (little-endian), das Display
        // erwartet die andere Reihenfolge - ohne setSwapBytes(true) kommen
        // Farben vertauscht an (z.B. Gruen 0x07E0 wird zu 0xE007).

        // pushImage() sends bytes as they sit in RAM (little-endian), but the
        // display expects the other byte order - without setSwapBytes(true)
        // colors arrive swapped (e.g. green 0x07E0 becomes 0xE007).

        tft.setSwapBytes(true);

        const int N = CLOCK_WIDTH;
        for (int y = 0; y < N; y++) {
            for (int x = 0; x < N; x++) {
                int srcX, srcY;
                switch (rotation) {
                    case 1:  srcX = y;         srcY = N - 1 - x; break; // 90 Grad im Uhrzeigersinn
                                                                        // 90 degrees clockwise
                    case 2:  srcX = N - 1 - x; srcY = N - 1 - y; break; // 180 Grad
                                                                        // 180 degrees
                    default: srcX = N - 1 - y; srcY = x;         break; // 270 Grad im Uhrzeigersinn
                                                                        // 270 degrees clockwise
                }
                rowBuffer[x] = sprite.readPixel(srcX, srcY);
            }
            tft.pushImage(0, y, N, 1, rowBuffer);
        }

        // Zustand zuruecksetzen - 'tft' wird an anderer Stelle (Text ueber
        // Hardware-Rotation, updateClock() usw.) mit swapBytes=false erwartet.

        // Reset the state - 'tft' is expected to have swapBytes=false
        // elsewhere (text via hardware rotation, updateClock(), etc.).

        tft.setSwapBytes(false);
    }


    // Uebernimmt eine neue Rotation (0-3 oder TFT_ROTATION_NA) fuer Display 1 oder 2:
    // speichert sie und wendet sie bei Hardware-Rotation sofort am Chip an.
    // Bei "n.a." bekommt der Chip 0 Grad (effectiveRotation()), nie den Wert 4 (waere beim GC9A01 gespiegelt).

    // Applies a new rotation (0-3 or TFT_ROTATION_NA) for display 1 or 2:
    // stores it and, with hardware rotation, applies it on the chip right away.
    // For "n.a." the chip gets 0 degrees (effectiveRotation()), never the value 4 (mirrored on the GC9A01).

    void applyDisplayRotation(uint8_t displayNum, uint8_t newRotation) {
        uint8_t& rotation = (displayNum == 1) ? tftRotation1 : tftRotation2;
        bool& firstRunFlag = (displayNum == 1) ? firstRun : firstRun2;

        // firstRun nur bei tatsaechlicher Aenderung zuruecksetzen, sonst
        // startet jedes Speichern die Bahnhofsmodus-Wartephase neu.

        // Only reset firstRun on an actual change, otherwise every save
        // restarts the station-mode wait phase.

        bool changed = rotation != newRotation;
        if (changed) {
            firstRunFlag = true;
            clockFrameDirty[displayNum - 1] = true; // auch im Spiegelbetrieb (Display 2 ohne eigenes Rendern) neu senden
                                                    // resend in mirror mode too (display 2 without its own rendering)
            if (newRotation == TFT_ROTATION_NA) displayNeedsBlank[displayNum - 1] = true; // letztes Uhrbild muss weg
                                                                                          // last clock image has to go
        }
        rotation = newRotation;
        preferences.putUChar((displayNum == 1) ? PK_TFT_ROTATION1 : PK_TFT_ROTATION2, rotation);

        if (changed || !gc9d01SwRotation) {

            // setCS1()/setCS2() setzen die neue Rotation am gewaehlten Chip (hardwareRotation()). Bei einer
            // Aenderung das Display einmal schwarz loeschen - sonst blieben Reste der alten Lage stehen (beim
            // ILI9341 z.B. der Streifen mit Uhrzeit/Datum).

            // setCS1()/setCS2() set the new rotation on the selected chip (hardwareRotation()). On a change,
            // clear the display to black once - otherwise remains of the old orientation would stay (on the
            // ILI9341 e.g. the time/date strip).

            if (displayNum == 1) setCS1(LOW); else setCS2(LOW);
            if (changed) {
                tft.fillScreen(TFT_BLACK);
                infoStripDirty[displayNum - 1] = true;
            }
            setCSIdle(); // zurueck auf den Ausgangszustand, damit loop() im gewohnten Zustand weiterlaeuft
                         // back to the initial state, so loop() continues from its usual state
        }
    }


    // Werksvorgaben fuer min. Helligkeit und Schwellwerte: mit Backlight dimmt die PWM fast bis 0 stufenlos;
    // ohne werden die Pixel abgedunkelt, unter ~100 wird das Zifferblatt unleserlich.

    // Factory defaults for min. brightness and thresholds: with a backlight the PWM dims steplessly almost to
    // 0; without one the pixels are darkened, below ~100 the clock face becomes unreadable.

    void putBrightnessDefaults(bool backlight) {
        preferences.putUChar(PK_MIN_BRIGHTNESS, backlight ? 5 : 100);
        preferences.putInt(PK_LOW_THRESHOLD, backlight ? 1 : 40);
        preferences.putInt(PK_HIGH_THRESHOLD, backlight ? 100 : 60); // 100 statt frueher 255: das Formularfeld erlaubt nur 0-100, der
                                                                     // Lichtwert (5-100 %) ueberschreitet 100 ohnehin nie - gleiche Wirkung
                                                                     // 100 instead of the former 255: the form field only allows 0-100, the
                                                                     // light value (5-100 %) never exceeds 100 anyway - same effect
    }


    // Automatische Helligkeit ein-/ausschalten, samt Versorgungspins des Spannungsteilers - sonst bliebe der
    // Teiler nach spaeterem Einschalten (Formular, Preset) bis zum Neustart ohne Spannung.

    // Switch automatic brightness on/off, including the voltage divider's supply pins - otherwise the divider
    // would stay unpowered until the next restart after enabling it later (form, preset).

    void setAutoBrightness(bool enabled) {
        enabled = enabled && photoresistorFound;
        if (enabled) {
            pinMode(ADC_GND, OUTPUT);
            pinMode(ADC_3V, OUTPUT);
            digitalWrite(ADC_GND, LOW);
            digitalWrite(ADC_3V, HIGH);
        }
        else {
            pinMode(ADC_GND, INPUT);
            pinMode(ADC_3V, INPUT);
        }
        useAdc = enabled;
        preferences.putBool(PK_USE_ADC, useAdc);
    }


    // Helligkeitswert aus einem Preset (/api/setMode) uebernehmen, begrenzen und speichern. false = kein
    // Helligkeits-Schluessel; wirkt beim naechsten updateBrightness().

    // Take over, clamp and store a brightness value from a preset (/api/setMode). false = not a brightness key;
    // takes effect on the next updateBrightness().

    bool applyBrightnessPresetValue(const String& key, const String& value) {
        if (key == "minBrightness") {
            minBrightness = (uint8_t)constrain(value.toInt(), 0, 255);
            preferences.putUChar(PK_MIN_BRIGHTNESS, minBrightness);
        }
        else if (key == "maxBrightness") {
            maxBrightness = (uint8_t)constrain(value.toInt(), 0, 255);
            preferences.putUChar(PK_MAX_BRIGHTNESS, maxBrightness);
        }
        else if (key == "brightStart") {
            brightStartHour = (uint8_t)constrain(value.toInt(), 0, 23);
            preferences.putUChar(PK_BRIGHT_START_HOUR, brightStartHour);
        }
        else if (key == "brightEnd") {
            brightEndHour = (uint8_t)constrain(value.toInt(), 0, 23);
            preferences.putUChar(PK_BRIGHT_END_HOUR, brightEndHour);
        }
        else if (key == "lowThreshold") {
            lowThreshold = constrain(value.toInt(), 0, 100);
            preferences.putInt(PK_LOW_THRESHOLD, lowThreshold);
        }
        else if (key == "highThreshold") {
            highThreshold = constrain(value.toInt(), 0, 100);
            preferences.putInt(PK_HIGH_THRESHOLD, highThreshold);
        }
        else if (key == "gamma") {
            gammaBrightness = constrain(value.toFloat(), 0.1f, 3.0f);
            preferences.putFloat(PK_GAMMA_BRIGHTNESS, gammaBrightness);
        }
        else if (key == "autoBrightness") {
            setAutoBrightness(value == "1" || value.equalsIgnoreCase("true"));
        }
        else {
            return false;
        }
        return true;
    }


    // TFT_Backlight passend zu useBacklight: an = PWM mit aktueller Helligkeit, aus = fest HIGH (volle
    // Beleuchtung). HIGH auch beim Start - ein offener BL-Eingang bliebe sonst je nach Modul dunkel.

    // TFT_Backlight according to useBacklight: on = PWM with the current brightness, off = HIGH (full backlight).
    // HIGH at boot too - a floating BL input would otherwise stay dark on some modules.

    void applyBacklightPin() {
        if (useBacklight) {
            if (!backlightAttached) {
                backlightAttached = ledcAttach(TFT_Backlight, BACKLIGHT_FREQ, BACKLIGHT_RESOLUTION);
                if (!backlightAttached) DEBUG_PRINTLN("[Display] Error: couldnt attach backlight PWM");
            }
            if (backlightAttached) ledcWrite(TFT_Backlight, currentBrightness);
            return;
        }
        if (backlightAttached) {
            ledcDetach(TFT_Backlight);
            backlightAttached = false;
        }
        pinMode(TFT_Backlight, OUTPUT);
        digitalWrite(TFT_Backlight, HIGH);
    }


    // Umschalten zur Laufzeit (Weboberflaeche): speichert die Einstellung,
    // setzt min. Helligkeit/Schwellwerte auf die passenden Werksvorgaben und
    // faerbt Zifferblatt und Zeiger neu ein (mit Backlight unverdunkelt).

    // Switching at runtime (web UI): stores the setting, resets min.
    // brightness/thresholds to the matching factory defaults and re-tints
    // the clock face and hands (undimmed with a backlight).

    void setBacklightMode(bool enabled) {
        if (enabled == useBacklight) return;
        useBacklight = enabled;
        preferences.putBool(PK_USE_BACKLIGHT, enabled);

        putBrightnessDefaults(enabled);
        minBrightness = preferences.getUChar(PK_MIN_BRIGHTNESS, 100);
        lowThreshold = preferences.getInt(PK_LOW_THRESHOLD, 40);
        highThreshold = preferences.getInt(PK_HIGH_THRESHOLD, 60);

        DEBUG_PRINTLN(String("[Display] Backlight ") + (enabled ? "on" : "off"));

        // Erst Pin umstellen und die Helligkeit neu berechnen, DANN neu einfaerben (sonst blitzte der
        // niedrige PWM-Wert als Abdunklung auf). Mit max. Helligkeit neu beginnen, sonst bliebe der Zielwert
        // des alten Verfahrens stehen.

        // Switch the pin and recompute brightness first, THEN re-tint (otherwise the low PWM value would
        // flash as dimming). Restart from max. brightness, otherwise the old method's target value would
        // stick.

        targetBrightness = maxBrightness;
        currentBrightness = maxBrightness;

        applyBacklightPin();
        updateBrightness();
        freeClockFaceBuffer();
        loadClockFace();
        loadHandSprites();
        lastHandBrightness = currentBrightness; // Zeiger sind eben mit diesem Wert eingefaerbt
                                                // hands were just tinted with this value
        updateClock();
    }


    // Passt die Helligkeit eines Pixels basierend auf der aktuellen Helligkeitseinstellung an.
    // Adjusts a pixel's brightness based on the current brightness setting.

    uint16_t setPixelBrightness(uint16_t pixel) {

        // Mit Hintergrundbeleuchtung regelt die PWM auf TFT_Backlight die
        // Helligkeit (updateBrightness()) - die Pixel bleiben unveraendert.

        // With a backlight the PWM on TFT_Backlight controls brightness
        // (updateBrightness()) - pixels stay unchanged.

        if (useBacklight) return pixel;

        // Wenn die Helligkeit maximal ist oder der Pixel transparent/schwarz ist, direkt zurückgeben
        // If brightness is at maximum or the pixel is transparent/black, return immediately

        if (pixel == TRANSPARENT_COLOR || pixel == 0x0000 || currentBrightness == 255) {
            return pixel;
        }

        // Multiplikator einmal berechnen (statt 3x Division)
        // Compute the multiplier once (instead of 3x division)

        uint32_t brightnessFactor = (uint32_t)currentBrightness;

        // Farben extrahieren
        // Extract colors

        uint32_t r = (pixel & 0xF800);
        uint32_t g = (pixel & 0x07E0);
        uint32_t b = (pixel & 0x001F);

        // Multiplikation mit Brightness (optimiert, kein Shift nötig)
        // Multiply by brightness (optimized, no shift needed)

        r = ((r * brightnessFactor) >> 8) & 0xF800;
        g = ((g * brightnessFactor) >> 8) & 0x07E0;
        b = ((b * brightnessFactor) >> 8) & 0x001F;

        // Farbwerte zusammenfügen; gedimmtes Reingrün kann genau TRANSPARENT_COLOR ergeben und würde sonst verschwinden
        // Combine color values; dimmed pure green can hit exactly TRANSPARENT_COLOR and would otherwise vanish

        uint16_t result = r | g | b;
        return (result == TRANSPARENT_COLOR) ? 0x0100 : result;
    }


    // RLE-Kompression fuer Zifferblatt-BMPs (face_*.bmp): eigenes PackBits-artiges Verfahren fuer 16-Bit RGB565, Worst-Case-Overhead nur ~0.4%.
    // Datei beginnt mit Magic "RLEB" statt "BM" (kein gueltiges BMP mehr) + Breite/Hoehe/Groessen (je int32/uint32) + RLE-Datenstrom.
    // Steuerbyte je Paket: 0-127=Literal-Lauf (C+1 Pixel roh), 129-255=Wiederholung ((257-C) identische Pixel, nur 1x gespeichert), 128=unbenutzt.

    // RLE compression for clock-face BMPs (face_*.bmp): custom PackBits-style scheme for 16-bit RGB565, worst-case overhead only ~0.4%.
    // File starts with magic "RLEB" instead of "BM" (no longer a valid BMP) + width/height/sizes (int32/uint32 each) + RLE data stream.
    // Control byte per packet: 0-127=literal run (C+1 raw pixels), 129-255=repeat ((257-C) identical pixels, stored once), 128=unused.

    bool isRleFace(const uint8_t* header4) {
        return header4[0] == 'R' && header4[1] == 'L' && header4[2] == 'E' && header4[3] == 'B';
    }


    // Obergrenze fuer die kodierte Groesse (fuer die Allokation des Zielpuffers).
    // Upper bound for the encoded size (for allocating the destination buffer).

    size_t rleMaxEncodedSize(size_t pixelCount) {
        return pixelCount * 2 + (pixelCount / 128 + 2);
    }


    // Kodiert ein Array von RGB565-Pixeln PackBits-artig (Lauflaengenkodierung);
    // gibt die Anzahl tatsaechlich geschriebener Bytes in 'out' zurueck

    // Encodes an array of RGB565 pixels PackBits-style (run-length encoding);
    // returns the number of bytes actually written to 'out'

    size_t rleEncode565(const uint16_t* pixels, size_t count, uint8_t* out) {
        size_t i = 0, o = 0;
        while (i < count) {
            if (i % 5000 == 0) yield(); // Watchdog-Reset vermeiden bei grossen Bildern
                                        // avoid watchdog reset on large images
            size_t runLen = 1;
            while (i + runLen < count && runLen < 128 && pixels[i + runLen] == pixels[i]) runLen++;

            if (runLen >= 2) {
                out[o++] = (uint8_t)(257 - runLen);
                out[o++] = pixels[i] & 0xFF;
                out[o++] = pixels[i] >> 8;
                i += runLen;
            }
            else {
                size_t litStart = i;
                size_t litLen = 0;
                while (i < count && litLen < 128) {
                    size_t rl = 1;
                    while (i + rl < count && rl < 128 && pixels[i + rl] == pixels[i]) rl++;
                    if (rl >= 2) break;
                    litLen++;
                    i++;
                }
                out[o++] = (uint8_t)(litLen - 1);
                for (size_t k = 0; k < litLen; k++) {
                    uint16_t px = pixels[litStart + k];
                    out[o++] = px & 0xFF;
                    out[o++] = px >> 8;
                }
            }
        }
        return o;
    }


    // Dekodiert einen mit rleEncode565() erzeugten Datenstrom vollstaendig in ein
    // bereits vorhandenes uint16_t-Pixel-Array (RGB565)

    // Fully decodes a stream produced by rleEncode565() into an
    // already-allocated uint16_t pixel array (RGB565)

    void rleDecode565(const uint8_t* in, size_t inSize, uint16_t* out, size_t outCount) {
        size_t i = 0, o = 0;
        while (i < inSize && o < outCount) {
            if (o % 5000 == 0) yield(); // Watchdog-Reset vermeiden bei grossen Bildern
                                        // avoid watchdog reset on large images
            uint8_t ctrl = in[i++];
            if (ctrl <= 127) {
                size_t len = ctrl + 1;
                for (size_t k = 0; k < len && o < outCount && i + 1 < inSize; k++) {
                    uint16_t px = in[i] | (in[i + 1] << 8);
                    i += 2;
                    out[o++] = px;
                }
            }
            else {
                size_t len = 257 - ctrl;
                if (i + 1 >= inSize) break;
                uint16_t px = in[i] | (in[i + 1] << 8);
                i += 2;
                for (size_t k = 0; k < len && o < outCount; k++) out[o++] = px;
            }
        }
    }


    // Ziffern der erzeugten Zifferblaetter: nur 12/3/6/9 (face_default), 1-12, I-XII und 12/3/9 mit Sekundenfeld
    // statt der 6 (face_subdial). Sekundenfeld: Mitte bei SUBDIAL_Y der Breite, Radius SUBDIAL_R der Breite.

    // Numerals of the generated clock faces: only 12/3/6/9 (face_default), 1-12, I-XII and 12/3/9 with a
    // seconds subdial instead of the 6 (face_subdial). Subdial: centre at SUBDIAL_Y, radius SUBDIAL_R of the width.

    enum : uint8_t { FACE_NUMERALS_QUARTER, FACE_NUMERALS_ARABIC, FACE_NUMERALS_ROMAN, FACE_NUMERALS_SUBDIAL };
    constexpr float SUBDIAL_Y = 0.72f;
    constexpr float SUBDIAL_R = 0.14f;

    // Erzeugtes Zifferblatt wie der Generator im Zifferblatt-Designer mit dessen Vorgaben: weiss, schwarzer
    // Rand, Stunden- und Minutenstriche, Ziffern. Je Pixel 4 x 4 Abtastpunkte (Kantenglaettung); zeilenweise,
    // damit nie ein ganzes Bild im RAM liegen muss.

    // Generated clock face like the generator in the clock face designer with its defaults: white, black
    // ring, hour and minute marks, numerals. 4 x 4 samples per pixel (anti-aliasing); row by row, so a whole
    // image never has to be held in RAM.

    struct DefaultFaceGen {
        struct Mark {
            int16_t x0, x1, y0, y1; // Pixelbereich des Strichs
                                    // pixel range of the mark
            int16_t s, c;           // Richtung (sin, -cos) x 1024
                                    // direction (sin, -cos) x 1024
            int16_t t0, t1, hw;     // radial von t0 bis t1, halbe Breite hw (Achtelpixel)
                                    // radially from t0 to t1, half width hw (eighths of a pixel)
            int16_t cx8, cy8;       // Mitte (Achtelpixel): Zifferblatt oder Sekundenfeld
                                    // centre (eighths of a pixel): clock face or subdial
        };

        // Strich bei Winkel a um die Mitte cx/cy (Pixel), aussen bei rOuter, Laenge len, Breite width
        // Mark at angle a around the centre cx/cy (pixels), outer end at rOuter, length len, width width

        void setMark(Mark& m, float cx, float cy, float a, int rOuter, int len, int width) {
            float s = sinf(a), c = -cosf(a);
            m.s = lroundf(s * 1024);
            m.c = lroundf(c * 1024);
            m.t0 = 8 * (rOuter - len);
            m.t1 = 8 * rOuter;
            m.hw = 4 * width;
            m.cx8 = lroundf(8 * cx);
            m.cy8 = lroundf(8 * cy);
            float minX = w, maxX = 0, minY = w, maxY = 0;
            for (int k = 0; k < 4; k++) {
                float rr = (k & 1) ? rOuter : rOuter - len, side = (k & 2) ? width / 2.0f : -width / 2.0f;
                float x = cx + s * rr - c * side, y = cy + c * rr + s * side;
                minX = min(minX, x); maxX = max(maxX, x);
                minY = min(minY, y); maxY = max(maxY, y);
            }
            m.x0 = max(0, (int)floorf(minX)); m.x1 = min(w - 1, (int)floorf(maxX));
            m.y0 = max(0, (int)floorf(minY)); m.y1 = min(w - 1, (int)floorf(maxY));
        }

        // Ziffer als fertige Deckung je Pixel (0..16 getroffene Abtastpunkte) ab x0/y0
        // Numeral as finished coverage per pixel (0..16 samples hit) from x0/y0

        struct Numeral {
            int16_t x0 = 0, y0 = 0, w = 0, h = 0;
            std::vector<uint8_t> cov;
        };
        std::vector<Mark> marks;    // 60 am Rand, mit Sekundenfeld 60 weitere darin (Heap statt Stack)
                                    // 60 at the rim, with a subdial 60 more in it (heap instead of stack)
        Numeral numerals[12];
        int w, c8, ringIn, ringOut; // Mitte und Rand (Achtelpixel)
                                    // centre and ring (eighths of a pixel)
        int32_t subX8 = 0, subY8 = 0, subIn = 0, subOut = 0; // Sekundenfeld-Ring (Achtelpixel), 0 = keiner
                                                             // subdial ring (eighths of a pixel), 0 = none
        bool round;                 // rundes Display: ausserhalb des Kreises weiss wie scaleAndSaveBmp()
                                    // round display: white outside the circle like scaleAndSaveBmp()

        // Setzt eine Ziffer in 4-facher Aufloesung (1-Bit-Sprite, je Sprite-Pixel ein Abtastpunkt) mit der
        // Mitte ihres Umrisses auf den Winkel a - so weit aussen, dass sie limitQ (Viertelpixel) nicht
        // ueberschreitet. False, wenn der Sprite keinen Speicher bekommt.

        // Places a numeral at 4x resolution (1-bit sprite, one sample per sprite pixel) with the centre of its
        // outline at angle a - as far out as possible without exceeding limitQ (quarter pixels). False if the
        // sprite gets no memory.

        bool addNumeral(Numeral& n, const char* text, const lgfx::GFXfont* font, float scale, float a, float limitQ) {
            LGFX_Sprite s;
            s.setColorDepth(1);
            s.setFont(font);
            s.setTextSize(scale);
            int margin = s.fontHeight() / 4 + 2;
            int sw = s.textWidth(text) + 2 * margin, sh = s.fontHeight() + 2 * margin;
            if (!s.createSprite(sw, sh)) return false;
            s.fillSprite(TFT_BLACK);
            s.setTextColor(TFT_WHITE);
            s.setTextDatum(lgfx::top_left);
            s.drawString(text, margin, margin);

            int bx0 = sw, bx1 = -1, by0 = sh, by1 = -1;
            for (int y = 0; y < sh; y++) {
                for (int x = 0; x < sw; x++) {
                    if (!s.readPixelValue(x, y)) continue;
                    bx0 = min(bx0, x); bx1 = max(bx1, x);
                    by0 = min(by0, y); by1 = max(by1, y);
                }
            }
            if (bx1 < 0) return true;

            // Mitte so, dass der Umriss in Strahlrichtung genau bis limitQ reicht
            // Centre placed so that the outline reaches exactly limitQ in the ray direction

            float sn = sinf(a), cs = -cosf(a);
            float extent = (bx1 - bx0 + 1) / 2.0f * fabsf(sn) + (by1 - by0 + 1) / 2.0f * fabsf(cs);
            float rq = limitQ - extent;
            int ox = lroundf(4 * w / 2.0f + sn * rq - (bx0 + bx1 + 1) / 2.0f);
            int oy = lroundf(4 * w / 2.0f + cs * rq - (by0 + by1 + 1) / 2.0f);
            n.x0 = max(0, (bx0 + ox) / 4);
            n.y0 = max(0, (by0 + oy) / 4);
            n.w = min(w - 1, (bx1 + ox) / 4) - n.x0 + 1;
            n.h = min(w - 1, (by1 + oy) / 4) - n.y0 + 1;
            if (n.w <= 0 || n.h <= 0) return true;
            n.cov.assign((size_t)n.w * n.h, 0);
            for (int y = by0; y <= by1; y++) {
                int py = (y + oy) / 4 - n.y0;
                if (py < 0 || py >= n.h) continue;
                for (int x = bx0; x <= bx1; x++) {
                    int px = (x + ox) / 4 - n.x0;
                    if (px >= 0 && px < n.w && s.readPixelValue(x, y)) n.cov[(size_t)py * n.w + px]++;
                }
            }
            return true;
        }

        // numerals: FACE_NUMERALS_*. False, wenn eine Ziffer fehlt (zu wenig Speicher) - dann nicht speichern.
        // numerals: FACE_NUMERALS_*. False if a numeral is missing (too little memory) - then do not save.

        bool init(uint8_t numeralMode) {
            w = CLOCK_WIDTH;
            round = displayGeom->round;
            int r = w / 2;
            int ring = lroundf(w * 0.02f);
            int outer = r - ring - lroundf(r * 0.03f);
            c8 = 8 * r;
            ringIn = 8 * (r - ring);
            ringOut = 8 * r;

            // 60 Striche reihum, jeder fuenfte ist ein Stundenstrich
            // 60 marks around, every fifth is an hour mark

            marks.resize(numeralMode == FACE_NUMERALS_SUBDIAL ? 120 : 60);
            for (int i = 0; i < 60; i++) {
                bool hour = (i % 5 == 0);
                setMark(marks[i], r, r, i * 2 * PI / 60, outer, lroundf(w * (hour ? 0.08f : 0.03f)),
                        max(1L, lroundf(w * (hour ? 0.025f : 0.008f))));
            }

            // Sekundenfeld: duenner Ring und 60 Striche um den Drehpunkt (Pixelmitte wie der Zeiger-Drehpunkt)
            // Seconds subdial: thin ring and 60 marks around the pivot (pixel centre like the hand pivot)

            if (numeralMode == FACE_NUMERALS_SUBDIAL) {
                float sx = w / 2 + 0.5f, sy = lroundf(w * SUBDIAL_Y) + 0.5f;
                int sr = lroundf(w * SUBDIAL_R), sw = max(1L, lroundf(w * 0.007f));
                subX8 = lroundf(8 * sx); subY8 = lroundf(8 * sy);
                subIn = 8 * (sr - sw); subOut = 8 * sr;
                for (int i = 0; i < 60; i++) {
                    bool five = (i % 5 == 0);
                    setMark(marks[60 + i], sx, sy, i * 2 * PI / 60, sr - sw - 1, lroundf(w * (five ? 0.025f : 0.012f)),
                            max(1L, lroundf(w * (five ? 0.01f : 0.004f))));
                }
            }

            // Ziffern: 1-12 in FreeSans Bold, I-XII in FreeSerif Bold, Hoehe wie im Designer (Schriftgroesse 9 %
            // der Breite); jede endet 5 % der Breite vor den Stundenstrichen.

            // Numerals: 1-12 in FreeSans Bold, I-XII in FreeSerif Bold, height as in the designer (font size 9 %
            // of the width); each ends 5 % of the width before the hour marks.

            static const char* const romanNumerals[12] = { "XII", "I", "II", "III", "IV", "V", "VI", "VII", "VIII", "IX", "X", "XI" };
            bool roman = numeralMode == FACE_NUMERALS_ROMAN;
            const lgfx::GFXfont* font = roman ? &fonts::FreeSerifBold24pt7b : &fonts::FreeSansBold24pt7b;
            int refHeight = font->glyph[(roman ? 'I' : '1') - font->first].height;
            float scale = 4 * w * (roman ? 0.06f : 0.065f) / refHeight;
            float limitQ = 4 * (outer - lroundf(w * 0.08f) - w * 0.05f);
            bool ok = true;
            for (int h = 0; h < 12; h++) {
                if (numeralMode != FACE_NUMERALS_ARABIC && numeralMode != FACE_NUMERALS_ROMAN && h % 3) continue;
                if (numeralMode == FACE_NUMERALS_SUBDIAL && h == 6) continue; // dort liegt das Sekundenfeld
                                                                              // the subdial is there
                char arabic[3];
                snprintf(arabic, sizeof(arabic), "%d", h ? h : 12);
                if (!addNumeral(numerals[h], roman ? romanNumerals[h] : arabic, font, scale, h * PI / 6, limitQ)) ok = false;
            }
            return ok;
        }

        // Eine Zeile (w Pixel, RGB565) - Schwarz deckt Weiss je nach Zahl getroffener Abtastpunkte
        // One row (w pixels, RGB565) - black covers white according to the number of samples hit

        void row(int y, uint16_t* out) const {
            uint8_t cov[CLOCK_MAX] = { 0 };
            const int32_t in2 = (int32_t)ringIn * ringIn, out2 = (int32_t)ringOut * ringOut;
            const int32_t nearIn = (int32_t)(ringIn - 6) * (ringIn - 6), nearOut = (int32_t)(ringOut + 6) * (ringOut + 6);
            const int32_t fullIn = (int32_t)(ringIn + 6) * (ringIn + 6), fullOut = (int32_t)(ringOut - 6) * (ringOut - 6);

            // Rand: Pixelmitte weit genug innen oder aussen -> ohne Abtastung entschieden
            // Ring: pixel centre far enough inside or outside -> decided without sampling

            int32_t cy = 8 * y + 4 - c8;
            for (int x = 0; x < w; x++) {
                int32_t cx = 8 * x + 4 - c8, d2 = cx * cx + cy * cy;
                if (d2 < nearIn || d2 > nearOut || (round && d2 > out2)) continue;
                if (d2 > fullIn && d2 < fullOut) { cov[x] = 16; continue; }
                for (int sy = 0; sy < 4; sy++) {
                    int32_t dy = 8 * y + 2 * sy + 1 - c8;
                    for (int sx = 0; sx < 4; sx++) {
                        int32_t dx = 8 * x + 2 * sx + 1 - c8, sd2 = dx * dx + dy * dy;
                        if (sd2 >= in2 && sd2 <= out2) cov[x]++;
                    }
                }
            }

            // Striche als gedrehte Rechtecke: radial t, quer u (beides x 1024)
            // Marks as rotated rectangles: radial t, across u (both x 1024)

            for (const Mark& m : marks) {
                if (y < m.y0 || y > m.y1) continue;
                for (int x = m.x0; x <= m.x1; x++) {
                    int n = 0;
                    for (int sy = 0; sy < 4; sy++) {
                        int32_t dy = 8 * y + 2 * sy + 1 - m.cy8;
                        for (int sx = 0; sx < 4; sx++) {
                            int32_t dx = 8 * x + 2 * sx + 1 - m.cx8;
                            int32_t t = dx * m.s + dy * m.c, u = dy * m.s - dx * m.c;
                            if (t >= m.t0 * 1024 && t <= m.t1 * 1024 && abs(u) <= m.hw * 1024) n++;
                        }
                    }
                    cov[x] = min(16, cov[x] + n);
                }
            }

            // Ring des Sekundenfelds, je Pixel 4 x 4 Abtastpunkte
            // Ring of the subdial, 4 x 4 samples per pixel

            if (subOut > 0 && abs(8 * y + 4 - subY8) <= subOut + 8) {
                for (int x = max(0L, (long)((subX8 - subOut) / 8 - 1)); x < w && 8 * x <= subX8 + subOut + 8; x++) {
                    for (int sy = 0; sy < 4; sy++) {
                        int32_t dy = 8 * y + 2 * sy + 1 - subY8;
                        for (int sx = 0; sx < 4; sx++) {
                            int32_t dx = 8 * x + 2 * sx + 1 - subX8, d2 = dx * dx + dy * dy;
                            if (d2 >= subIn * subIn && d2 <= subOut * subOut && cov[x] < 16) cov[x]++;
                        }
                    }
                }
            }
            for (const Numeral& n : numerals) {
                if (y < n.y0 || y >= n.y0 + n.h) continue;
                const uint8_t* src = n.cov.data() + (size_t)(y - n.y0) * n.w;
                for (int x = 0; x < n.w; x++) cov[n.x0 + x] = min(16, cov[n.x0 + x] + src[x]);
            }
            for (int x = 0; x < w; x++) {
                int v = 255 - (cov[x] * 255 + 8) / 16;
                uint16_t r5 = (v * 31 + 127) / 255, g6 = (v * 63 + 127) / 255;
                out[x] = (r5 << 11) | (g6 << 5) | r5;
            }
        }
    };

    // Zeichnet das Standard-Zifferblatt nach 'dest' (CLOCK_WIDTH x CLOCK_HEIGHT) - Notloesung, falls
    // face_default.bmp nicht gespeichert werden kann (Dateisystem voll).

    // Draws the default clock face into 'dest' (CLOCK_WIDTH x CLOCK_HEIGHT) - fallback in case
    // face_default.bmp cannot be stored (file system full).

    void drawDefaultFace(uint16_t* dest) {
        if (!dest) return;
        DefaultFaceGen gen;
        gen.init(FACE_NUMERALS_QUARTER);
        for (int y = 0; y < gen.w; y++) gen.row(y, dest + (size_t)y * gen.w);
    }

    // Schreibt ein Bild zeilenweise als RLEB-Datei wie hochgeladene Zifferblaetter und Zeiger: erst die Groesse
    // zaehlen, dann schreiben. rowFn liefert Zeile y (w <= CLOCK_MAX Pixel). Bei einem Fehler wird die Datei entfernt.

    // Writes an image row by row as an RLEB file like uploaded clock faces and hands: count the size first, then
    // write. rowFn delivers row y (w <= CLOCK_MAX pixels). On an error the file is removed.

    bool writeRleImage(const String& path, int w, int h, const std::function<void(int, uint16_t*)>& rowFn) {
        uint16_t row[CLOCK_MAX];
        uint8_t enc[CLOCK_MAX * 2 + 8]; // >= rleMaxEncodedSize(CLOCK_MAX)
                                        // >= rleMaxEncodedSize(CLOCK_MAX)
        uint32_t compressed = 0;
        for (int y = 0; y < h; y++) {
            rowFn(y, row);
            compressed += rleEncode565(row, w, enc);
        }
        File f = LittleFS.open(path, "w");
        if (!f) {
            DEBUG_PRINTLN("[FS] Error: couldnt create " + path);
            return false;
        }
        uint8_t header[20];
        header[0] = 'R'; header[1] = 'L'; header[2] = 'E'; header[3] = 'B';
        *(int32_t*)&header[4] = w;
        *(int32_t*)&header[8] = h;
        *(uint32_t*)&header[12] = compressed;
        *(uint32_t*)&header[16] = (uint32_t)w * h * 2;
        bool ok = f.write(header, sizeof(header)) == sizeof(header);
        for (int y = 0; ok && y < h; y++) {
            if (y % 20 == 0) yield();
            rowFn(y, row);
            size_t n = rleEncode565(row, w, enc);
            ok = f.write(enc, n) == n;
        }
        f.close();
        if (!ok) {
            LittleFS.remove(path);
            DEBUG_PRINTLN("[FS] Error: couldnt write " + path + " (file system full?)");
            return false;
        }
        DEBUG_PRINTLN("[FS] Created " + path + " (" + String(compressed + 20) + " bytes)");
        return true;
    }

    // Erzeugt ein Zifferblatt (FACE_NUMERALS_*) und speichert es unter 'path'
    // Generates a clock face (FACE_NUMERALS_*) and stores it under 'path'

    bool writeGeneratedFace(const char* path, uint8_t numeralMode) {
        DefaultFaceGen gen;
        if (!gen.init(numeralMode)) {
            DEBUG_PRINTLN(String("[FS] Error: not enough memory for the numerals of ") + path);
            return false;
        }

        // Mit Sekundenfeld gleich den passenden Drehpunkt des Sekundenzeigers (facecfg_*.txt)
        // With a subdial the matching second hand pivot right away (facecfg_*.txt)

        if (numeralMode == FACE_NUMERALS_SUBDIAL) saveFaceSettings(path, CLOCK_WIDTH / 2, lroundf(CLOCK_WIDTH * SUBDIAL_Y));
        return writeRleImage(path, gen.w, gen.w, [&gen](int y, uint16_t* row) { gen.row(y, row); });
    }

    // Zifferblaetter des Startpakets (ensureStarterSet(), refreshGeneratedAssets())
    // Clock faces of the starter set (ensureStarterSet(), refreshGeneratedAssets())

    struct StarterFace { const char* path; uint8_t numerals; };
    const StarterFace STARTER_FACES[] = {
        { "/face_default.bmp", FACE_NUMERALS_QUARTER },
        { "/face_numbers.bmp", FACE_NUMERALS_ARABIC },
        { "/face_roman.bmp", FACE_NUMERALS_ROMAN },
        { "/face_subdial.bmp", FACE_NUMERALS_SUBDIAL },
    };

    // Legt face_default.bmp (12, 3, 6, 9) an, falls es fehlt - Ersatz fuer jedes fehlende Zifferblatt
    // Creates face_default.bmp (12, 3, 6, 9) if it is missing - substitute for every missing clock face

    bool ensureDefaultFace() {
        if (LittleFS.exists("/face_default.bmp")) return true;
        return writeGeneratedFace("/face_default.bmp", FACE_NUMERALS_QUARTER);
    }

    // Laedt ein Zifferblatt nach 'dest'; fehlt es oder ist es unlesbar, das Standard-Zifferblatt (bei Bedarf
    // erzeugt, notfalls nur gezeichnet).

    // Loads a clock face into 'dest'; if it is missing or unreadable, the default clock face (created if needed,
    // drawn only as a last resort).

    void loadFaceOrDefault(const String& path, uint16_t* dest) {
        if (LittleFS.exists(path) && loadFaceBmpInto(path, dest, CLOCK_WIDTH, CLOCK_HEIGHT)) return;
        if (ensureDefaultFace() && loadFaceBmpInto("/face_default.bmp", dest, CLOCK_WIDTH, CLOCK_HEIGHT)) return;
        drawDefaultFace(dest);
    }

    // Halbe Breite eines geschwungenen Zeigers (Satz 2) im Abstand d vom Drehpunkt (Pixel, d > 0 Richtung
    // Spitze, L = Laenge): Stunden- und Minutenzeiger als Blatt mit eingezogener Spitze auf duennem Stiel,
    // runde Nabe; Sekundenzeiger spitz zulaufend mit rundem Gegengewicht.

    // Half width of a curved hand (set 2) at distance d from the pivot (pixels, d > 0 towards the tip, L =
    // length): hour and minute hand as a leaf with a drawn-in tip on a thin stem, round boss; second hand
    // tapering with a round counterweight.

    float curvedHandHalfWidth(const char* part, float L, float d) {
        float c = CLOCK_WIDTH, w = 0;
        if (strcmp(part, "second") == 0) {
            float ws = max(0.6f, 0.0045f * c);
            if (d >= 0 && d <= L) w = ws * (1 - 0.45f * d / L);
            float tail = 0.1f * c, rw = 0.022f * c, dw = d + tail - rw;
            if (d < 0 && d >= -tail) w = ws;
            if (fabsf(dw) <= rw) w = max(w, sqrtf(rw * rw - dw * dw));
            return w;
        }
        bool hour = strcmp(part, "hour") == 0;
        float u0 = hour ? 0.3f : 0.45f, leaf = (hour ? 0.036f : 0.026f) * c, k = hour ? 0.6f : 0.55f;
        if (d >= 0 && d <= L) {
            float u = d / L;
            if (u <= u0 + 0.05f) w = max(0.6f, 0.007f * c);
            if (u >= u0) w = max(w, leaf * powf(sinf(PI * powf((u - u0) / (1 - u0), k)), 1.4f));
        }
        float rb = 0.028f * c;
        if (fabsf(d) <= rb) w = max(w, sqrtf(rb * rb - d * d));
        return w;
    }

    // Erzeugte Zeigersaetze, mittig auf dem Drehpunkt, Hintergrund weiss wie bei hochgeladenen Zeigern (gilt
    // ueberall als transparent). Satz 0, 1 und 3: Stunden- und Minutenzeiger als schwarze Balken bis zum unteren
    // Bildrand, Sekundenzeiger als duenne rote (0) bzw. schwarze (1) Linie, bei 3 kurz fuers Sekundenfeld; Satz 2
    // geschwungen.

    // Generated hand sets, centred on the pivot, background white like uploaded hands (counts as transparent
    // everywhere). Sets 0, 1 and 3: hour and minute hand as black bars down to the bottom edge, second hand as a
    // thin red (0) or black (1) line, short for the subdial with 3; set 2 curved.

    // Halbe Breite des kurzen Sekundenzeigers von Satz 3 (Sekundenfeld): Nadel bis kurz vor den Feldrand, kurzes
    // Gegengewicht, eigene runde Scheibe am Drehpunkt
    // Half width of the short second hand of set 3 (subdial): needle up to just before the subdial rim, short
    // counterweight, its own round disc at the pivot

    float subdialSecondHalfWidth(float d) {
        float c = CLOCK_WIDTH, r = SUBDIAL_R * c, w = 0, rd = 0.03f * c;
        if (d >= -0.3f * r && d <= 0.92f * r) w = max(0.6f, 0.0083f * c);
        if (fabsf(d) <= rd) w = max(w, sqrtf(rd * rd - d * d));
        return w;
    }

    void generatedHandRow(int set, const char* part, int y, uint16_t* row) {
        int top = strcmp(part, "hour") == 0 ? HAND_PIVOT_Y - lroundf(HAND_LEGACY_PIVOT_Y * 0.56f) : HAND_TOP_PAD;
        bool second = strcmp(part, "second") == 0;
        if (set == 2 || (set == 3 && second)) {

            // Je Pixel 4 x 4 Abtastpunkte, gesetzt ab der Haelfte - scharfe Kante, die Uhr glaettet beim Drehen
            // 4 x 4 samples per pixel, set from half of them - sharp edge, the clock smooths when rotating

            float half[4];
            for (int sy = 0; sy < 4; sy++) {
                float d = HAND_PIVOT_Y + 0.5f - (y + (sy + 0.5f) / 4);
                half[sy] = set == 3 ? subdialSecondHalfWidth(d) : curvedHandHalfWidth(part, HAND_PIVOT_Y - top, d);
            }
            for (int x = 0; x < HAND_WIDTH; x++) {
                int n = 0;
                for (int sx = 0; sx < 4; sx++) {
                    float dx = fabsf(x + (sx + 0.5f) / 4 - (HAND_WIDTH / 2 + 0.5f));
                    for (int sy = 0; sy < 4; sy++) if (dx <= half[sy]) n++;
                }
                row[x] = n < 8 ? 0xFFFF : set == 3 ? 0xF800 : 0x0000;
            }
            return;
        }
        int half = lroundf(CLOCK_WIDTH * (second ? 0.0083f : 0.027f));
        uint16_t color = (second && set == 0) ? 0xF800 : 0x0000;
        for (int x = 0; x < HAND_WIDTH; x++) {
            row[x] = (y >= top && abs(x - HAND_WIDTH / 2) <= half) ? color : 0xFFFF;
        }
    }

    // Zeichnet einen Zeiger des Standardsatzes 0 nach 'dest' (HAND_WIDTH x HAND_HEIGHT) - Notloesung ohne Datei
    // Draws a hand of the default set 0 into 'dest' (HAND_WIDTH x HAND_HEIGHT) - fallback without a file

    void drawDefaultHand(const char* part, uint16_t* dest) {
        for (int y = 0; y < HAND_HEIGHT; y++) generatedHandRow(0, part, y, dest + y * HAND_WIDTH);
    }

    // Legt fehlende Dateien eines erzeugten Zeigersatzes an (hand_set<id>_hour/minute/second.bmp) - style waehlt
    // die Form (0-3, siehe generatedHandRow())
    // Creates missing files of a generated hand set (hand_set<id>_hour/minute/second.bmp) - style picks the
    // shape (0-3, see generatedHandRow())

    bool writeGeneratedHandSet(int style, const String& id) {
        bool ok = true;
        for (const char* part : { "hour", "minute", "second" }) {
            String path = "/hand_set" + id + "_" + part + ".bmp";
            if (LittleFS.exists(path)) continue;
            ok = writeRleImage(path, HAND_WIDTH, HAND_HEIGHT, [style, part](int y, uint16_t* row) { generatedHandRow(style, part, y, row); }) && ok;
        }
        return ok;
    }

    bool handSetExists(const String& id) {
        for (const char* part : { "hour", "minute", "second" }) {
            if (LittleFS.exists("/hand_set" + id + "_" + part + ".bmp")) return true;
        }
        return false;
    }

    // Nummer des Zeigersatzes fuers Sekundenfeld (Form 3): beim ersten Mal die erste freie ab 3 - auf aelteren
    // Uhren kann 3 schon ein eigener Satz sein -, danach gemerkt (PK_SUBDIAL_SET)
    // Number of the hand set for the subdial (style 3): the first free one from 3 the first time - on older
    // clocks 3 can already be an own set -, remembered afterwards (PK_SUBDIAL_SET)

    String subdialHandSet() {
        String id = preferences.getString(PK_SUBDIAL_SET, "");
        if (id.length()) return id;
        int n = 3;
        while (n < 99 && handSetExists(String(n))) n++;
        id = String(n);
        preferences.putString(PK_SUBDIAL_SET, id);
        return id;
    }

    // Von der Firmware erzeugte Dateien (Startpaket): die Zifferblaetter STARTER_FACES und die Zeigersaetze 0, 1, 2
    // und der Sekundenfeld-Satz. Sie lassen sich weder loeschen noch umbenennen noch ueberschreiben (Weboberflaeche,
    // Upload, Designer, Sicherung) - die Uhr erzeugt sie bei Bedarf neu.

    // Files created by the firmware (starter set): the clock faces STARTER_FACES and the hand sets 0, 1, 2 and the
    // subdial set. They can be neither deleted nor renamed nor overwritten (web interface, upload, designer,
    // backup) - the clock creates them again when needed.

    bool isProtectedHandSetId(const String& id) {
        return id == "0" || id == "1" || id == "2" || id == subdialHandSet();
    }

    bool isProtectedFile(const String& path) {
        String name = path.startsWith("/") ? path.substring(1) : path;
        if (name.startsWith("face_")) {
            for (const auto& f : STARTER_FACES) {
                if (name == String(f.path + 1)) return true;
            }
            return false;
        }
        if (name.startsWith("hand_set") && name.endsWith(".bmp")) {
            int us = name.indexOf('_', 8);
            return us > 8 && isProtectedHandSetId(name.substring(8, us));
        }
        return false;
    }

    // Namen fuer die Designer-Seiten und die Reihenfolge der Uebersichten (Startpaket zuerst)
    // Names for the designer pages and the order of the overviews (starter set first)

    String protectedFacesJs() {
        String out;
        for (const auto& f : STARTER_FACES) out += String(out.length() ? "," : "") + "'" + (f.path + 1) + "'";
        return out;
    }

    String protectedSetsJs() {
        return String("'0','1','2','") + subdialHandSet() + "'";
    }

    // Datei kopieren (LittleFS)
    // Copy a file (LittleFS)

    bool copyLittleFile(const String& from, const String& to) {
        File in = LittleFS.open(from, "r");
        if (!in) return false;
        File out = LittleFS.open(to, "w");
        if (!out) {
            in.close();
            return false;
        }
        uint8_t buf[512];
        bool ok = true;
        for (size_t n = in.read(buf, sizeof(buf)); n > 0 && ok; n = in.read(buf, sizeof(buf))) ok = out.write(buf, n) == n;
        in.close();
        out.close();
        if (!ok) LittleFS.remove(to);
        return ok;
    }

    // Jeder Zeigersatz bekommt alle drei Zeiger: einen fehlenden kopiert die Uhr aus dem Satz 0 (bisher zeigte sie
    // ihn nur ersatzweise an). So bleibt ein Satz auch bestehen, wenn sich Satz 0 aendert, und jeder Zeiger
    // laesst sich einzeln anpassen.

    // Every hand set gets all three hands: the clock copies a missing one from set 0 (it used to show it only as a
    // substitute). This way a set stays as it is when set 0 changes, and every hand can be adjusted on its own.

    void completeHandSet(const String& id) {
        if (id.isEmpty() || id == "0" || id.startsWith("~")) return;
        for (const char* part : { "hour", "minute", "second" }) {
            String path = "/hand_set" + id + "_" + part + ".bmp", source = String("/hand_set0_") + part + ".bmp";
            if (!LittleFS.exists(path) && LittleFS.exists(source)) copyLittleFile(source, path);
        }
    }

    void completeHandSets() {
        std::set<String> ids;
        File root = LittleFS.open("/");
        for (File f = root.openNextFile(); f; f = root.openNextFile()) {
            String n = f.name();
            if (f.isDirectory() || !n.startsWith("hand_set") || !n.endsWith(".bmp")) continue;
            int us = n.indexOf('_', 8);
            if (us > 8) ids.insert(n.substring(8, us));
        }
        root.close();
        for (const String& id : ids) completeHandSet(id);
    }

    // Alle Zeigerdateien im neuen Format (HAND_WIDTH x HAND_HEIGHT) speichern. Zeiger im alten Format (schmaler
    // und/oder kuerzer) werden transparent aufgefuellt wie beim Laden (placeHand) - verlustfrei, die Uhr zeigt sie
    // unveraendert. Dateien anderer Groesse bleiben unberuehrt. Gibt die Zahl der umgeschriebenen Dateien zurueck.

    // Store all hand files in the new format (HAND_WIDTH x HAND_HEIGHT). Hands in the old format (narrower
    // and/or shorter) are padded transparent as when loading (placeHand) - lossless, the clock shows them
    // unchanged. Files of any other size stay untouched. Returns the number of rewritten files.

    int upgradeHandFiles() {
        std::vector<String> names;
        File root = LittleFS.open("/");
        for (File f = root.openNextFile(); f; f = root.openNextFile()) {
            String n = f.name();
            if (f.isDirectory() || !n.startsWith("hand_set") || !n.endsWith(".bmp")) continue;
            int32_t w, h;
            if (readImageSize(("/" + n).c_str(), w, h) && isValidHandSize(w, h) && (w != HAND_WIDTH || h != HAND_HEIGHT)) names.push_back(n);
        }
        root.close();
        if (names.empty()) return 0;

        uint16_t* pixels = (uint16_t*)preferPsramMalloc((size_t)HAND_WIDTH * HAND_HEIGHT * sizeof(uint16_t));
        if (!pixels) return 0;
        const String tmp = "/hand_upgrade.tmp";
        int done = 0;
        for (const String& n : names) {
            String path = "/" + n;
            if (!loadHandPixels(path, pixels)) continue;
            bool ok = writeRleImage(tmp, HAND_WIDTH, HAND_HEIGHT, [pixels](int y, uint16_t* row) {
                memcpy(row, pixels + (size_t)y * HAND_WIDTH, (size_t)HAND_WIDTH * sizeof(uint16_t));
            });
            if (ok && LittleFS.rename(tmp, path)) done++; // rename ersetzt die alte Datei in einem Schritt
                                                          // rename replaces the old file in one step
            else LittleFS.remove(tmp);
        }
        free(pixels);
        DEBUG_PRINTLN("[Starter] Hand files brought to the new size: " + String(done));
        return done;
    }

    // Legt fehlende Dateien des Standardsatzes 0 an - Ersatz fuer jeden fehlenden Zeiger
    // Creates missing files of the default set 0 - substitute for every missing hand

    bool ensureDefaultHands() {
        if (LittleFS.exists("/hand_set0_hour.bmp") && LittleFS.exists("/hand_set0_minute.bmp") &&
            LittleFS.exists("/hand_set0_second.bmp")) return true;
        return writeGeneratedHandSet(0, "0");
    }

    // Satz-ID der Dateien: leer und "default" (alte Einstellungen, Presets) stehen fuer den Standardsatz 0
    // Set ID of the files: empty and "default" (old settings, presets) stand for the default set 0

    String handSetFileId(const String& setId) {
        return (setId.isEmpty() || setId == "default") ? String("0") : setId;
    }

    // Laedt einen Zeiger des Satzes nach 'dest'; fehlt er, den des Standardsatzes 0 (bei Bedarf erzeugt, notfalls
    // nur gezeichnet).

    // Loads a hand of the set into 'dest'; if it is missing, the one of the default set 0 (created if needed, drawn
    // only as a last resort).

    void loadHandOrDefault(const String& setId, const char* part, uint16_t* dest) {
        String path = "/hand_set" + handSetFileId(setId) + "_" + part + ".bmp";
        if (LittleFS.exists(path) && loadHandPixels(path, dest)) return;
        String fallback = String("/hand_set0_") + part + ".bmp";
        if (ensureDefaultHands() && loadHandPixels(fallback, dest)) return;
        drawDefaultHand(part, dest);
    }

    // Liest eine face_*.bmp-Datei (Standard-BMP oder RLEB-komprimiert) direkt in
    // 'dest' (expectedW x expectedH, RGB565, Top-Down). False bei Lesefehler
    // oder falschen Dimensionen (dest bleibt dann unveraendert).

    // Reads a face_*.bmp file (standard BMP or RLEB-compressed) directly into
    // 'dest' (expectedW x expectedH, RGB565, top-down). False on read error
    // or wrong dimensions (dest stays unchanged in that case).

    bool loadFaceBmpInto(const String& path, uint16_t* dest, int32_t expectedW, int32_t expectedH) {
        File f = LittleFS.open(path, "r");
        if (!f) return false;

        uint8_t magic[4];
        if (f.read(magic, 4) != 4) { f.close(); return false; }

        if (isRleFace(magic)) {
            uint8_t rest[16];
            if (f.read(rest, 16) != 16) { f.close(); return false; }
            int32_t width = *(int32_t*)&rest[0];
            int32_t height = *(int32_t*)&rest[4];
            uint32_t compressedSize = *(uint32_t*)&rest[8];
            uint32_t uncompressedSize = *(uint32_t*)&rest[12];

            if (width != expectedW || height != expectedH ||
                uncompressedSize != (uint32_t)width * height * 2) {
                f.close();
                return false;
            }

            uint8_t* compBuf = (uint8_t*)preferPsramMalloc(compressedSize);
            if (!compBuf) { f.close(); return false; }
            if (f.read(compBuf, compressedSize) != compressedSize) {
                free(compBuf); f.close(); return false;
            }
            f.close();

            rleDecode565(compBuf, compressedSize, dest, (size_t)width * height);
            free(compBuf);
            return true;
        }
        else {
            f.seek(0);
            uint8_t header[54];
            if (f.read(header, 54) != 54 || header[0] != 'B' || header[1] != 'M') {
                f.close();
                return false;
            }
            int32_t width = *(int32_t*)&header[18];
            int32_t height = *(int32_t*)&header[22];
            uint16_t bpp = *(uint16_t*)&header[28];
            uint32_t offset = *(uint32_t*)&header[10];

            if (width != expectedW || abs(height) != expectedH || bpp != 16) {
                f.close();
                return false;
            }
            bool flip = height > 0;
            height = abs(height);

            int rowSize = ((width * 2 + 3) / 4) * 4;
            for (int y = 0; y < height; y++) {
                int row = flip ? height - 1 - y : y;
                f.seek(offset + (uint32_t)rowSize * y);

                // Rueckgabewert pruefen: bei unvollstaendiger Zeile false liefern,
                // sonst enthaelt dest teils uninitialisierten Speicher, obwohl der
                // Aufrufer es als vollstaendig geladen behandelt.

                // Check the return value: return false on an incomplete row,
                // otherwise dest partly holds uninitialized memory while the
                // caller treats it as fully loaded.

                if (f.read((uint8_t*)&dest[row * width], width * 2) != width * 2) {
                    f.close();
                    return false;
                }
            }
            f.close();
            return true;
        }
    }

    // Zeigerbild (w x h, je altes oder neues Mass) waagerecht mittig und unten
    // buendig in 'dest' (HAND_WIDTH x HAND_HEIGHT) setzen, der Rest transparent -
    // Drehpunkt und Stueck unter dem Drehpunkt liegen dann wie im neuen Format.

    // Put a hand image (w x h, old or new size each) horizontally centred and
    // flush at the bottom into 'dest' (HAND_WIDTH x HAND_HEIGHT), the rest
    // transparent - pivot and the part below it then sit like in the new format.

    void placeHand(const uint16_t* src, int w, int h, uint16_t* dest) {
        int ox = (HAND_WIDTH - w) / 2, oy = HAND_HEIGHT - h;
        for (int i = 0; i < HAND_WIDTH * HAND_HEIGHT; i++) dest[i] = TRANSPARENT_COLOR;
        for (int y = 0; y < h; y++) memcpy(dest + (y + oy) * HAND_WIDTH + ox, src + y * w, (size_t)w * sizeof(uint16_t));
    }

    // Laedt eine Zeigerdatei (BMP/RLEB) in einem der vier gueltigen Formate (Breite
    // und Hoehe je alt oder neu) nach 'dest'. False, wenn keines passt.

    // Loads a hand file (BMP/RLEB) in one of the four valid formats (width and
    // height old or new each) into 'dest'. False if none matches.

    bool loadHandPixels(const String& path, uint16_t* dest) {
        if (loadFaceBmpInto(path, dest, HAND_WIDTH, HAND_HEIGHT)) return true;
        const int formats[3][2] = {
            { HAND_WIDTH, HAND_LEGACY_HEIGHT }, { HAND_LEGACY_WIDTH, HAND_HEIGHT }, { HAND_LEGACY_WIDTH, HAND_LEGACY_HEIGHT }
        };
        uint16_t* tmp = (uint16_t*)preferPsramMalloc((size_t)HAND_WIDTH * HAND_HEIGHT * sizeof(uint16_t));
        if (!tmp) return false;
        bool ok = false;
        for (const auto& fm : formats) {
            if (loadFaceBmpInto(path, tmp, fm[0], fm[1])) {
                placeHand(tmp, fm[0], fm[1], dest);
                ok = true;
                break;
            }
        }
        free(tmp);
        return ok;
    }

    // Zielgroesse beim Speichern einer Zeigerdatei: eines der vier gueltigen Formate bleibt unskaliert, alles
    // andere wird auf das Legacy-Format (HAND_LEGACY_WIDTH/-HEIGHT) skaliert.

    // Target size when storing a hand file: one of the four valid formats stays unscaled, everything else is
    // scaled to the legacy format (HAND_LEGACY_WIDTH/-HEIGHT).

    void handTargetSize(const char* path, int& outW, int& outH) {
        outW = HAND_LEGACY_WIDTH;
        outH = HAND_LEGACY_HEIGHT;
        int32_t w, h;
        if (readImageSize(path, w, h) && isValidHandSize(w, h)) {
            outW = w;
            outH = h;
        }
    }

    // Breite und Hoehe aus dem Kopf einer BMP- oder RLEB-Datei, ohne Pixel zu lesen
    // Width and height from the header of a BMP or RLEB file, without reading pixels

    bool readImageSize(const char* path, int32_t& w, int32_t& h) {
        w = 0;
        h = 0;
        File f = LittleFS.open(path, "r");
        if (!f) return false;
        uint8_t head[26];
        int n = f.read(head, sizeof(head));
        f.close();

        if (n >= 12 && isRleFace(head)) {
            w = *(int32_t*)&head[4];
            h = *(int32_t*)&head[8];
        }
        else if (n == (int)sizeof(head) && head[0] == 'B' && head[1] == 'M') {
            w = *(int32_t*)&head[18];
            h = abs(*(int32_t*)&head[22]);
        }
        return w > 0 && h > 0;
    }

    // Versionskennung einer Datei (Groesse, Aenderungszeit, Displaygroesse) fuer Bild-Adressen "&v=...": ein Bild
    // laesst sich dauerhaft zwischenspeichern, weil sich die Adresse mit der Datei aendert.

    // Version tag of a file (size, modification time, display size) for image addresses "&v=...": an image can be
    // cached permanently because the address changes with the file.

    String fileVersion(const String& path) {
        File f = LittleFS.open(path, "r");
        if (!f) return "0";
        String v = String((uint32_t)f.size(), HEX) + "-" + String((uint32_t)f.getLastWrite(), HEX) + "-" + String(CLOCK_WIDTH, HEX);
        f.close();
        return v;
    }

    bool isValidHandSize(int32_t w, int32_t h) {
        return (w == HAND_WIDTH || w == HAND_LEGACY_WIDTH) && (h == HAND_HEIGHT || h == HAND_LEGACY_HEIGHT);
    }

    // Kurzbezeichnung des Zeigerformats fuer den Dateimanager
    // Short label of the hand format for the file manager

    String handFormatLabel(const String& path) {
        int32_t w, h;
        if (!readImageSize(path.c_str(), w, h)) return "";
        if (!isValidHandSize(w, h)) return translate("unsupported size - default hand is used");
        if (w == HAND_LEGACY_WIDTH && h == HAND_LEGACY_HEIGHT) return translate("old format");
        if (w == HAND_WIDTH && h == HAND_HEIGHT) return translate("new format");
        return (w == HAND_WIDTH) ? translate("new width") : translate("new length");
    }

    // Liest ein RLEB-Zifferblatt Pixel fuer Pixel - aus dem RAM (clockFaceRle) oder in kleinen Bloecken aus der
    // Datei. Laeufe duerfen ueber Zeilengrenzen gehen (scaleAndSaveBmp() kodiert das ganze Bild am Stueck).

    // Reads an RLEB clock face pixel by pixel - from RAM (clockFaceRle) or in small blocks from the file. Runs
    // may cross row boundaries (scaleAndSaveBmp() encodes the whole image in one go).

    struct RleFaceReader {
        const uint8_t* mem = nullptr;
        File file;
        uint8_t buf[256];
        size_t bufLen = 0, bufPos = 0;
        size_t remaining = 0;   // noch nicht gelesene komprimierte Bytes
                                // compressed bytes not read yet
        int runLeft = 0;
        bool literal = false;
        uint16_t runPixel = 0;

        bool nextByte(uint8_t& b) {
            if (remaining == 0) return false;
            if (mem) {
                b = *mem++;
            }
            else {
                if (bufPos >= bufLen) {
                    bufLen = file.read(buf, min(sizeof(buf), remaining));
                    bufPos = 0;
                    if (bufLen == 0) return false;
                }
                b = buf[bufPos++];
            }
            remaining--;
            return true;
        }

        bool nextPixel(uint16_t& px) {
            uint8_t lo, hi;
            if (runLeft == 0) {
                uint8_t ctrl;
                if (!nextByte(ctrl)) return false;
                literal = ctrl <= 127;
                runLeft = literal ? ctrl + 1 : 257 - ctrl;
                if (!literal) {
                    if (!nextByte(lo) || !nextByte(hi)) return false;
                    runPixel = lo | (hi << 8);
                }
            }
            if (literal) {
                if (!nextByte(lo) || !nextByte(hi)) return false;
                px = lo | (hi << 8);
            }
            else {
                px = runPixel;
            }
            runLeft--;
            return true;
        }
    };

    // Ohne PSRAM: nur mit Rohbild, Helligkeits-Cache und Zwischenbild (je ein Vollbild) bliebe beim 240er-Display
    // fuer WLAN und Webserver kein Speicher. Dann zeichnet loadClockFace() jedes Bild aus den RLE-Daten neu.

    // Without PSRAM: with raw image, brightness cache and composite (one full frame each) nothing would be left for
    // WiFi and web server on the 240 display. Then loadClockFace() redraws every frame from the RLE data.

    bool lowMemoryFace() {
        return !psramFound();
    }

    // Waehlt die Quelle des Zifferblatts im Sparmodus: die gewaehlte RLEB-Datei in passender Groesse, sonst
    // face_default.bmp, sonst das erzeugte Zifferblatt. Kleine Dateien kommen ganz in den RAM, solange danach
    // noch genug fuer WLAN und Webserver frei bleibt.

    // Chooses the clock face source in low-memory mode: the selected RLEB file of the right size, otherwise
    // face_default.bmp, otherwise the generated clock face. Small files go completely into RAM, as long as
    // enough stays free for WiFi and web server afterwards.

    void prepareClockFaceRle() {
        parseBackgroundFilename(selectedBackground, hourHandWidth, minuteHandWidth, secondHandWidth);
        updateHandWidths(hourHandWidth, minuteHandWidth, secondHandWidth);
        if (clockFaceRleReady) return;
        clockFaceRleReady = true;
        clockFaceRlePath = "";

        if (!selectedBackground.startsWith("/")) selectedBackground = "/" + selectedBackground;
        int32_t w, h;
        if (readRleSize(selectedBackground, w, h) && w == CLOCK_WIDTH && h == CLOCK_HEIGHT) {
            clockFaceRlePath = selectedBackground;
        }
        else if (ensureDefaultFace() && readRleSize("/face_default.bmp", w, h) && w == CLOCK_WIDTH && h == CLOCK_HEIGHT) {
            clockFaceRlePath = "/face_default.bmp";
        }
        if (clockFaceRlePath.isEmpty()) {
            DEBUG_PRINTLN("[Display] No usable clock face file - drawing the generated one");
            return;
        }

        const size_t RLE_RAM_MAX = 48 * 1024;      // groessere Dateien (Fotos) bleiben in der Datei
                                                   // larger files (photos) stay in the file
        const size_t HEAP_RESERVE = 96 * 1024;     // bleibt fuer WLAN, Webserver und Dateizugriffe frei
                                                   // stays free for WiFi, web server and file access
        File f = LittleFS.open(clockFaceRlePath, "r");
        uint8_t head[20];
        if (!f || f.read(head, sizeof(head)) != sizeof(head)) {
            if (f) f.close();
            return;
        }
        size_t size = *(uint32_t*)&head[12];
        if (size <= RLE_RAM_MAX && ESP.getMaxAllocHeap() >= size + HEAP_RESERVE) {
            clockFaceRle = (uint8_t*)malloc(size);
            if (clockFaceRle && f.read(clockFaceRle, size) == size) {
                clockFaceRleSize = size;
            }
            else if (clockFaceRle) {
                free(clockFaceRle);
                clockFaceRle = nullptr;
            }
        }
        f.close();
        DEBUG_PRINTLN("[Display] Low-memory clock face: " + clockFaceRlePath + " (" + String(size) + " bytes, " +
                      (clockFaceRle ? "in RAM" : "read from file") + ")");
    }

    // Zeichnet das Zifferblatt im Sparmodus zeilenweise in 'dest', mit Helligkeit. Software-Rotation gibt es
    // ohne PSRAM nicht (gc9d01SwRotation), daher immer ungedreht.

    // Draws the clock face row by row into 'dest' in low-memory mode, with brightness. Without PSRAM there is
    // no software rotation (gc9d01SwRotation), so always unrotated.

    void drawFaceRows(LGFX_Sprite& dest) {
        const int N = CLOCK_WIDTH;
        if (clockFaceRlePath.isEmpty()) {
            DefaultFaceGen gen;
            gen.init(FACE_NUMERALS_QUARTER);
            for (int y = 0; y < N; y++) {
                gen.row(y, rowBuffer);
                for (int x = 0; x < N; x++) rowBuffer[x] = setPixelBrightness(rowBuffer[x]);
                dest.pushImage(0, y, N, 1, rowBuffer);
            }
            return;
        }
        RleFaceReader r;
        if (clockFaceRle) {
            r.mem = clockFaceRle;
            r.remaining = clockFaceRleSize;
        }
        else {
            r.file = LittleFS.open(clockFaceRlePath, "r");
            uint8_t head[20];
            if (r.file && r.file.read(head, sizeof(head)) == sizeof(head)) r.remaining = *(uint32_t*)&head[12];
        }
        for (int y = 0; y < CLOCK_HEIGHT; y++) {
            for (int x = 0; x < N; x++) {
                uint16_t px = 0xFFFF;   // weiss, falls die Daten zu kurz sind / white if the data is too short
                r.nextPixel(px);
                rowBuffer[x] = setPixelBrightness(px);
            }
            dest.pushImage(0, y, N, 1, rowBuffer);
        }
        if (r.file) r.file.close();
    }

    // Laedt das gewaehlte Zifferblatt (BMP/RLEB, sonst Standard) in clockFaceBuffer, wendet die Helligkeit an
    // (clockFaceBrightBuffer) und zeichnet in backgroundSprite. Rueckgabe: 2 = beide Puffer ok, 1 = nur
    // Rohbild, 0 = nichts, 3 = Sparmodus ohne PSRAM (drawFaceRows()).

    // Loads the selected clock face (BMP/RLEB, else default) into clockFaceBuffer, applies brightness
    // (clockFaceBrightBuffer) and draws into backgroundSprite. Returns: 2 = both buffers ok, 1 = raw only, 0
    // = neither, 3 = low-memory mode without PSRAM (drawFaceRows()).

    int prepareClockFaceCache() {
        if (lowMemoryFace()) {
            prepareClockFaceRle();
            return 3;
        }

        bool forceRecompute = false; // Neues Zifferblatt geladen -> Cache muss neu berechnet werden
                                     // New clock face loaded -> cache must be recalculated

        // Prüfen, ob Buffer schon existiert
        // Check whether the buffer already exists

        if (!clockFaceBuffer) {
            size_t bufSize = CLOCK_WIDTH * CLOCK_HEIGHT * sizeof(uint16_t);
            if (psramFound() and ESP.getFreePsram() > bufSize) {
                DEBUG_PRINTLN("[PSRAM] Allocate psram");
                clockFaceBuffer = (uint16_t*)ps_malloc(bufSize);
            }
            else {

                // String(bufSize) explizit: "..." + bufSize waere Zeigerarithmetik
                // auf dem String-Literal statt Verkettung und liest wild aus dem Speicher.

                // String(bufSize) explicitly: "..." + bufSize would be pointer
                // arithmetic on the literal instead of concatenation, reading wild memory.

                DEBUG_PRINTLN("allocate ram: " + String(bufSize));
                DEBUG_PRINTLN("[PSRAM] Allocate ram");
                clockFaceBuffer = (uint16_t*)malloc(bufSize);
            }
            if (!clockFaceBuffer) {
                DEBUG_PRINTLN("[PSRAM] Error: couldnt allocate clockFaceBuffer RAM!");
                return 0;
            }


            if (!selectedBackground.startsWith("/")) selectedBackground = "/" + selectedBackground;

            // Bild aus Datei laden (Standard-BMP oder RLEB), sonst das Standard-Zifferblatt
            // Load the image from file (standard BMP or RLEB), otherwise the default clock face

            loadFaceOrDefault(selectedBackground, clockFaceBuffer);
            forceRecompute = true;
        }

        // Breiten aus Dateinamen extrahieren
        // Extract widths from the filename

        parseBackgroundFilename(selectedBackground, hourHandWidth, minuteHandWidth, secondHandWidth);
        updateHandWidths(hourHandWidth, minuteHandWidth, secondHandWidth);


        // Cache-Puffer fuer die bereits helligkeitsangepasste Fassung des
        // Zifferblatts anlegen, falls noch nicht vorhanden.

        // Allocate the cache buffer for the already brightness-adjusted
        // version of the clock face, if not already present.

        if (!clockFaceBrightBuffer) {
            size_t bufSize = CLOCK_WIDTH * CLOCK_HEIGHT * sizeof(uint16_t);
            if (psramFound() and ESP.getFreePsram() > bufSize) {
                clockFaceBrightBuffer = (uint16_t*)ps_malloc(bufSize);
            }
            else {
                clockFaceBrightBuffer = (uint16_t*)malloc(bufSize);
            }
            if (!clockFaceBrightBuffer) {
                DEBUG_PRINTLN("[PSRAM] Error: couldnt allocate clockFaceBrightBuffer RAM! Falling back to per-pixel path");

                // Ohne Cache muss der Aufrufer Pixel fuer Pixel selbst rechnen
                // (funktionsfaehig, nur ohne die Optimierung) - siehe
                // loadClockFace() weiter unten.

                // Without the cache the caller has to do the per-pixel work
                // itself (works, just without the optimization) - see
                // loadClockFace() further below.

                return 1;
            }
            forceRecompute = true;
        }

        // Die teure Helligkeitsanpassung Pixel fuer Pixel nur bei Aenderung (neues Zifferblatt, Helligkeit).
        // Mit Backlight aendert die Helligkeit keine Pixel - dann nur bei neuem Zifferblatt bzw. Umschalten
        // (forceRecompute).

        // Run the costly per-pixel brightness adjustment only on a change (new clock face, brightness). With
        // a backlight, brightness changes no pixels - then only on a new clock face or when switching
        // (forceRecompute).

        if (forceRecompute || (!useBacklight && currentBrightness != lastAppliedBrightness)) {
            for (int i = 0; i < CLOCK_WIDTH * CLOCK_HEIGHT; i++) {
                clockFaceBrightBuffer[i] = setPixelBrightness(clockFaceBuffer[i]);
            }
            lastAppliedBrightness = currentBrightness;
        }

        // GC9D01 mit PSRAM hat keine Hardware-Rotation: Zeiger (rotatedAngle()) und hier auch das Zifferblatt
        // werden per Software gedreht. 'rotation' ist die Zielausrichtung dieses Displays; bei
        // Hardware-Rotation gilt faceOrientation=0.

        // GC9D01 with PSRAM has no hardware rotation: hands (rotatedAngle()) and here the clock face too are
        // rotated in software. 'rotation' is this display's target orientation; with hardware rotation
        // faceOrientation=0 applies.

        return 2;
    }


    // Software-Ausrichtung fuer DIESES Display. Bei Hardware-Rotation (alle
    // Boards ausser GC9D01) uebernimmt MADCTL die Drehung, hier bleibt es bei 0.

    // Software orientation for THIS display. With hardware rotation (every
    // board except GC9D01) MADCTL does the rotation, so this stays 0.

    int faceOrientationFor(uint8_t rotation) {
        return gc9d01SwRotation ? rotation : 0;
    }


    // Kopiert das Zifferblatt in ein Sprite, bei Bedarf gedreht - gleiche
    // Abbildung wie loadClockFace(), aber in ein beliebiges Ziel, da
    // buildHandComposite() in sein eigenes Zwischenbild-Sprite zeichnet.

    // Copies the clock face into a sprite, rotated if needed - same mapping
    // as loadClockFace(), but into any target, since buildHandComposite()
    // draws into its own composite sprite.

    bool blitFaceIntoSprite(LGFX_Sprite& dest, uint8_t rotation) {
        if (dest.width() <= 0) return false;
        if (prepareClockFaceCache() != 2) return false;

        const int N = CLOCK_WIDTH;
        int faceOrientation = faceOrientationFor(rotation);

        if (faceOrientation == 0) {
            dest.pushImage(0, 0, N, CLOCK_HEIGHT, clockFaceBrightBuffer);
            return true;
        }

        for (int y = 0; y < N; y++) {
            for (int x = 0; x < N; x++) {
                int srcX, srcY;
                switch (faceOrientation) {
                    case 1:  srcX = y;         srcY = N - 1 - x; break; // 90 Grad im Uhrzeigersinn
                                                                        // 90 degrees clockwise
                    case 2:  srcX = N - 1 - x; srcY = N - 1 - y; break; // 180 Grad
                                                                        // 180 degrees
                    default: srcX = N - 1 - y; srcY = x;         break; // 270 Grad im Uhrzeigersinn
                                                                        // 270 degrees clockwise
                }
                rowBuffer[x] = clockFaceBrightBuffer[srcY * N + srcX];
            }
            dest.pushImage(0, y, N, 1, rowBuffer);
        }
        return true;
    }


    // Zeichnet das Zifferblatt ins backgroundSprite.
    // Draws the clock face into backgroundSprite.

    void loadClockFace(uint8_t rotation) {
        int cacheState = prepareClockFaceCache();
        if (cacheState == 0) return;
        if (cacheState == 3) {
            drawFaceRows(backgroundSprite);
            return;
        }

        if (cacheState == 1) {

            // Kein Helligkeits-Cache verfuegbar: Pixel fuer Pixel rechnen,
            // Rotation wird dabei beruecksichtigt (sonst bliebe das Zifferblatt
            // bei Software-Rotation ungedreht, waehrend die Zeiger sich drehen).

            // No brightness cache available: compute pixel by pixel, taking
            // rotation into account (otherwise the face would stay unrotated
            // under software rotation while the hands rotate).

            const int N = CLOCK_WIDTH;
            int fallbackOrientation = faceOrientationFor(rotation);

            for (int y = 0; y < N; y++) {
                for (int x = 0; x < N; x++) {
                    int srcX = x, srcY = y;
                    switch (fallbackOrientation) {
                        case 1:  srcX = y;         srcY = N - 1 - x; break;
                        case 2:  srcX = N - 1 - x; srcY = N - 1 - y; break;
                        case 3:  srcX = N - 1 - y; srcY = x;         break;
                        default: break; // 0 Grad: unveraendert
                                        // 0 degrees: unchanged
                    }
                    rowBuffer[x] = setPixelBrightness(clockFaceBuffer[srcY * N + srcX]);
                }
                backgroundSprite.pushImage(0, y, N, 1, rowBuffer);
            }
            return;
        }

        int faceOrientation = faceOrientationFor(rotation);

        if (faceOrientation == 0) {

            // Guenstiger Regelfall: den vorberechneten Puffer in einem Rutsch ins
            // Sprite kopieren - loescht dabei auch die alte Zeigerposition vom
            // letzten Tick, ohne die Helligkeit erneut pro Pixel berechnen zu muessen.

            // Cheap common case: copy the precomputed buffer into the
            // sprite in one go - this also clears the old hand position
            // from the last tick, without recalculating brightness per pixel.

            backgroundSprite.pushImage(0, 0, CLOCK_WIDTH, CLOCK_HEIGHT, clockFaceBrightBuffer);
        }
        else {

            // Zeilenweise mit gedrehten Quellkoordinaten (quadratisch, kein
            // Breiten-/Hoehentausch). Richtung passend zur Zeigerformel
            // (angle + orientation*90, im Uhrzeigersinn) gewaehlt.

            // Row by row with rotated source coordinates (square, no width/
            // height swap needed). Direction matches the hand formula
            // (angle + orientation*90, clockwise).

            const int N = CLOCK_WIDTH;
            for (int y = 0; y < N; y++) {
                for (int x = 0; x < N; x++) {
                    int srcX, srcY;
                    switch (faceOrientation) {
                        case 1:  srcX = y;         srcY = N - 1 - x; break; // 90 Grad im Uhrzeigersinn
                                                                            // 90 degrees clockwise
                        case 2:  srcX = N - 1 - x; srcY = N - 1 - y; break; // 180 Grad
                                                                            // 180 degrees
                        default: srcX = N - 1 - y; srcY = x;         break; // 270 Grad im Uhrzeigersinn
                                                                            // 270 degrees clockwise
                    }
                    rowBuffer[x] = clockFaceBrightBuffer[srcY * N + srcX];
                }
                backgroundSprite.pushImage(0, y, N, 1, rowBuffer);
            }
        }
    }


    // Buffer freigeben, wenn ein neues Zifferblatt gewählt wird
    // Free the buffer when a new clock face is selected

    void freeClockFaceBuffer() {

        // Zwischenbilder ungueltig machen: sie enthalten das alte Zifferblatt.
        // Invalidate the composite images: they contain the old clock face.

        clockAssetGeneration++;

        if (clockFaceBuffer) {
            free(clockFaceBuffer);
            clockFaceBuffer = nullptr;
            // DEBUG_PRINTLN("[clockFaceBuffer] free");
        }
        if (clockFaceBrightBuffer) {
            free(clockFaceBrightBuffer);
            clockFaceBrightBuffer = nullptr;
        }
        if (clockFaceRle) {
            free(clockFaceRle);
            clockFaceRle = nullptr;
        }
        clockFaceRleSize = 0;
        clockFaceRleReady = false;
    }


    // Loescht alle Zifferblaetter (face_*.bmp) - die drei erzeugten Zifferblaetter entstehen danach neu
    // (ensureDefaultFace()). Raeumt verwaiste Presets auf und schaltet auf den Standard zurueck.

    // Deletes all clock faces (face_*.bmp) - the three generated clock faces are created again afterwards
    // (ensureDefaultFace()). Cleans up orphaned presets and falls back to the default.

    void resetFacesToDefault() {
        std::vector<String> toDelete;
        File root = LittleFS.open("/");
        File file = root.openNextFile();
        while (file) {
            String name = file.name();
            if (!file.isDirectory() && name.startsWith("face_") && name.endsWith(".bmp") && !isProtectedFile(name)) {
                toDelete.push_back(name);
            }
            file = root.openNextFile();
        }
        for (const String& name : toDelete) {
            String path = "/" + name;
            LittleFS.remove(path);
            removeOrphanedPresets(path, "");
        }

        preferences.putString(PK_BACKGROUND, "/face_default.bmp");
        selectedBackground = "/face_default.bmp";
        freeClockFaceBuffer();
        loadClockFace();
        loadHandSprites();
        updateClock();
    }


    // Loescht alle Zeigersaetze (hand_set*.bmp) - der Standardsatz 0 wird danach neu erzeugt. Raeumt
    // verwaiste Presets auf und schaltet auf den Standardsatz zurueck.

    // Deletes all hand sets (hand_set*.bmp) - the default set 0 is created again afterwards. Cleans up
    // orphaned presets and falls back to the default set.

    void resetHandsToDefault() {
        std::vector<String> toDelete;
        std::set<String> setIds;
        File root = LittleFS.open("/");
        File file = root.openNextFile();
        while (file) {
            String name = file.name();
            if (!file.isDirectory() && name.startsWith("hand_set") && name.endsWith(".bmp") && !isProtectedFile(name)) {
                toDelete.push_back(name);
                int start = 8; // Laenge von "hand_set"
                               // length of "hand_set"
                int end = name.indexOf('_', start);
                if (end > start) setIds.insert(name.substring(start, end));
            }
            file = root.openNextFile();
        }
        for (const String& name : toDelete) {
            LittleFS.remove("/" + name);
        }
        for (const String& setId : setIds) {
            removeOrphanedPresets("", setId);
        }

        preferences.putString(PK_HANDSET, "default");
        freeClockFaceBuffer();
        loadClockFace();
        loadHandSprites();
        updateClock();
    }


    // Schreibt eine Zeiger-Bitmapzeile ins Sprite, mittig zugeschnitten, falls
    // das Sprite (siehe updateHandWidths()) schmaler als das Bitmap ist - haelt
    // den Zeiger so zentriert auf dem Drehpunkt statt rechtsseitig verschoben.

    // Writes a hand bitmap row into its sprite, cropped in the CENTRE if the
    // sprite (see updateHandWidths()) is narrower than the bitmap - keeps the
    // hand centred on the pivot instead of shifted off it on the right.

    void pushHandRowCentered(LGFX_Sprite* sprite, int row, uint16_t* rowPixels, int srcWidth, const uint8_t* transparentColor) {
        int dstWidth = sprite->width();

        if (dstWidth > 0 && dstWidth < srcWidth) {
            int srcOffset = (srcWidth - dstWidth) / 2;
            memmove(rowPixels, rowPixels + srcOffset, (size_t)dstWidth * sizeof(uint16_t));
            srcWidth = dstWidth;
        }

        if (transparentColor) sprite->pushImage(0, row, srcWidth, 1, rowPixels, *transparentColor);
        else                  sprite->pushImage(0, row, srcWidth, 1, rowPixels);
    }


    void loadHandSprites() {

        // Zwischenbilder ungueltig machen: sie enthalten die alten Zeigerbilder
        // (anderer Zeigersatz oder andere Helligkeit).

        // Invalidate the composite images: they contain the old hand images
        // (different hand set or different brightness).

        clockAssetGeneration++;

        String setId = preferences.getString(PK_HANDSET, "");

        // Ein Puffer fuer alle drei Zeiger: Datei (neues oder altes Format, sonst Standardsatz 0), die alte Hoehe
        // jeweils oben transparent aufgefuellt.

        // One buffer for all three hands: file (new or old format, otherwise default set 0), the old height padded
        // transparent at the top in either case.

        uint16_t* pix = (uint16_t*)preferPsramMalloc((size_t)HAND_WIDTH * HAND_HEIGHT * sizeof(uint16_t));
        if (!pix) {
            DEBUG_PRINTLN("[HANDS] Error: couldnt allocate hand buffer");
            return;
        }

        struct HandConfig {
            const char* label;
            LGFX_Sprite* sprite;
        } hands[3] = {
            {"hour", &hourHandSprite},
            {"minute", &minuteHandSprite},
            {"second", &secondHandSprite}
        };

        for (auto& h : hands) {
            loadHandOrDefault(setId, h.label, pix);

            // Zeilenweise, damit der mittige Zuschnitt fuer schmalere Sprites greift
            // (siehe pushHandRowCentered()); jede Zeile wird komplett geschrieben.

            // Row by row, so the centre cropping for narrower sprites applies
            // (see pushHandRowCentered()); every row is written completely.

            for (int y = 0; y < HAND_HEIGHT; y++) {
                for (int x = 0; x < HAND_WIDTH; x++) {
                    uint16_t px = pix[y * HAND_WIDTH + x];
                    if (px == 0xFFFF) px = TRANSPARENT_COLOR;
                    rowBuffer[x] = setPixelBrightness(px);
                }
                pushHandRowCentered(h.sprite, y, rowBuffer, HAND_WIDTH, nullptr);
            }
        }
        free(pix);
    }


    // Hilfsfunktion: Winkel an die aktuelle Display-Rotation anpassen
    // Helper function: adjust angle to the current display rotation

    float shortestAngleDiff(float from, float to) {
        float diff = fmodf(to - from + 360.0f, 360.0f); // Modulo 360, um Werte im Bereich [0, 360) zu halten
                                                        // modulo 360 to keep values within [0, 360)
        if (diff > 180.0f) diff -= 360.0f;             // Kürzeste Richtung wählen
                                                       // choose the shortest direction
        return diff;
    }

    // Grosse Spruenge (erste Zeit, Korrektur, Rocrail): Zeiger laufen in HAND_MOVE_MS auf dem kuerzesten Weg,
    // auch rueckwaerts, mit sanftem Anfahren/Bremsen. Der Abstand zum Ziel schrumpft per Smoothstep; bewegt
    // sich das Ziel (z.B. NTP-Korrektur), fliesst das in den Restweg ein, statt dass der Zeiger springt.

    // Large jumps (first time, correction, Rocrail): the hands move in HAND_MOVE_MS along the shortest path,
    // also backwards, easing in and out. The distance to the target shrinks via smoothstep; if the target
    // moves (e.g. an NTP correction), that is folded into the remaining way instead of making the hand jump.

    const float HAND_MOVE_THRESHOLD_DEG = 10.0f;
    const unsigned long HAND_MOVE_MS = 3000;

    struct HandMove {
        bool active = false;
        float offset = 0.0f;      // angezeigt - Ziel, ungewrappt / shown minus target, unwrapped
        float lastTarget = 0.0f;
        float lastRemain = 1.0f;  // Restanteil (1 - Smoothstep) im letzten Bild / remaining share in the last frame
        unsigned long startMillis = 0;
    };

    float wrapAngle(float a) {
        a = fmodf(a, 360.0f);
        return (a < 0.0f) ? a + 360.0f : a;
    }

    float animateHand(HandMove& m, float shown, float target, unsigned long now) {
        if (!m.active) {
            float diff = shortestAngleDiff(shown, target);
            if (fabsf(diff) <= HAND_MOVE_THRESHOLD_DEG) return target;
            m.active = true;
            m.offset = -diff;
            m.lastTarget = target;
            m.lastRemain = 1.0f;
            m.startMillis = now;
            return shown;
        }

        // Zielbewegung seit dem letzten Bild auffangen: der Zeiger bleibt, wo er ist
        // Absorb the target's movement since the last frame: the hand stays where it is

        float jump = shortestAngleDiff(m.lastTarget, target);
        m.lastTarget = target;
        m.offset -= jump;
        if (fabsf(jump) > HAND_MOVE_THRESHOLD_DEG && m.lastRemain < 0.5f) {
            m.startMillis = now; // grosser Sprung spaet in der Animation: neu beginnen / large jump late in the animation: restart
            m.lastRemain = 1.0f;
        }

        float p = (float)(now - m.startMillis) / (float)HAND_MOVE_MS;
        if (p >= 1.0f) {
            m.active = false;
            return target;
        }
        float remain = 1.0f - p * p * (3.0f - 2.0f * p); // 1 - Smoothstep
        if (remain <= 0.0f) { // Rundung kurz vor p = 1 / rounding just before p = 1
            m.active = false;
            return target;
        }
        m.offset *= remain / m.lastRemain;
        m.lastRemain = remain;
        return wrapAngle(target + m.offset);
    }

    static float lastHourAngle = 0.0f;
    static float lastMinuteAngle = 0.0f;

    // Eigener Glaettungs-Zustand fuer Display 2 - relevant nur bei
    // unterschiedlicher Software-Rotation beider Displays. Bei Hardware-
    // Rotation haelt es dieselben Werte wie lastHourAngle/lastMinuteAngle.

    // Own smoothing state for Display 2 - only relevant when both displays
    // are rotated differently in software. With hardware rotation this ends
    // up holding the same values as lastHourAngle/lastMinuteAngle.

    static float lastHourAngle2 = 0.0f;
    static float lastMinuteAngle2 = 0.0f;
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
