holgiw/TFT-Clock-GC9A01/(commit log)

2025-06-24 .gitattributes und .gitignore hinzufügen.
2025-06-24 Projektdateien hinzufügen.
    [Grundplatte_rund_Glaskoben.stl, clock_esp32_S2_mini.lay6, senkrechte_platte_19x30.stl]
2025-11-21 Aktualisierung der Webserver-UI
2025-11-21 Konfigurations- und Code-Optimierungen vorgenommen
2025-11-21 Aktualisiere Board-Definition und verbessere Web-UI
2025-11-21 Projektkonfiguration und Funktionen überarbeitet
2025-12-16 NTP-Handling verbessert, Code bereinigt und XML angepasst
2026-01-30 MAX WLAN bug fixed 2.
    [uhr3.ino]
2026-01-31 wlan scan bug fixed
    [Grundplatte_rund_Glaskoben.stl, senkrechte_platte_19x30.stl]
2026-02-16 add RTC support
    [clock_esp32_S2_mini_RTC.lay6]
2026-02-18 Bug in non-station mode fixed
    [uhr3.ino]
2026-02-27 add DCF77 support
    [clock_esp32_S2_mini_RTC.lay6]
2026-04-23 dual display added
    [clock_esp32_S2_mini_RTC.lay6]
2026-05-13 The boot button can replace the external button
    [uhr3.ino]
2026-06-08 bugs removed
    [clock_esp32_S2_mini_RTC.lay6]
2026-07-19 html seiten überarbeitet, smaller bugs
    [config.h, declarations.h, display.h, globals.h, system_utils.h, time_sync.h, uhr3.ino, webserver_routes.h]
2026-08-17 UI changes, wlan AP issues
    [config.h, declarations.h, prefs_keys.h, translation.h, webserver_routes.h, wifi_manager.h]
2026-09-01 2nd display, rotation, bugfixes
    [config.h, declarations.h, display.h, globals.h, prefs_keys.h, system_utils.h, time_sync.h, translation.h]
2026-09-06 dcf77 bugs, info tab
    [config.h, declarations.h, globals.h, time_sync.h, translation.h, uhr3.ino, webserver_routes.h, wifi_manager.h]
2026-09-23 review: SNTP smooth sync fix, code-review follow-ups, comment cleanup
    [config.h, rocrail_client.h, system_utils.h, time_sync.h, uhr3.ino, webserver_routes.h, wifi_manager.h]
2026-09-23 ease forward second-hand skips from delayed frames, not just backward jumps
    [config.h, display.h]
2026-09-23 log RTC drift in seconds, skip RTC write when under 2s
    [config.h, declarations.h, time_sync.h]
2026-09-23 fix R2RNet multicast address (was the reserved All-Hosts group), add join-failure diagnostics
    [config.h, rocrail_client.h]
2026-09-26 skip unchanged clock frames, apply timezone before RTC read at boot
    [declarations.h, display.h, globals.h, presets_manager.h, time_sync.h, uhr3.ino, webserver_routes.h]
2026-09-26 throttle R2RNet debug packet logging to the first 20 per join
2026-09-27 add in-browser hand designer, fix /preview hand widths and hour angle
    - new /handdesigner page (hand_designer_html.h, streamed from flash):
    pixel editor, shape generator, free colour palette, zoom, live preview
    on the current face; based on the active hand set, saves as a new set
    or overwrites and applies the active one
    - /api/defaulthand and /api/defaultface serve the built-in graphics
    - /preview crops hands to the face's hand widths and uses the
    second-accurate hour angle like the display
    - setPixelBrightness never dims a visible pixel into TRANSPARENT_COLOR
    [display.h, globals.h, translation.h, uhr3.ino, webserver_routes.h]
2026-09-27 add clock face designer, hands may reach the display edge
    - new /facedesigner page (face_designer_html.h): face generator, pixel
    tools with pen width and mirror/rotation symmetry, text straight,
    rotated or on an arc, installed or loaded fonts, logo stamp, image
    import, live preview with the active hands; saves as a new face or
    overwrites and applies the active one
    - both designers: quick colour pick (button, right-click, preview click),
    short hint per tool, wider number inputs
    - new hand format: pivot fixed per display at the display radius
    (21x151 pivot 120, 13x100 pivot 80); old hands (21x131 / 13x86) are
    padded transparent at the top when loaded and never stretched on
    uplo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
    [config.h, declarations.h, display.h, translation.h, uhr3.ino, webserver_routes.h]
2026-09-27 designer previews move the hands like the clock
    - station mode (second races and waits at 12), smooth or ticking second,
    smooth or jumping minute, same formulas as /preview
    - live preview redrawn per animation frame, paused in hidden tabs;
    face designer caches the face canvas
    - short line under the preview names the active hand style
    [webserver_routes.h]
2026-09-28 fix station-clock second hand jumping forward and back after ~4.7 h uptime
    stationLastMillis (uint32) was advanced by a float step; beyond 2^24 ms the
    float rounding occasionally put the step timestamp 1 ms in the future, the
    unsigned difference overflowed and the hand sat one step ahead for a frame.
    Advance it as an integer and evaluate the difference signed.
    [display.h]
2026-09-28 build marker per display type, hand upload space check for the new format
    - config.h: BUILD_DISPLAY_MARKER "UHR3_BUILD_DISPLAY=<display>" from the
    display defines, shown on the info pages so every .bin names its display
    - /handsets: free-space check sized for an uncompressed hand file in the
    new format (was a fixed 5818 bytes, a 21x151 upload needs 6710)
    - GC9A01 build copied to build_GC9A01
    [config.h, webserver_routes.h]
2026-09-28 screenshots de/en, UI translations, move datasheets to PCB
2026-09-28 fix day window display on status/info page
    [declarations.h, webserver_routes.h]
2026-09-28 start.bat: handle the two COM ports of the ESP32-S2 (1200 baud touch into download mode)
2026-09-28 TFT-Pins in config.h/readme korrigiert, GC9D01-Groesse auf Status/Info
    [config.h, webserver_routes.h]
2026-09-28 ADC-Schwellwert max. 100 statt 255 (Backlight-Builds)
2026-09-29 readme_text.h und doppelte readme.txt entfernt
2026-09-29 README und Anleitungen an die Weboberflaeche angeglichen
2026-09-29 README: Rocrail switch location, navigation names, hardware section
2026-09-30 Remove all files (re-added in next commit)
    [Grundplatte_rund_Glaskoben.stl, clock_esp32_S2_mini.lay6, clock_esp32_S2_mini_RTC.lay6, senkrechte_platte_19x30.stl]
2026-09-30 update clock3 to clock4
    [Grundplatte_rund_Glaskoben.stl, clock_esp32_S2_mini.lay6, clock_esp32_S2_mini_RTC.lay6, senkrechte_platte_19x30.stl]
2026-09-30 flashESP: hint for new ESP32-S2 without program (boot mode)
2026-09-30 Presets store the strip, preset preview with strip, per-font VLW files, remove preset button switching and dead code, new build
2026-09-30 Preview page: strip seamlessly below/above the clock face, fix div nesting, new build
    [webserver_routes.h]
2026-09-30 Uniform success/warning/error messages in the dark design, errors shown red; new build
    [webserver_routes.h]
2026-10-01 Backup with status and logs, merged duplicated code, build info in uhr4.ino, designer save buttons; new build
2026-10-02 Remove built-in default clock face, clock draws face_default.bmp itself when missing; new build
    [config.h, declarations.h, display.h, translation.h, webserver_routes.h]
2026-10-02 Remove built-in default hands, clock draws default hand set 0 (like set 2) when missing; remove clock_default.h; new build
    [config.h, declarations.h, display.h, translation.h, webserver_routes.h]
2026-10-06 Update wiring diagrams
2026-10-06 Add Waveshare ESP32-C6 boards, starter set, cross-display restore
2026-10-06 Add button to take over the device time
2026-10-08 Tighten README and flash readme, add ESP32-C6 brightness and pinout
2026-10-08 Tighten CHANGELOG, describe the time/date strip position correctly
2026-10-08 Add ESP32-S3 build, open-WiFi time and per-face strip settings
    - ESP32-S3-LCD-1.28 build with OTA update and IMU auto rotation
    - Time from open WiFi at boot, hourly reconnect, AP fixes
    - Button stages (WiFi reset, factory reset) with new text screens
    - Strip: time/date/weekday groups, sizes, on/off, settings per face
    - Hands at 12 and empty strip until a time arrives
    - PWM 50 % during setup, gamma only with light sensor, C6 warning
    [backup.h, config.h, declarations.h, display.h, globals.h, imu_rotation.h, lgfx_config.h]
2026-10-08 Update ESP32-S3 build (untested on the device)
2026-10-09 Keep existing faces, hands and presets on restore
    Same-named ones from the backup replace them, new presets go into free
    slots. Updated builds for S2, C6 and S3 (S3 untested on the device).
    [backup.h, translation.h, webserver_routes.h]
2026-10-09 Add seconds subdial and always complete the starter set
    - Second hand pivot per clock face (facecfg_*.txt), drawn below the large hands
    - Starter face_subdial with its own hand set and preset
    - Missing starter faces, hand sets and presets are created at every start
    - Updated S2 and C6 builds (S3 build not yet updated)
    [backup.h, declarations.h, display.h, globals.h, prefs_keys.h, presets_manager.h]
2026-10-09 Protect built-in sets, renumber hand sets, automatic WiFi TX power
    - Built-in faces and hand sets cannot be deleted or overwritten, restore renames
    clashing hand sets, hand sets are renumbered at start and stored in the new format
    - C6 partition table uhr4_c6, S3 build requires PSRAM
    - WiFi transmit power steps per network, WPA2 first, disconnect reason and link test
    in the log, time from open WiFi via a portal page
    - Face and hand set selection without reload, chip in header and backup name,
    hub colour from the toolbox, flashESP keeps a serial monitor open
    [uhr4_c6.csv]
2026-10-10 Hands move to position without stutter, no automatic update check, one log line per I2C address
2026-10-10 Changelog link on the update page (ESP32-S3)
2026-10-10 Update ESP32-S2 and ESP32-C6 builds (open WiFi time: six networks)
